SimonRZz/SX1280_QO100_SSB_TX/img/SX1280 GPSDO CW Carrier.png

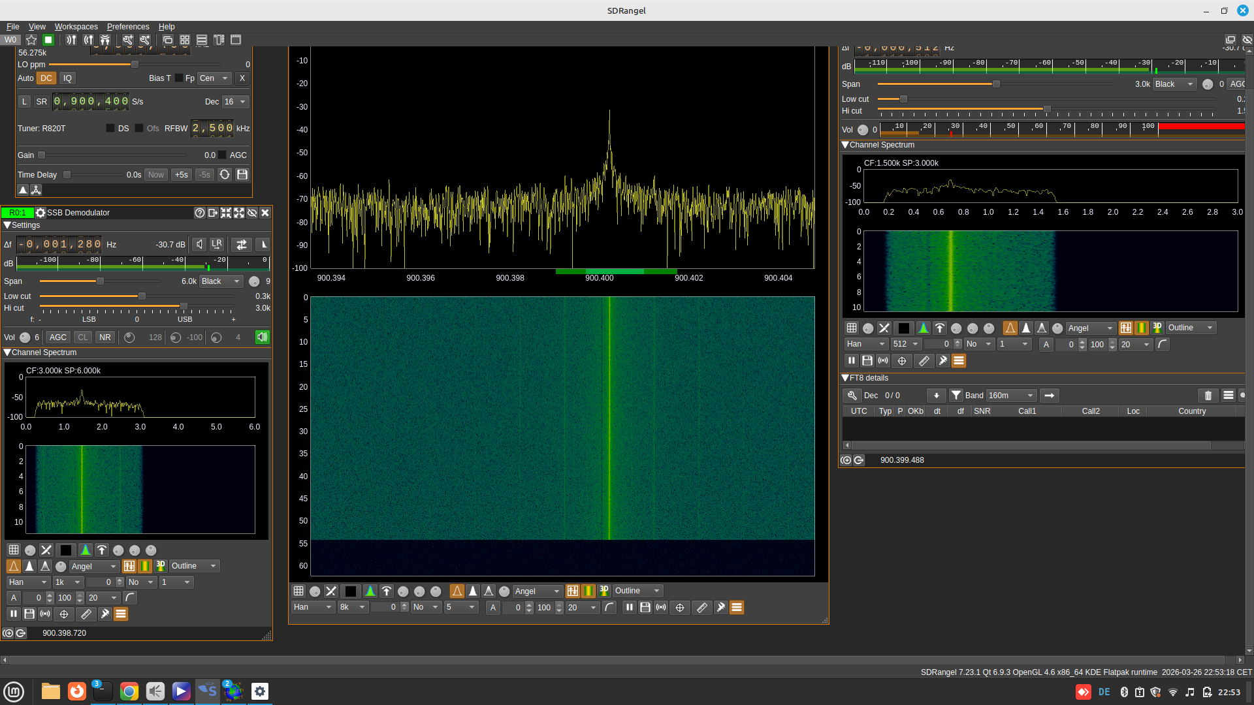
img/SX1280 GPSDO CW Carrier.png
