SimonRZz/SX1280_QO100_SSB_TX/img/SX1280 TCXO FT8.png

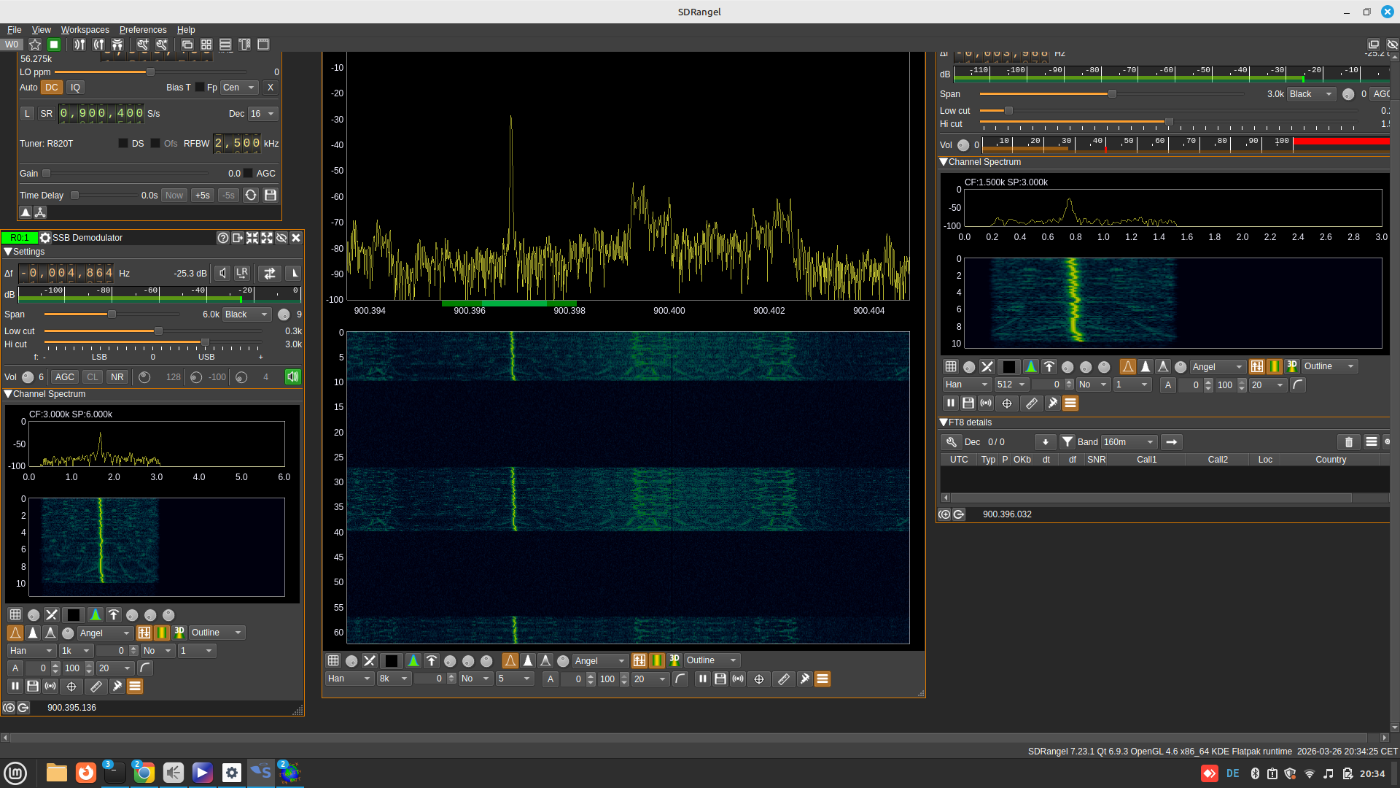
img/SX1280 TCXO FT8.png
