SimonRZz/SX1280_QO100_SSB_TX/main.c

#include <stdint.h>
#include <stdbool.h>
#include <math.h>
#include <string.h>
#include <stdio.h>
#include <stdarg.h>
#include <stdlib.h>

#include "pico/stdlib.h"
#include "pico/multicore.h"
#include "pico/flash.h"
#include "hardware/flash.h"
#include <stddef.h>

#include "hardware/spi.h"
#include "hardware/gpio.h"
#include "hardware/clocks.h"
#include "hardware/i2c.h"
#include "hardware/pwm.h"
#include "hardware/dma.h"
#include "hardware/irq.h"
#include "hardware/adc.h"

// TinyUSB
#include "bsp/board_api.h"
#include "tusb.h"
#include "usb_descriptors.h"

// OLED display
#include "ssd1306.h"

// GPSDO (SI5351 52 MHz clock gen + NEO-7M GPS)
#include "gpsdo.h"
#include "si4732.h"
#include "fw_build_info.h"

#ifndef M_PI
#define M_PI 3.14159265358979323846
#endif

// ================== MODE ==================
#define FIXED_POWER_CW_MODE     0
#define FIXED_TX_POWER_DBM      (13)
// ==========================================

// ================== TEST MODE ==================
#define USE_TEST_TONE       0
#define USE_TWO_TONE_TEST   1

#define TEST_TONE_HZ        1000.0f
#define TEST_TONE2_HZ       1900.0f

#define TEST_TONE_AMPL      0.35f
#define TEST_BLOCK_SAMPLES  8000u
// ===============================================

// ================== DITHER SPEED-UP ==================
#define DITHER_SUBSTEPS     4
// ===============================================

// ================== BUFFERING ==================
#define BLOCK_SAMPLES       256u
#define NUM_BLOCKS          8u   // increased from 2 to prevent underruns
// ===============================================

// ================== UNDERRUN DIAGNOSTICS ==================
#define UNDERRUN_LED_ENABLE   1
#define UNDERRUN_LED_PULSE_MS 20u
// ===============================================

// ================== AUDIO SHAPING (default values) ==================
#define AUDIO_ENABLE_BANDPASS       1
#define AUDIO_BP_LO_HZ              50.0f
#define AUDIO_BP_HI_HZ              2700.0f
#define AUDIO_BP_MAX_STAGES         10      // Max stages (compile-time allocation)
#define AUDIO_BP_DEFAULT_STAGES     7       // Default stages (runtime adjustable, 1-10)
// Each stage = 12 dB/octave, so 7 stages = 84 dB/oct, 10 stages = 120 dB/oct

#define AUDIO_ENABLE_EQ             1
#define EQ_LOW_SHELF_HZ             190.0f
#define EQ_LOW_SHELF_DB             (-2.0f)
#define EQ_HIGH_SHELF_HZ            1700.0f
#define EQ_HIGH_SHELF_DB            (13.5f)
// ===============================================

// ================== COMPRESSION (default values) ==================
#define AUDIO_ENABLE_COMPRESSOR     1
#define COMP_THRESHOLD_DB           (-2.5f)
#define COMP_RATIO                  (6.1f)
#define COMP_ATTACK_MS              (41.1f)
#define COMP_RELEASE_MS             (1595.0f)
#define COMP_MAKEUP_DB              (0.0f)
#define COMP_KNEE_DB                (16.5f)
#define COMP_OUTPUT_LIMIT           (0.940f)
// ===============================================

// ================== FIRMWARE VERSION ==================
#define FW_VERSION      "2.3.1-rx"
#define FW_BUILD        __DATE__ " " __TIME__
// ======================================================

// ================== MODULE VARIANT ==================
// Set to 1 if using LoRa1280F27-TCXO module
// Set to 0 if using SX1280 V1.0 (no PA) with SI5351 52 MHz on XTA
#define USE_TCXO_MODULE     0
// ====================================================

// ---------------- Pin mapping ----------------
static const uint32_t PIN_MISO  = 16;
static const uint32_t PIN_MOSI  = 19;
static const uint32_t PIN_SCK   = 18;
static const uint32_t PIN_NSS   = 17;

static const uint32_t PIN_RX_EN = 14;
static const uint32_t PIN_TX_EN = 15;

static const uint32_t PIN_RESET = 20;
static const uint32_t PIN_BUSY  = 21;

#if USE_TCXO_MODULE
static const uint32_t PIN_TCXO_EN = 22;
#endif

// ---------------- OLED I2C pins ----------------
#define OLED_I2C       i2c1
#define OLED_I2C_BAUD  100000  // 100 kHz — reliable with Pico internal pull-ups (~50 kΩ)
static const uint32_t PIN_OLED_SDA = 6;
static const uint32_t PIN_OLED_SCL = 7;

// ---------------- Encoder + buttons ----------------
static const uint32_t PIN_ENC_A   = 2;   // Encoder phase A
static const uint32_t PIN_ENC_B   = 3;   // Encoder phase B
static const uint32_t PIN_ENC_OK  = 10;  // Encoder push button (GP4 occupied by GPSDO UART1 TX)
static const uint32_t PIN_KEY_DIT = 9;   // CW dit paddle (active LOW, internal pull-up)
static const uint32_t PIN_KEY_DAH = 11;  // CW dah paddle (active LOW, internal pull-up; GP10 used by ENC_OK)

// ---------------- SPI config ----------------
#define SX_SPI spi0
static const uint32_t SX_SPI_BAUD = 18000000;

// ---------------- SX1280 opcodes ----------------
#define OPCODE_SET_STANDBY         0x80
#define OPCODE_SET_FS              0xC1   // Lock PLL without starting TX
#define OPCODE_SET_PACKET_TYPE     0x8A
#define OPCODE_SET_RF_FREQUENCY    0x86
#define OPCODE_SET_TX_PARAMS       0x8E
#define OPCODE_SET_TX_CW           0xD1

// ---------------- RF/audio params ----------------
#define BASE_FREQ_HZ        2400400000u
#define WAV_SAMPLE_RATE     8000u

#define PWR_MAX_DBM         (13)
#define PWR_MIN_DBM         (-18)

#define AMP_GAIN            2.9f
#define AMP_MIN_A           0.000002f

#define RAMP_TIME           0xE0     // 20 us

// --- Runtime RF config (adjustable via CDC) ---
// Frequency stored as double for sub-Hz precision; automatically split into PLL steps + fine DSP offset
static volatile double g_target_freq_hz = (double)BASE_FREQ_HZ;
static volatile float g_ppm_correction = 0.0f;
static volatile uint8_t g_cw_test_mode = 0;  // 1 = CW test active (blocks normal Core1 operation)
static volatile int8_t g_tx_power_max_dbm = PWR_MAX_DBM;  // Runtime TX power limit
static volatile uint8_t g_tx_enabled = 1;  // TX enable flag (for GUI TX button)
static volatile uint8_t g_tx_mode = 0;     // 0 = USB (SSB), 1 = CW
static volatile uint8_t g_tune_active = 0; // 1 = TUNE carrier active
static volatile uint8_t g_ptt_key = 0;     // 1 = dit or dah paddle pressed (live)
static volatile uint8_t g_key_dit = 0;     // dit paddle (GP9), debounced
static volatile uint8_t g_key_dah = 0;     // dah paddle (GP11), debounced
static volatile uint8_t g_soft_ptt_key = 0; // Software PTT/KEY via CDC "key 0|1" (GUI CW keyer)

// --- SSB push-to-talk (GP13) ---
// Without this, SSB keys purely on audio amplitude: with a live microphone
// that is permanent VOX, and any room noise goes on the air. The PTT gates
// microphone transmission. PC audio is left alone, so WSJT-X and friends
// keep working without a hardware switch.
// The PTT is the CW paddle itself — either contact. In SSB the keyer is
// inactive (keyer_poll() returns early unless g_tx_mode == 1), so the paddle
// is free to serve as the press-to-talk lever and needs no extra pin.
static volatile uint8_t g_ptt_required = 1;  // 1 = MIC mode needs the paddle held

// --- On-device CW keyer (paddles GP9/GP11 → element timing in firmware) ---
enum { KEYER_STRAIGHT = 0, KEYER_IAMBIC_A = 1, KEYER_IAMBIC_B = 2 };
static volatile uint8_t g_cw_mode   = KEYER_IAMBIC_B;
static volatile uint8_t g_cw_wpm    = 18;      // 5..60
static volatile float   g_cw_ratio  = 3.0f;    // dah length in dits, 2.0..5.0
static volatile uint8_t g_keyer_key = 0;       // keyer output: 1 = key down
static void keyer_reset(void);
static const char *keyer_mode_name(uint8_t m);
static void keyer_diag_print(void);
static void persist_diag_print(void);

// --- Sidetone (PWM audio on GP12, follows keyer output and TUNE) ---
static volatile uint16_t g_st_hz   = 700;    // 300..1200
static volatile uint8_t  g_st_vol  = 30;     // 0..100
static volatile uint8_t  g_st_test = 0;      // 1 = continuous test tone (not persisted)
static void sidetone_update_params(void);

// --- Audio source: USB from the PC, or the MAX4466 microphone on GP26 (ADC0) ---
enum { AUDIO_SRC_PC = 0, AUDIO_SRC_MIC = 1 };
static volatile uint8_t g_audio_src = AUDIO_SRC_PC;
static volatile float   g_mic_gain  = 10.0f;   // 1..50, applied after DC removal
static volatile float   g_mic_gate  = 0.02f;   // 0..0.5, noise gate threshold on the gained signal
static const char *audio_src_name(uint8_t s);
static void mic_diag_print(void);

// --- Receive audio monitor (Si4732 LOUT on GP27 / ADC1 -> headphones) ---
// Defined down with the microphone, which owns the ADC it borrows.
static void    rxmon_task(void);
static void    rxmon_set(bool on);
static bool    rxmon_is_on(void);
static void    rxmon_set_vol(uint8_t pct);
static bool    rxmon_set_cw(long width_hz, long centre_hz);   // width 0 = off; centre 0 = keep
static void    rxmon_set_level(uint8_t pct);
static void    rxmon_set_maxgain(uint8_t db);
static void    rxmon_set_hang(uint16_t ms);
// Display RSSI/SNR polling over I2C, 5 Hz. Switchable to test it as a
// source of crackle in the headphones. Not persisted.
static volatile bool g_rx_rsq_poll = true;
static uint8_t rxmon_vol_pct(void);
static void    rxmon_set_agc(bool on);
static bool    rxmon_agc_on(void);
static void    rxmon_diag_print(void);
// GPS gate: 1 = TX only when gpsdo_is_ready() (default), 0 = override for bench tests.
// Deliberately not persisted — resets to enforced on every boot.
static volatile uint8_t g_gps_gate = 1;

// Blank the TX for a moment after a mode change, so scrolling through the
// modes on the encoder (or a burst of "mode" commands) cannot emit a stub.
#define TX_MODE_GUARD_MS 120
static volatile uint32_t g_mode_change_ms = 0;
static inline void tx_mode_changed(void) { g_mode_change_ms = to_ms_since_boot(get_absolute_time()); }
static inline bool tx_mode_guard_active(void) {
    return (to_ms_since_boot(get_absolute_time()) - g_mode_change_ms) < TX_MODE_GUARD_MS;
}

// True when the microphone path is held back by the PTT (either paddle contact).
static inline bool ssb_ptt_blocks(void) {
    return (g_tx_mode == 0) && (g_audio_src == AUDIO_SRC_MIC) && g_ptt_required && !g_ptt_key;
}

static inline bool tx_allowed(void) {
    return (gpsdo_is_ready() || !g_gps_gate) && !tx_mode_guard_active();
}

// --- Persistent config (last flash sector) ---
static volatile uint8_t  g_persist_dirty       = 0;  // something worth saving changed
static volatile uint32_t g_persist_dirty_since = 0;  // ms of last change
static uint8_t           g_persist_loaded      = 0;  // 1 = a valid record exists in flash
static int               g_persist_last_rc     = 1;  // last flash_safe_execute() result, 1 = never tried
static uint32_t          g_persist_saves       = 0;  // successful writes since boot

// Last moment the PA was actually driven — SSB block, CW element or TUNE.
// A flash write parks Core1 for ~20 ms, so autosave waits until the radio
// has been quiet for a while.
static volatile uint32_t g_tx_activity_ms = 0;
static inline void tx_activity_mark(void) {
    g_tx_activity_ms = to_ms_since_boot(get_absolute_time());
}

// The main loop autosaves after an idle period, so knob turns don't erase flash repeatedly.
static inline void persist_mark_dirty(void) {
    g_persist_dirty = 1;
    g_persist_dirty_since = to_ms_since_boot(get_absolute_time());
}

// --- Encoder UI state ---
// The frequency stays on top; the lower half shows one of three pages.
// Pages 0 and 1 hold 2x3 tiles (short click = browse), page 2 is GPS info.
// A long press (500 ms) switches to the next page.
typedef enum {
    UI_PARAM_MODE = 0,   // USB PC / USB MIC / CW
    UI_PARAM_TUNE,       // TUNE on/off
    UI_PARAM_WPM,        // keyer speed
    UI_PARAM_TX,         // TX on/off
    UI_PARAM_VOL,        // sidetone volume
    UI_PARAM_PWR,        // TX power dBm
    UI_PARAM_KEYER,      // straight / iambic A / iambic B
    UI_PARAM_RATIO,      // dah length in dits
    UI_PARAM_TONE,       // sidetone pitch
    UI_PARAM_MICGAIN,
    UI_PARAM_MICGATE,
    // --- receive page ---
    UI_PARAM_RXSTEP,     // tuning step of the encoder
    UI_PARAM_RXMODE,     // AM / LSB / USB
    UI_PARAM_RXBW,       // channel filter
    UI_PARAM_RXMON,      // headphone monitor level, 0 = off
    UI_PARAM_RXVOL,      // how hard the Si4732 drives the ADC
    UI_PARAM_RXAGC       // audio AGC
} ui_param_t;

// Encoder steps for receive tuning. 10 Hz is what SSB needs, 9 kHz is the
// channel spacing of the broadcast bands outside the Americas.
static const uint32_t k_rx_steps[]  = { 10u, 100u, 1000u, 5000u, 9000u };
static const char * const k_rx_step_names[] = { "10 Hz", "100 Hz", "1 kHz", "5 kHz", "9 kHz" };
#define RX_STEP_N  (sizeof k_rx_steps / sizeof k_rx_steps[0])
static volatile uint8_t g_rx_step_idx = 2;      // 1 kHz

// The filters the Si4732 actually has; si4732_set_bandwidth_hz() snaps to the
// nearest, so stepping through this list cannot land between two of them.
static const uint16_t k_rx_bws[] = { 1000u, 1800u, 2000u, 2500u, 3000u, 4000u, 6000u };
#define RX_BW_N    (sizeof k_rx_bws / sizeof k_rx_bws[0])

// Signal quality for the display, refreshed on a timer by rxmon_task(). Read
// directly in the draw path it would put an I2C transfer inside the frame
// that is also built from the transmit wait loops.
static volatile uint8_t g_rx_rssi = 0, g_rx_snr = 0;

// Where the dial has been turned to. A tune is an I2C exchange that waits for
// the chip's tune-complete flag, so doing one per encoder detent would make
// the dial stick. The encoder only writes this; rxmon_task() applies it, at
// most every 30 ms, so spinning the knob costs one tune and not fifty.
static volatile uint32_t g_rx_want_hz  = 0;
static volatile bool     g_rx_want     = false;

static inline uint32_t rx_shown_hz(void) {
    return g_rx_want ? g_rx_want_hz : si4732_get_hz();
}

typedef enum {
    UI_STATE_IDLE = 0,   // encoder = frequency; click = browse tiles; hold = next page
    UI_STATE_BROWSE,     // frame around a tile, rotate moves cursor; hold = back
    UI_STATE_EDITING     // tile inverted, rotate adjusts value; hold = back
} ui_state_t;

#define UI_PAGES         4                    // 0 operating, 1 CW/audio, 2 GPS, 3 receive
#define UI_TILES         6                    // 2 columns x 3 rows on tile pages
#define UI_TIMEOUT_MS    5000                 // BROWSE/EDITING fall back to IDLE
#define UI_LONG_PRESS_MS 500

static const ui_param_t k_page_tiles[3][UI_TILES] = {
    { UI_PARAM_MODE,  UI_PARAM_TUNE,  UI_PARAM_WPM, UI_PARAM_TX,   UI_PARAM_VOL,     UI_PARAM_PWR     },
    { UI_PARAM_KEYER, UI_PARAM_RATIO, UI_PARAM_WPM, UI_PARAM_TONE, UI_PARAM_MICGAIN, UI_PARAM_MICGATE },
    { UI_PARAM_RXSTEP, UI_PARAM_RXMODE, UI_PARAM_RXBW, UI_PARAM_RXMON, UI_PARAM_RXVOL, UI_PARAM_RXAGC },
};

// Which row of k_page_tiles a page uses; -1 for a page that has no tiles.
// Page 2 (GPS) is display-only, so the mapping is not the identity.
static int ui_tile_row(uint8_t page)
{
    switch (page) {
        case 0:  return 0;
        case 1:  return 1;
        case 3:  return 2;
        default: return -1;
    }
}

static volatile ui_state_t g_ui_state = UI_STATE_IDLE;
static volatile uint8_t    g_ui_page = 0;                  // 0 operating, 1 CW/audio, 2 GPS info
static volatile uint8_t    g_ui_cursor_idx = 0;            // tile index on the current page
static volatile ui_param_t g_ui_cursor = UI_PARAM_MODE;    // param under the cursor (derived)
static volatile ui_param_t g_ui_editing = UI_PARAM_MODE;   // which param is being edited
static volatile uint32_t   g_ui_last_activity_ms = 0;      // for auto-timeout
// OLED noise isolation, not persisted. g_oled_freeze stops the frame
// refresh (I2C1 bursts at 5 Hz) but leaves the panel lit; g_oled_off also
// switches the panel and its charge pump off. Between them they separate the
// two ways the display can get into a receiver.
static volatile uint8_t    g_oled_freeze = 0;
static volatile uint8_t    g_oled_off    = 0;
static volatile uint8_t    g_oled_flip = 1;                // 180 degree rotation; 1 suits how the box is built

// Blink phase for warnings on the display (2 Hz; the panel refreshes at 5 fps)
static inline bool ui_blink(void) {
    return ((to_ms_since_boot(get_absolute_time()) / 500u) & 1u) != 0u;
}

// --- Hilbert ---
#define HILBERT_TAPS        247

// --- PLL step ---
static const float PLL_STEP_HZ =
    (float)(52000000.0 / (double)(1u << 18)); // ~198.364 Hz

#define F_OFF_LIMIT_HZ      3500.0f
#define SILENCE_SECONDS     2u

#define GATE_A_REF          0.01f   // Noise gate threshold - higher with compressor
#define GATE_SHAPE          1

#define IQ_GAIN_CORR        1.00f
#define IQ_PHASE_CORR_DEG   0.0f

// ---------------- Command buffer ----------------
typedef struct {
    int32_t  freq_steps;
    int8_t   p_dbm;
    uint8_t  tx_on;
} sample_cmd_t;

static sample_cmd_t g_blocks[NUM_BLOCKS][BLOCK_SAMPLES];

static volatile uint32_t g_prod_block = 0;
static volatile uint32_t g_cons_block = 0;
static volatile uint8_t  g_block_ready[NUM_BLOCKS] = {0};
static volatile uint32_t g_underruns = 0;
static volatile uint8_t  g_core1_start = 0; 

// ==========================================================
// USB AUDIO IN (from PC) -> ringbuffer -> resampler to 8k mono
// ==========================================================

typedef struct { int16_t l, r; } stereo16_t;

// Power-of-two
#ifndef USB_RB_FRAMES
#define USB_RB_FRAMES 8192u
#endif

#if (USB_RB_FRAMES & (USB_RB_FRAMES - 1u)) != 0
#error "USB_RB_FRAMES must be power-of-two"
#endif

static stereo16_t g_usb_rb[USB_RB_FRAMES];
static volatile uint32_t g_usb_w = 0;
static volatile uint32_t g_usb_r = 0;

static volatile uint32_t g_usb_sample_rate_hz = 48000u; // current host SR

static inline uint32_t usb_rb_next(uint32_t x) { return (x + 1u) & (USB_RB_FRAMES - 1u); }

static inline bool usb_rb_push(stereo16_t s) {
    uint32_t w = g_usb_w;
    uint32_t n = usb_rb_next(w);
    if (n == g_usb_r) return false; // full
    g_usb_rb[w] = s;
    g_usb_w = n;
    return true;
}

static inline bool usb_rb_pop(stereo16_t *out) {
    uint32_t r = g_usb_r;
    if (r == g_usb_w) return false; // empty
    *out = g_usb_rb[r];
    g_usb_r = usb_rb_next(r);
    return true;
}

static inline int16_t clamp16(int32_t x) {
    if (x > 32767) return 32767;
    if (x < -32768) return -32768;
    return (int16_t)x;
}

// Read host audio (PCM16LE stereo), push to ringbuffer
static void usb_audio_pump(void);

// Resampler: host SR stereo -> 8 kHz mono
// With smoothed adaptive rate to prevent buffer overflow and pitch artifacts
static int16_t usb_audio_get_mono_8k(void) {
    static uint32_t src_rate = 48000u;
    static uint32_t base_step_q16 = 0;
    static uint32_t smooth_step_q16 = 0;  // Smoothed step for gradual changes
    static uint32_t phase_q16 = 0;

    static stereo16_t s0 = {0,0};
    static stereo16_t s1 = {0,0};
    static stereo16_t s2 = {0,0};  // Extra sample for cubic interpolation
    static stereo16_t sm1 = {0,0}; // s[-1] for cubic
    static bool primed = false;

    uint32_t sr = g_usb_sample_rate_hz;
    if (!sr) sr = 48000u;

    if (sr != src_rate || base_step_q16 == 0) {
        src_rate = sr;
        base_step_q16 = (uint32_t)(((uint64_t)src_rate << 16) / (uint32_t)WAV_SAMPLE_RATE);
        smooth_step_q16 = base_step_q16;
    }

    // *** Adaptive rate with heavy smoothing ***
    uint32_t usb_w = g_usb_w;
    uint32_t usb_r = g_usb_r;
    uint32_t fill = (usb_w >= usb_r) ? (usb_w - usb_r) : (USB_RB_FRAMES - usb_r + usb_w);
    
    const uint32_t target_fill = USB_RB_FRAMES / 2;
    uint32_t target_step = base_step_q16;
    
    if (fill > target_fill) {
        uint32_t excess = fill - target_fill;
        uint32_t adj = (base_step_q16 * excess) / (USB_RB_FRAMES * 10);
        target_step = base_step_q16 + adj;
    } else if (fill < target_fill) {
        uint32_t deficit = target_fill - fill;
        uint32_t adj = (base_step_q16 * deficit) / (USB_RB_FRAMES * 10);
        target_step = base_step_q16 - adj;
    }
    
    // Heavy smoothing: move only 1/256 of the way to target each sample
    // This prevents audible pitch wobble
    if (smooth_step_q16 < target_step) {
        uint32_t diff = target_step - smooth_step_q16;
        smooth_step_q16 += (diff >> 8) + 1;
        if (smooth_step_q16 > target_step) smooth_step_q16 = target_step;
    } else if (smooth_step_q16 > target_step) {
        uint32_t diff = smooth_step_q16 - target_step;
        smooth_step_q16 -= (diff >> 8) + 1;
        if (smooth_step_q16 < target_step) smooth_step_q16 = target_step;
    }

    if (!primed) {
        if (!usb_rb_pop(&sm1)) sm1 = (stereo16_t){0,0};
        if (!usb_rb_pop(&s0)) s0 = (stereo16_t){0,0};
        if (!usb_rb_pop(&s1)) s1 = (stereo16_t){0,0};
        if (!usb_rb_pop(&s2)) s2 = (stereo16_t){0,0};
        phase_q16 = 0;
        primed = true;
    }

    phase_q16 += smooth_step_q16;
    while (phase_q16 >= (1u << 16)) {
        phase_q16 -= (1u << 16);
        sm1 = s0;
        s0 = s1;
        s1 = s2;
        if (!usb_rb_pop(&s2)) s2 = s1;  // Hold last value if empty
    }

    // Cubic Hermite interpolation for smoother audio
    float t = (float)phase_q16 / 65536.0f;
    float t2 = t * t;
    float t3 = t2 * t;
    
    // Hermite basis functions
    float h00 = 2*t3 - 3*t2 + 1;
    float h10 = t3 - 2*t2 + t;
    float h01 = -2*t3 + 3*t2;
    float h11 = t3 - t2;
    
    // Left channel
    float m0_l = (float)(s1.l - sm1.l) * 0.5f;
    float m1_l = (float)(s2.l - s0.l) * 0.5f;
    float l = h00 * s0.l + h10 * m0_l + h01 * s1.l + h11 * m1_l;
    
    // Right channel
    float m0_r = (float)(s1.r - sm1.r) * 0.5f;
    float m1_r = (float)(s2.r - s0.r) * 0.5f;
    float r = h00 * s0.r + h10 * m0_r + h01 * s1.r + h11 * m1_r;

    float mono = (l + r) * 0.5f;
    return clamp16((int32_t)mono);
}

// ==========================================================
// TinyUSB UAC1 control callbacks (sampling freq + feature unit)
// ==========================================================

// Minimal feature unit state (żeby Windows nie marudził)
static uint8_t  g_mute[CFG_TUD_AUDIO_FUNC_1_N_CHANNELS_RX + 1];
static int16_t  g_volume[CFG_TUD_AUDIO_FUNC_1_N_CHANNELS_RX + 1]; // 1/256 dB

bool tud_audio_set_itf_cb(uint8_t rhport, tusb_control_request_t const *p_request) {
    (void)rhport;
    (void)p_request;
    return true;
}

bool tud_audio_set_itf_close_ep_cb(uint8_t rhport, tusb_control_request_t const *p_request) {
    (void)rhport;
    (void)p_request;
    return true;
}

// EP sampling freq (UAC1)
bool tud_audio_set_req_ep_cb(uint8_t rhport, tusb_control_request_t const *p_request, uint8_t *pBuff) {
    (void)rhport;
    uint8_t ctrlSel = TU_U16_HIGH(p_request->wValue);

    if (ctrlSel == AUDIO10_EP_CTRL_SAMPLING_FREQ &&
        p_request->bRequest == AUDIO10_CS_REQ_SET_CUR) {
        TU_VERIFY(p_request->wLength == 3);
        uint32_t sr = tu_unaligned_read32(pBuff) & 0x00FFFFFF;
        if (sr) g_usb_sample_rate_hz = sr;
        return true;
    }
    return false;
}

bool tud_audio_get_req_ep_cb(uint8_t rhport, tusb_control_request_t const *p_request) {
    uint8_t ctrlSel = TU_U16_HIGH(p_request->wValue);

    if (ctrlSel == AUDIO10_EP_CTRL_SAMPLING_FREQ &&
        p_request->bRequest == AUDIO10_CS_REQ_GET_CUR) {
        uint32_t sr = g_usb_sample_rate_hz;
        uint8_t freq[3] = {
            (uint8_t)(sr & 0xFF),
            (uint8_t)((sr >> 8) & 0xFF),
            (uint8_t)((sr >> 16) & 0xFF)
        };
        return tud_audio_buffer_and_schedule_control_xfer(rhport, p_request, freq, sizeof(freq));
    }
    return false;
}

// Feature Unit (mute/volume) – UAC1 entity callbacks
bool tud_audio_set_req_entity_cb(uint8_t rhport, tusb_control_request_t const *p_request, uint8_t *buf) {
    (void)rhport;

    uint8_t channelNum = TU_U16_LOW(p_request->wValue);
    uint8_t ctrlSel    = TU_U16_HIGH(p_request->wValue);
    uint8_t entityID   = TU_U16_HIGH(p_request->wIndex);

    if (entityID != UAC1_ENTITY_FEATURE_UNIT) return false;

    switch (ctrlSel) {
        case AUDIO10_FU_CTRL_MUTE:
            if (p_request->bRequest == AUDIO10_CS_REQ_SET_CUR) {
                TU_VERIFY(p_request->wLength == 1);
                g_mute[channelNum] = buf[0];
                return true;
            }
            return false;

        case AUDIO10_FU_CTRL_VOLUME:
            if (p_request->bRequest == AUDIO10_CS_REQ_SET_CUR) {
                TU_VERIFY(p_request->wLength == 2);
                g_volume[channelNum] = (int16_t) tu_unaligned_read16(buf); // 1/256 dB
                return true;
            }
            return false;

        default:
            return false;
    }
}

bool tud_audio_get_req_entity_cb(uint8_t rhport, tusb_control_request_t const *p_request) {
    uint8_t channelNum = TU_U16_LOW(p_request->wValue);
    uint8_t ctrlSel    = TU_U16_HIGH(p_request->wValue);
    uint8_t entityID   = TU_U16_HIGH(p_request->wIndex);

    if (entityID != UAC1_ENTITY_FEATURE_UNIT) return false;

    switch (ctrlSel) {
        case AUDIO10_FU_CTRL_MUTE:
            return tud_audio_buffer_and_schedule_control_xfer(rhport, p_request, &g_mute[channelNum], 1);

        case AUDIO10_FU_CTRL_VOLUME:
            switch (p_request->bRequest) {
                case AUDIO10_CS_REQ_GET_CUR:
                    return tud_audio_buffer_and_schedule_control_xfer(rhport, p_request, &g_volume[channelNum], sizeof(g_volume[channelNum]));
                case AUDIO10_CS_REQ_GET_MIN: {
                    int16_t min = (int16_t)(-90 * 256);
                    return tud_audio_buffer_and_schedule_control_xfer(rhport, p_request, &min, sizeof(min));
                }
                case AUDIO10_CS_REQ_GET_MAX: {
                    int16_t max = (int16_t)(0 * 256);
                    return tud_audio_buffer_and_schedule_control_xfer(rhport, p_request, &max, sizeof(max));
                }
                case AUDIO10_CS_REQ_GET_RES: {
                    int16_t res = (int16_t)(1 * 256);
                    return tud_audio_buffer_and_schedule_control_xfer(rhport, p_request, &res, sizeof(res));
                }
                default:
                    return false;
            }

        default:
            return false;
    }
}

#if CFG_TUD_AUDIO_ENABLE_FEEDBACK_EP
// Feedback method (dla UAC1 speaker+feedback)
void tud_audio_feedback_params_cb(uint8_t func_id, uint8_t alt_itf, audio_feedback_params_t *feedback_param) {
    (void)func_id;
    (void)alt_itf;
    feedback_param->method = AUDIO_FEEDBACK_METHOD_FIFO_COUNT;
    feedback_param->sample_freq = g_usb_sample_rate_hz ? g_usb_sample_rate_hz : 48000u;
}
#endif

// ==========================================================
// SX1280 low-level radio I/O (CORE1 ONLY)
// ==========================================================
static inline void cs_select(void)   { gpio_put(PIN_NSS, 0); }
static inline void cs_deselect(void) { gpio_put(PIN_NSS, 1); }

static inline void sx_wait_busy(void) {
    while (gpio_get(PIN_BUSY)) { tight_loop_contents(); }
}

// Forward declarations for CDC functions
static void cdc_printf(const char *fmt, ...);
static void cdc_write_str(const char *s);

static void sx_write_cmd(uint8_t opcode, const uint8_t *params, size_t len) {
    sx_wait_busy();
    cs_select();
    spi_write_blocking(SX_SPI, &opcode, 1);
    if (len && params) {
        spi_write_blocking(SX_SPI, params, len);
    }
    cs_deselect();
    sx_wait_busy();
}

static inline void sx_set_standby_rc(void) {
    uint8_t cfg = 0x00;  // STDBY_RC
    sx_write_cmd(OPCODE_SET_STANDBY, &cfg, 1);
}

static inline void sx_set_standby_xosc(void) {
    uint8_t cfg = 0x01;  // STDBY_XOSC - required for TCXO module
    sx_write_cmd(OPCODE_SET_STANDBY, &cfg, 1);
}

static inline void sx_set_packet_type_gfsk(void) {
    uint8_t pt = 0x00; // GFSK
    sx_write_cmd(OPCODE_SET_PACKET_TYPE, &pt, 1);
}

static inline uint8_t sx_encode_power_dbm(int32_t dbm) {
    if (dbm > 13)  dbm = 13;
    if (dbm < -18) dbm = -18;
    return (uint8_t)(dbm + 18); // 0..31
}

static inline void sx_set_tx_params_dbm(int32_t power_dbm) {
    uint8_t pwr = sx_encode_power_dbm(power_dbm);
    uint8_t p[2] = { pwr, RAMP_TIME };
    sx_write_cmd(OPCODE_SET_TX_PARAMS, p, 2);
}

static inline void sx_start_tx_continuous_wave(void) {
    sx_write_cmd(OPCODE_SET_TX_CW, NULL, 0);
}

static inline void sx_set_rf_frequency_steps(uint32_t steps) {
    uint8_t p[3] = {
        (uint8_t)(steps >> 16),
        (uint8_t)(steps >> 8),
        (uint8_t)(steps)
    };
    sx_write_cmd(OPCODE_SET_RF_FREQUENCY, p, 3);
}

static inline uint32_t hz_to_steps(uint32_t freq_hz) {
    return (uint32_t)((double)freq_hz / (double)PLL_STEP_HZ);
}

// Calculate corrected frequency with PPM
static inline double get_corrected_freq_hz(void) {
    return g_target_freq_hz * (1.0 + (double)g_ppm_correction / 1000000.0);
}

// Get base PLL steps (integer part)
static inline uint32_t get_base_steps(void) {
    double corrected_hz = get_corrected_freq_hz();
    return (uint32_t)(corrected_hz / (double)PLL_STEP_HZ);
}

// Get fine tune offset in Hz (fractional part that PLL can't reach)
static inline float get_fine_tune_hz(void) {
    double corrected_hz = get_corrected_freq_hz();
    uint32_t base_steps = (uint32_t)(corrected_hz / (double)PLL_STEP_HZ);
    double base_hz = (double)base_steps * (double)PLL_STEP_HZ;
    return (float)(corrected_hz - base_hz);
}

// Get SX1280 status byte
static uint8_t sx_get_status(void) {
    sx_wait_busy();
    cs_select();
    uint8_t cmd = 0xC0;  // GetStatus opcode
    uint8_t status;
    spi_write_blocking(SX_SPI, &cmd, 1);
    spi_read_blocking(SX_SPI, 0x00, &status, 1);
    cs_deselect();
    return status;
}

// Diagnostic: print SX1280 state via CDC
static void sx_print_diag(void) {
#if CFG_TUD_CDC
    uint8_t status = sx_get_status();
    uint8_t mode = (status >> 5) & 0x07;
    
    const char *mode_str = "UNKNOWN";
    switch (mode) {
        case 2: mode_str = "STDBY_RC"; break;
        case 3: mode_str = "STDBY_XOSC"; break;
        case 4: mode_str = "FS"; break;
        case 5: mode_str = "RX"; break;
        case 6: mode_str = "TX"; break;
    }
    
    cdc_printf("\r\n=== SX1280 Diagnostics ===\r\n");
    cdc_printf("Status: 0x%02X (mode=%d: %s)\r\n", status, mode, mode_str);
    cdc_printf("BUSY pin: %d\r\n", gpio_get(PIN_BUSY));
    cdc_printf("TX_EN pin: %d\r\n", gpio_get(PIN_TX_EN));
    cdc_printf("RX_EN pin: %d\r\n", gpio_get(PIN_RX_EN));
#if USE_TCXO_MODULE
    cdc_printf("TCXO_EN pin: %d\r\n", gpio_get(PIN_TCXO_EN));
#endif
    cdc_printf("Base freq: %lu Hz\r\n", (unsigned long)BASE_FREQ_HZ);
    cdc_printf("TX power max: %d dBm\r\n", g_tx_power_max_dbm);
    
    // Buffer diagnostics
    uint32_t prod = g_prod_block;
    uint32_t cons = g_cons_block;
    uint32_t ready_count = 0;
    for (uint32_t i = 0; i < NUM_BLOCKS; i++) {
        if (g_block_ready[i]) ready_count++;
    }
    cdc_printf("Blocks: prod=%lu cons=%lu ready=%lu/%lu\r\n", 
               (unsigned long)prod, (unsigned long)cons, 
               (unsigned long)ready_count, (unsigned long)NUM_BLOCKS);
    cdc_printf("Underruns: %lu\r\n", (unsigned long)g_underruns);
    
    // USB audio buffer
    uint32_t usb_w = g_usb_w;
    uint32_t usb_r = g_usb_r;
    uint32_t usb_fill = (usb_w >= usb_r) ? (usb_w - usb_r) : (USB_RB_FRAMES - usb_r + usb_w);
    cdc_printf("USB ringbuf: %lu/%lu frames\r\n", (unsigned long)usb_fill, (unsigned long)USB_RB_FRAMES);
    persist_diag_print();
    keyer_diag_print();
    cdc_printf("==========================\r\n");
#endif
}

// Apply current freq + power to SX1280 while in CW/TUNE mode.
// Uses fractional-step dithering for sub-PLL-step precision (same as SSB).
// Call repeatedly from carrier_poll() — each call advances the dither accumulator.
static float g_cw_freq_acc = 0.0f;  // Fractional step accumulator for CW dithering
static int8_t g_cr_pwr = PWR_MIN_DBM; // Power currently applied to the carrier (ramped by carrier_poll)

static void tune_apply_settings(void) {
    uint32_t base = get_base_steps();
    float fine_hz = get_fine_tune_hz();

    // Dither: accumulate fractional PLL step, toggle +1 when it overflows
    float want_frac = fine_hz / PLL_STEP_HZ;
    int32_t Nf = (int32_t)floorf(want_frac);
    float ffrac = want_frac - (float)Nf;

    g_cw_freq_acc += ffrac;
    int32_t chosen = Nf;
    if (g_cw_freq_acc >= 1.0f) {
        chosen = Nf + 1;
        g_cw_freq_acc -= 1.0f;
    }

    sx_set_rf_frequency_steps((uint32_t)((int32_t)base + chosen));
    sx_set_tx_params_dbm(g_cr_pwr);
}

// Pump USB while waiting (keep USB alive during short delays)
static void usb_aware_delay_ms(uint32_t ms) {
    uint32_t start = to_ms_since_boot(get_absolute_time());
    while ((to_ms_since_boot(get_absolute_time()) - start) < ms) {
        tud_task();
    }
}

// Start CW/TUNE carrier (Core0 only).
// PRECONDITION: g_cw_test_mode must already be 1 and Core1 must be idle.
static void sx_start_carrier(void) {
    // Ensure TCXO is on (pump USB while waiting)
#if USE_TCXO_MODULE
    gpio_put(PIN_TCXO_EN, 1);
    usb_aware_delay_ms(5);
#endif

    // Full clean init: standby -> packet type -> freq -> power -> CW
#if USE_TCXO_MODULE
    sx_set_standby_xosc();
#else
    sx_set_standby_rc();
#endif

    sx_set_packet_type_gfsk();

    uint32_t steps = get_base_steps();
    sx_set_rf_frequency_steps(steps);
    // Start at minimum power; carrier_poll() ramps up in 1 dB steps (click-free keying).
    g_cr_pwr = PWR_MIN_DBM;
    sx_set_tx_params_dbm(g_cr_pwr);

    gpio_put(PIN_TX_EN, 1);
    gpio_put(PIN_RX_EN, 0);

    sx_start_tx_continuous_wave();
    usb_aware_delay_ms(2);

    // Safety: re-apply frequency AFTER CW start
    sx_set_rf_frequency_steps(steps);
}

// Stop CW carrier and restore for SSB (Core0 only)
static void sx_stop_carrier(void) {
#if USE_TCXO_MODULE
    sx_set_standby_xosc();
#else
    sx_set_standby_rc();
#endif

    // Re-initialize radio for normal SSB operation
    sx_set_packet_type_gfsk();
    sx_set_rf_frequency_steps(get_base_steps());
    sx_set_tx_params_dbm((int32_t)g_tx_power_max_dbm);

    gpio_put(PIN_TX_EN, 1);
    gpio_put(PIN_RX_EN, 0);

    // Resume normal Core1 operation
    g_cw_test_mode = 0;
    __compiler_memory_barrier();
}

#define CW_ARM_WAIT_MS  35  // Time to wait for Core1 to finish SPI (> 1 block = 32ms)
// Key-click suppression: power ramps 1 dB per step, 31 steps (-18..+13 dBm) ≈ 5 ms.
#define CW_RAMP_STEP_US 160

// Start CW/TUNE transmission (legacy wrapper with CDC logging)
// This is a blocking call (used by CDC "cw" command and TUNE encoder action).
// It idles Core1, waits (USB-aware), then starts carrier.
static void sx_test_cw(void) {
#if CFG_TUD_CDC
    cdc_printf("\r\n*** Starting CW/TUNE ***\r\n");
#endif
    // Idle Core1 and wait (USB-aware, not blocking)
    if (!g_cw_test_mode) {
        g_cw_test_mode = 1;
        __compiler_memory_barrier();
        usb_aware_delay_ms(CW_ARM_WAIT_MS);
    }
    sx_start_carrier();
#if CFG_TUD_CDC
    uint8_t status = sx_get_status();
    cdc_printf("TUNE: freq=%.1f Hz, steps=%lu, pwr=%d dBm, status=0x%02X\r\n",
               get_corrected_freq_hz(), (unsigned long)get_base_steps(),
               g_tx_power_max_dbm, status);
#endif
}

// Stop CW transmission and restore normal SSB mode (legacy wrapper)
static void sx_stop_cw(void) {
    sx_stop_carrier();
#if CFG_TUD_CDC
    cdc_printf("TX stopped, radio re-initialized for SSB\r\n");
#endif
}

// ==========================================================
// Unified carrier state machine (runs on Core0 in polling loop)
//
// Inputs:  g_tx_mode (0=USB, 1=CW), g_tune_active, g_ptt_key
// Outputs: g_cw_test_mode, SPI carrier on/off
//
// Logic:
//   need_idle  = (g_tx_mode==1) || g_tune_active     → Core1 must idle
//   need_carrier = g_tune_active || (g_tx_mode==1 && g_ptt_key)  → CW on
//
// States:
//   IDLE    → need_idle? set g_cw_test_mode=1, go ARMING
//   ARMING  → wait 35ms for Core1, go ARMED
//   ARMED   → need_carrier? sx_start_carrier → CARRIER_ON
//   CARRIER_ON → !need_carrier? standby → ARMED
//   any     → !need_idle? stop carrier if on, clear g_cw_test_mode → IDLE
// ==========================================================
typedef enum {
    CR_ST_IDLE = 0,     // Normal SSB mode — Core1 owns SPI
    CR_ST_ARMING,       // g_cw_test_mode=1 set, waiting for Core1 to idle
    CR_ST_ARMED,        // Core1 is idle, no carrier (standby)
    CR_ST_CARRIER_ON    // CW carrier active
} carrier_state_t;

static carrier_state_t g_cr_state = CR_ST_IDLE;
static uint32_t        g_cr_arm_start_ms = 0;
static uint64_t        g_cr_ramp_next_us = 0;

static void carrier_poll(void) {
    bool mode_cw     = (g_tx_mode == 1);
    bool tune        = (bool)g_tune_active;
    if (!mode_cw && g_keyer_key) keyer_reset();   // never leave a key hanging after a mode switch
    bool key         = (bool)(g_keyer_key | g_soft_ptt_key);

    bool need_idle    = mode_cw || tune;
    bool need_carrier = tx_allowed() && (tune || (mode_cw && key));
    if (need_carrier) tx_activity_mark();

    uint32_t now = to_ms_since_boot(get_absolute_time());

    switch (g_cr_state) {

    case CR_ST_IDLE:
        if (need_idle) {
            g_cw_test_mode = 1;
            __compiler_memory_barrier();
            g_cr_arm_start_ms = now;
            g_cr_state = CR_ST_ARMING;
        }
        break;

    case CR_ST_ARMING:
        if (!need_idle) {
            // No longer need idle — cancel
            g_cw_test_mode = 0;
            __compiler_memory_barrier();
            g_cr_state = CR_ST_IDLE;
            break;
        }
        if ((now - g_cr_arm_start_ms) >= CW_ARM_WAIT_MS) {
            // Core1 is now idle — force radio to known standby state
            // (Core1 may have left it in TX from SSB)
#if USE_TCXO_MODULE
            sx_set_standby_xosc();
#else
            sx_set_standby_rc();
#endif
            g_cr_state = CR_ST_ARMED;
        }
        break;

    case CR_ST_ARMED:
        if (!need_idle) {
            // Return to SSB — restore Core1
            g_cw_test_mode = 0;
            __compiler_memory_barrier();
            g_cr_state = CR_ST_IDLE;
            break;
        }
        if (need_carrier) {
            g_cw_freq_acc = 0.0f;  // Reset dither accumulator
            sx_start_carrier();    // starts at PWR_MIN_DBM
            g_cr_ramp_next_us = 0; // first ramp step immediately
            g_cr_state = CR_ST_CARRIER_ON;
        }
        break;

    case CR_ST_CARRIER_ON: {
        if (!need_idle) {
            // Leaving CW/TUNE entirely — full stop + restore SSB
            sx_stop_carrier();   // clears g_cw_test_mode
            g_cr_state = CR_ST_IDLE;
            break;
        }
        uint64_t now_us = time_us_64();

        // Power envelope: ramp toward max while keyed, toward min on key-up.
        // A key-down during the tail simply reverses direction — no re-init.
        int8_t target = need_carrier ? g_tx_power_max_dbm : (int8_t)PWR_MIN_DBM;
        if (g_cr_pwr != target && now_us >= g_cr_ramp_next_us) {
            g_cr_pwr += (target > g_cr_pwr) ? 1 : -1;
            sx_set_tx_params_dbm(g_cr_pwr);
            g_cr_ramp_next_us = now_us + CW_RAMP_STEP_US;
        }
        if (!need_carrier && g_cr_pwr <= PWR_MIN_DBM) {
            // Tail finished — carrier off but stay armed (key released, or TUNE off in CW mode)
#if USE_TCXO_MODULE
            sx_set_standby_xosc();
#else
            sx_set_standby_rc();
#endif
            g_cr_state = CR_ST_ARMED;
            break;
        }
        // Carrier on — dither freq at ~8 kHz (125 µs), same rate as SSB
        static uint64_t next_dither_us = 0;
        if (now_us >= next_dither_us) {
            tune_apply_settings();
            next_dither_us = now_us + 125;  // 125 µs = 8 kHz
        }
        break;
    }
    }
}

// ==========================================================
// DSP blocks (biquads + compressor + hilbert)
// ==========================================================
typedef struct {
    float b0, b1, b2;
    float a1, a2;
    float z1, z2;
} biquad_t;

static inline void biquad_reset(biquad_t *q) { q->z1 = 0.0f; q->z2 = 0.0f; }

static inline float biquad_process(biquad_t *q, float x) {
    float y = q->b0 * x + q->z1;
    q->z1 = q->b1 * x - q->a1 * y + q->z2;
    q->z2 = q->b2 * x - q->a2 * y;
    return y;
}

static void biquad_init_lowpass_bw2(biquad_t *q, float fc, float fs) {
    const float K  = tanf((float)M_PI * fc / fs);
    const float K2 = K * K;
    const float s2 = 1.41421356f;
    const float norm = 1.0f / (1.0f + s2 * K + K2);

    q->b0 = K2 * norm;
    q->b1 = 2.0f * q->b0;
    q->b2 = q->b0;

    q->a1 = 2.0f * (K2 - 1.0f) * norm;
    q->a2 = (1.0f - s2 * K + K2) * norm;

    biquad_reset(q);
}

static void biquad_init_highpass_bw2(biquad_t *q, float fc, float fs) {
    const float K  = tanf((float)M_PI * fc / fs);
    const float K2 = K * K;
    const float s2 = 1.41421356f;
    const float norm = 1.0f / (1.0f + s2 * K + K2);

    q->b0 = 1.0f * norm;
    q->b1 = -2.0f * q->b0;
    q->b2 = q->b0;

    q->a1 = 2.0f * (K2 - 1.0f) * norm;
    q->a2 = (1.0f - s2 * K + K2) * norm;

    biquad_reset(q);
}

static void biquad_init_low_shelf(biquad_t *q, float fc, float fs, float gain_db) {
    const float A = powf(10.0f, gain_db / 40.0f);
    const float w0 = 2.0f * (float)M_PI * fc / fs;
    const float cw = cosf(w0);
    const float sw = sinf(w0);
    const float alpha = sw * 0.5f * 1.41421356f;

    float b0 =    A*((A+1.0f) - (A-1.0f)*cw + 2.0f*sqrtf(A)*alpha);
    float b1 =  2.0f*A*((A-1.0f) - (A+1.0f)*cw);
    float b2 =    A*((A+1.0f) - (A-1.0f)*cw - 2.0f*sqrtf(A)*alpha);
    float a0 =        (A+1.0f) + (A-1.0f)*cw + 2.0f*sqrtf(A)*alpha;
    float a1 =   -2.0f*((A-1.0f) + (A+1.0f)*cw);
    float a2 =        (A+1.0f) + (A-1.0f)*cw - 2.0f*sqrtf(A)*alpha;

    q->b0 = b0 / a0; q->b1 = b1 / a0; q->b2 = b2 / a0;
    q->a1 = a1 / a0; q->a2 = a2 / a0;
    biquad_reset(q);
}

static void biquad_init_high_shelf(biquad_t *q, float fc, float fs, float gain_db) {
    const float A = powf(10.0f, gain_db / 40.0f);
    const float w0 = 2.0f * (float)M_PI * fc / fs;
    const float cw = cosf(w0);
    const float sw = sinf(w0);
    const float alpha = sw * 0.5f * 1.41421356f;

    float b0 =    A*((A+1.0f) + (A-1.0f)*cw + 2.0f*sqrtf(A)*alpha);
    float b1 = -2.0f*A*((A-1.0f) + (A+1.0f)*cw);
    float b2 =    A*((A+1.0f) + (A-1.0f)*cw - 2.0f*sqrtf(A)*alpha);
    float a0 =        (A+1.0f) - (A-1.0f)*cw + 2.0f*sqrtf(A)*alpha;
    float a1 =    2.0f*((A-1.0f) - (A+1.0f)*cw);
    float a2 =        (A+1.0f) - (A-1.0f)*cw - 2.0f*sqrtf(A)*alpha;

    q->b0 = b0 / a0; q->b1 = b1 / a0; q->b2 = b2 / a0;
    q->a1 = a1 / a0; q->a2 = a2 / a0;
    biquad_reset(q);
}

typedef struct {
    float env;
    float a_att, a_rel;
    float thr_db, ratio, makeup_lin, knee_db;
} compressor_t;

static inline float compressor_gain_db(const compressor_t *c, float in_db) {
    const float thr = c->thr_db;
    const float r = c->ratio;

    if (c->knee_db <= 0.0f) {
        if (in_db <= thr) return 0.0f;
        float out_db = thr + (in_db - thr) / r;
        return out_db - in_db;
    }

    const float k = c->knee_db;
    const float x0 = thr - k * 0.5f;
    const float x1 = thr + k * 0.5f;

    if (in_db <= x0) return 0.0f;
    if (in_db >= x1) {
        float out_db = thr + (in_db - thr) / r;
        return out_db - in_db;
    }

    const float t = (in_db - x0) / (x1 - x0);
    float out1 = thr + (x1 - thr) / r;
    float g1 = out1 - x1;
    return g1 * t * t;
}

static inline float compressor_process(compressor_t *c, float x) {
    float ax = fabsf(x);
    if (ax > c->env) c->env = c->a_att * c->env + (1.0f - c->a_att) * ax;
    else            c->env = c->a_rel * c->env + (1.0f - c->a_rel) * ax;

    float env = fmaxf(c->env, 1e-8f);
    float in_db = 20.0f * log10f(env);

    float g_db = compressor_gain_db(c, in_db);
    float g_lin = powf(10.0f, g_db / 20.0f) * c->makeup_lin;

    return x * g_lin;
}

// ==========================================================
// Runtime-configurable DSP settings (over USB CDC)
// ==========================================================
typedef struct {
    uint8_t enable_bandpass;
    uint8_t enable_eq;
    uint8_t enable_comp;

    float bp_lo_hz;
    float bp_hi_hz;
    uint8_t bp_stages;      // 1-10, each stage = 12 dB/octave

    float eq_low_hz;
    float eq_low_db;
    float eq_high_hz;
    float eq_high_db;

    float comp_thr_db;
    float comp_ratio;
    float comp_attack_ms;
    float comp_release_ms;
    float comp_makeup_db;
    float comp_knee_db;
    float comp_out_limit;

    float amp_gain;
    float amp_min_a;
} audio_cfg_t;

#define AUDIO_CFG_DEFAULTS { \
    .enable_bandpass = AUDIO_ENABLE_BANDPASS, \
    .enable_eq       = AUDIO_ENABLE_EQ, \
    .enable_comp     = AUDIO_ENABLE_COMPRESSOR, \
    .bp_lo_hz  = AUDIO_BP_LO_HZ, \
    .bp_hi_hz  = AUDIO_BP_HI_HZ, \
    .bp_stages = AUDIO_BP_DEFAULT_STAGES, \
    .eq_low_hz  = EQ_LOW_SHELF_HZ, \
    .eq_low_db  = EQ_LOW_SHELF_DB, \
    .eq_high_hz = EQ_HIGH_SHELF_HZ, \
    .eq_high_db = EQ_HIGH_SHELF_DB, \
    .comp_thr_db     = COMP_THRESHOLD_DB, \
    .comp_ratio      = COMP_RATIO, \
    .comp_attack_ms  = COMP_ATTACK_MS, \
    .comp_release_ms = COMP_RELEASE_MS, \
    .comp_makeup_db  = COMP_MAKEUP_DB, \
    .comp_knee_db    = COMP_KNEE_DB, \
    .comp_out_limit  = COMP_OUTPUT_LIMIT, \
    .amp_gain  = AMP_GAIN, \
    .amp_min_a = AMP_MIN_A, \
}

static const audio_cfg_t k_cfg_defaults = AUDIO_CFG_DEFAULTS;
static volatile audio_cfg_t g_cfg = AUDIO_CFG_DEFAULTS;
static volatile uint8_t g_cfg_dirty = 1;

static void compressor_reconfig(compressor_t *c, float fs, const audio_cfg_t *cfg) {
    c->env = 0.0f;

    const float att_s = cfg->comp_attack_ms  * 0.001f;
    const float rel_s = cfg->comp_release_ms * 0.001f;
    c->a_att = expf(-1.0f / (fmaxf(att_s, 1e-4f) * fs));
    c->a_rel = expf(-1.0f / (fmaxf(rel_s, 1e-4f) * fs));

    c->thr_db = cfg->comp_thr_db;
    c->ratio  = fmaxf(cfg->comp_ratio, 1.0f);
    c->makeup_lin = powf(10.0f, cfg->comp_makeup_db / 20.0f);
    c->knee_db    = fmaxf(cfg->comp_knee_db, 0.0f);
}

static void cfg_sanitize(audio_cfg_t *c, float fs) {
    if (c->bp_lo_hz < 50.0f) c->bp_lo_hz = 50.0f;
    float max_hi = fs * 0.45f;
    if (c->bp_hi_hz > max_hi) c->bp_hi_hz = max_hi;
    if (c->bp_hi_hz <= c->bp_lo_hz + 50.0f) c->bp_hi_hz = c->bp_lo_hz + 50.0f;

    if (c->eq_low_hz < 50.0f) c->eq_low_hz = 50.0f;
    if (c->eq_low_hz > fs * 0.45f) c->eq_low_hz = fs * 0.45f;

    if (c->eq_high_hz < 50.0f) c->eq_high_hz = 50.0f;
    if (c->eq_high_hz > fs * 0.45f) c->eq_high_hz = fs * 0.45f;

    if (c->comp_ratio < 1.0f) c->comp_ratio = 1.0f;
    if (c->comp_attack_ms < 0.1f) c->comp_attack_ms = 0.1f;
    if (c->comp_release_ms < 1.0f) c->comp_release_ms = 1.0f;

    if (c->comp_out_limit < 0.05f) c->comp_out_limit = 0.05f;
    if (c->comp_out_limit > 0.999f) c->comp_out_limit = 0.999f;

    if (c->amp_gain < 0.01f) c->amp_gain = 0.01f;
    if (c->amp_min_a < 1e-9f) c->amp_min_a = 1e-9f;

    // Clamp bp_stages to valid range
    if (c->bp_stages < 1) c->bp_stages = 1;
    if (c->bp_stages > AUDIO_BP_MAX_STAGES) c->bp_stages = AUDIO_BP_MAX_STAGES;
}

static void apply_cfg_if_dirty(float Fs,
                              biquad_t *bp_hpf, biquad_t *bp_lpf,
                              biquad_t *eq_low, biquad_t *eq_high,
                              compressor_t *comp,
                              audio_cfg_t *out_cfg)
{
    if (!g_cfg_dirty) return;

    audio_cfg_t tmp;
    __compiler_memory_barrier();
    memcpy(&tmp, (const void*)&g_cfg, sizeof(tmp));
    __compiler_memory_barrier();

    cfg_sanitize(&tmp, Fs);

#if AUDIO_BP_MAX_STAGES
    for (int i = 0; i < AUDIO_BP_MAX_STAGES; i++) {
        biquad_init_highpass_bw2(&bp_hpf[i], tmp.bp_lo_hz, Fs);
        biquad_init_lowpass_bw2 (&bp_lpf[i], tmp.bp_hi_hz, Fs);
    }
#else
    (void)bp_hpf; (void)bp_lpf;
#endif

    biquad_init_low_shelf (eq_low,  tmp.eq_low_hz,  Fs, tmp.eq_low_db);
    biquad_init_high_shelf(eq_high, tmp.eq_high_hz, Fs, tmp.eq_high_db);

    compressor_reconfig(comp, Fs, &tmp);

    *out_cfg = tmp;

    __compiler_memory_barrier();
    g_cfg_dirty = 0;
    __compiler_memory_barrier();
}
// ==========================================================
// Simple USB CDC command interface (enabled only if CDC exists)
// ==========================================================
static int streqi(const char *a, const char *b) {
    if (!a || !b) return 0;
    while (*a && *b) {
        char ca = *a++, cb = *b++;
        if (ca >= 'A' && ca <= 'Z') ca = (char)(ca - 'A' + 'a');
        if (cb >= 'A' && cb <= 'Z') cb = (char)(cb - 'A' + 'a');
        if (ca != cb) return 0;
    }
    return (*a == 0 && *b == 0);
}

static void cdc_write_str(const char *s) {
#if CFG_TUD_CDC
    if (!tud_cdc_connected()) return;
    // tud_cdc_write() only accepts what currently fits in the 512-byte FIFO and
    // reports how much it took — the remainder has to be retried or it is lost.
    // Long output (get, help, diag) overflows that, which truncated lines and
    // spliced the next command's text onto them. Push the rest as the host
    // drains it, bounded so a stalled host cannot hold up the radio.
    const size_t len = strlen(s);
    size_t off = 0;
    absolute_time_t deadline = make_timeout_time_ms(50);
    while (off < len) {
        off += tud_cdc_write(s + off, (uint32_t)(len - off));
        tud_cdc_write_flush();
        if (off >= len) break;
        if (absolute_time_diff_us(get_absolute_time(), deadline) <= 0) break;
        tud_task();   // never called from inside tud_task(): cdc_task() runs after it
    }
#else
    (void)s;
#endif
}

static void cdc_printf(const char *fmt, ...) {
#if CFG_TUD_CDC
    if (!tud_cdc_connected()) return;
    char b[256];
    va_list ap;
    va_start(ap, fmt);
    int n = vsnprintf(b, sizeof(b), fmt, ap);
    va_end(ap);
    cdc_write_str(b);   // shares the retry loop, so long lines are not truncated
    // vsnprintf silently cuts at the buffer size; make that visible instead of
    // letting a caller lose the tail of a line without anyone noticing.
    if (n >= (int)sizeof(b)) cdc_write_str("[line truncated]\r\n");
#else
    (void)fmt;
#endif
}

static bool parse_bool(const char *s, uint8_t *out) {
    if (!s) return false;
    if (streqi(s, "1") || streqi(s, "on") || streqi(s, "true"))  { *out = 1; return true; }
    if (streqi(s, "0") || streqi(s, "off")|| streqi(s, "false")) { *out = 0; return true; }
    return false;
}

static bool parse_f(const char *s, float *out) {
    if (!s) return false;
    char *e = NULL;
    float v = strtof(s, &e);
    if (e == s) return false;
    *out = v;
    return true;
}

// Format large Hz value as "XXXXXXXXXX.X" into caller's buffer.
// Needed because newlib-nano's printf uses scientific notation for big doubles.
static void fmt_freq(char *buf, size_t len, double hz) {
    uint64_t i = (uint64_t)hz;
    uint32_t f = (uint32_t)((hz - (double)i) * 10.0 + 0.5);
    if (f >= 10) { i++; f = 0; }
    snprintf(buf, len, "%llu.%u", (unsigned long long)i, (unsigned)f);
}

static void cfg_print(void) {
    audio_cfg_t c;
    __compiler_memory_barrier();
    memcpy(&c, (const void*)&g_cfg, sizeof(c));
    __compiler_memory_barrier();

    double corrected = get_corrected_freq_hz();
    float fine = get_fine_tune_hz();

    char freq_str[24], corr_str[24];
    fmt_freq(freq_str, sizeof(freq_str), g_target_freq_hz);
    fmt_freq(corr_str, sizeof(corr_str), corrected);

    cdc_printf("CFG:\r\n");
    cdc_printf("  fw=" FW_VERSION "  git=" FW_GIT_ID "  built=" FW_BUILD "\r\n");
    cdc_printf("  freq=%s Hz (target)  ppm=%.3f  tx=%s  txpwr=%d dBm\r\n",
               freq_str, g_ppm_correction, g_tx_enabled ? "ON" : "OFF", g_tx_power_max_dbm);
    cdc_printf("  mode=%s  tune=%s  gps=%s  gpsgate=%s  config=%s\r\n",
               g_tx_mode ? "CW" : "USB", g_tune_active ? "ON" : "OFF",
               gpsdo_is_ready() ? "ready" : "wait", g_gps_gate ? "ON" : "OFF",
               g_persist_dirty ? "unsaved" : (g_persist_loaded ? "flash" : "defaults"));
    cdc_printf("  keyer=%s  wpm=%u  ratio=%.1f  sidetone=%u Hz  vol=%u%%\r\n",
               keyer_mode_name(g_cw_mode), (unsigned)g_cw_wpm, (double)g_cw_ratio,
               (unsigned)g_st_hz, (unsigned)g_st_vol);
    cdc_printf("  src=%s  mic_gain=%.1f  mic_gate=%.3f  ptt=%s\r\n",
               audio_src_name(g_audio_src), (double)g_mic_gain, (double)g_mic_gate,
               g_ptt_required ? "required for MIC" : "off (VOX)");
    cdc_printf("  corrected=%s Hz  base_steps=%lu  fine=%.1f Hz (auto)\r\n",
               corr_str, (unsigned long)get_base_steps(), fine);
    cdc_printf("  enable bp=%u eq=%u comp=%u\r\n",
               c.enable_bandpass, c.enable_eq, c.enable_comp);
    cdc_printf("  bp_lo=%.1f bp_hi=%.1f bp_stages=%u (%u dB/oct)\r\n",
               c.bp_lo_hz, c.bp_hi_hz, c.bp_stages, c.bp_stages * 12);
    cdc_printf("  eq_low_hz=%.1f eq_low_db=%.1f\r\n", c.eq_low_hz, c.eq_low_db);
    cdc_printf("  eq_high_hz=%.1f eq_high_db=%.1f\r\n", c.eq_high_hz, c.eq_high_db);
    cdc_printf("  comp_thr=%.1f ratio=%.2f att=%.2fms rel=%.2fms makeup=%.1f knee=%.1f outlim=%.3f\r\n",
               c.comp_thr_db, c.comp_ratio, c.comp_attack_ms, c.comp_release_ms,
               c.comp_makeup_db, c.comp_knee_db, c.comp_out_limit);
    cdc_printf("  amp_gain=%.3f amp_min_a=%.9f\r\n", c.amp_gain, c.amp_min_a);
}

static void cmd_help(void) {
    cdc_write_str(
        "Commands:\r\n"
        "  help\r\n"
        "  get\r\n"
        "  version       - firmware version and build date\r\n"
        "  diag          - show SX1280 status\r\n"
        "  gpsdo         - GPSDO status line\r\n"
        "  gpsgate 0|1   - 1: TX only with GPS UTC (default); 0: override for bench tests\r\n"
        "  save          - write freq/ppm/txpwr/mode/DSP to flash now (autosaves 5 s after idle)\r\n"
        "  defaults      - restore compile-time defaults and save\r\n"
        "  oled flip 0|1 - rotate the display by 180 degrees (default 1)\r\n"
        "  smps pwm 0|1  - Pico regulator: 1 = fixed PWM (less 3V3 ripple into the ADC)\r\n"
        "  oled off|on   - panel and charge pump off/on, refresh stopped (noise test)\r\n"
        "  oled freeze 0|1 - stop the I2C refresh, panel stays lit (noise test)\r\n"
        "  ptt 0|1       - 1: MIC mode transmits only while a CW paddle contact is held\r\n"
        "  src pc|mic    - audio source: USB from PC, or MAX4466 mic on GP26\r\n"
        "  mic [gain <1..50> | gate <0..0.5>] - mic gain and noise-gate threshold\r\n"
        "  keyer [wpm <5..60> | mode <straight|a|b> | ratio <2..5>] - on-device paddle keyer\r\n"
        "        [tone <300..1200> | vol <0..100> | test 0|1]      - sidetone on GP12 (PWM)\r\n"
        "                  decoder events: !K e=.|-  !K c=<char>  !K w\r\n"
        "  tx 0|1        - enable/disable TX (SSB modulation)\r\n"
        "  mode usb|cw   - set modulation mode\r\n"
        "  tune 0|1      - toggle TUNE carrier\r\n"
        "  cw            - start CW test transmission (carrier)\r\n"
        "  stop          - stop CW/tune transmission\r\n"
        "  key 0|1       - software PTT/KEY for GUI CW keyer\r\n"
        "  cwkey          - enter CW keyer mode (GUI use)\r\n"
        "  hang <ms>      - hang time (compatibility, no-op in v2)\r\n"
        "  freq <Hz>     - set frequency with sub-Hz precision (e.g. freq 2400100050.5)\r\n"
        "  ppm <value>   - set PPM correction (e.g. ppm -0.5)\r\n"
        "  txpwr <-18..13> - set max TX power in dBm\r\n"
        "  enable <bp|eq|comp> <0|1|on|off>\r\n"
        "  set bp_lo <Hz>\r\n"
        "  set bp_hi <Hz>\r\n"
        "  set bp_stages <1-10>  (filter steepness: 12dB/oct per stage)\r\n"
        "  set eq_low_hz <Hz>\r\n"
        "  set eq_low_db <dB>\r\n"
        "  set eq_high_hz <Hz>\r\n"
        "  set eq_high_db <dB>\r\n"
        "  set comp_thr <dB>\r\n"
        "  set comp_ratio <R>\r\n"
        "  set comp_att <ms>\r\n"
        "  set comp_rel <ms>\r\n"
        "  set comp_makeup <dB>\r\n"
        "  set comp_knee <dB>\r\n"
        "  set comp_outlim <0..1>\r\n"
        "  set amp_gain <float>\r\n"
        "  set amp_min_a <float>\r\n"
        "\r\n"
        "Receive (Si4732, QO-100 downlink via LNB + mixer):\r\n"
        "  i2c                  - scan both buses; shows what actually answers\r\n"
        "  rclk [0|1]           - reference on SI5351 CLK2 -> Si4732 pin 13. OFF at boot,\r\n"
        "                         'rx on' enables it. The receiver needs it to tune.\r\n"
        "  rclk drive <2|4|6|8> - drive strength in mA. 8 mA at boot; 2 mA left the\r\n"
        "                         Si4732 talking on I2C but refusing to tune.\r\n"
        "  rclk freq <25|36|32k|32m> - reference. Demonstrated SSB uses 32k:\r\n"
        "                         32k feeds it directly (disables the mixer LO).\r\n"
        "                         32m = 32.768 MHz / 1000 is experimental for SSB.\r\n"
        "  lo [0|1]             - 144 MHz on SI5351 CLK0, OFF at boot; mixer LO is its 5th\r\n"
        "                         harmonic at 720 MHz. 32k disables this output.\r\n"
        "  rx                   - receiver status\r\n"
        "  rx diag              - detailed receiver report\r\n"
        "  rx scan [from] [to] [step]  - sweep in kHz and print a level table,\r\n"
        "                         8 averaged reads each. Default 19400 20100 50.\r\n"
        "  rx raw <n> <hex...>  - send a raw command, read n response bytes, dump them\r\n"
        "  rx ssbtest [rev|rsq|tune] - run the real bring-up with a status read after\r\n"
        "                         every step, then ask ONE command and stop\r\n"
        "  rx xoscpatch <0|1>   - XOSCEN for the patch POWER_UP only (reference uses 1)\r\n"
        "  rx refearly <0|1>    - send the REFCLK properties before the patch upload\r\n"
        "  rx fast <0|1>        - FAST bit of the SSB tune\r\n"
        "  rx mon [0|1]         - receive audio into the headphones (Si4732 LOUT -> GP27).\r\n"
        "                         Takes the ADC from the microphone, so transmit audio\r\n"
        "                         switches to PC while it is on.\r\n"
        "  rx mon vol <0..100>  - monitor level in the headphones\r\n"
        "  rx mon agc [0|1]     - audio AGC: down fast, up slowly, with a hard limiter\r\n"
        "  rx mon cw 0|<Hz> [<centre>] - CW audio filter, e.g. 'rx mon cw 150 600'\r\n"
        "  rx mon level <5..90> - AGC target in % of full scale (default 25)\r\n"
        "  rx mon maxgain <0..36> - AGC gain ceiling in dB (default 36)\r\n"
        "  rx mon hang <0..3000>  - AGC hold after a signal, ms (default 400)\r\n"
        "  rx mon poll 0|1      - 5 Hz RSSI polling for the display (crackle test)\r\n"
        "  rx agc [on|off|<n>]  - front-end attenuator. The index is attenuation, so 0\r\n"
        "                         is full gain. 'off' pins it open for measuring.\r\n"
        "  rx xosc <0|1>        - POWER_UP crystal-oscillator bit; 0 = external RCLK\r\n"
        "  rx antcap <0..6143>  - antenna tuning capacitor; 0 = automatic. Try 1 for a\r\n"
        "                         short wire or a 50 ohm feed.\r\n"
        "  rx on | off          - power the receiver up / down\r\n"
        "  rx usb | lsb | am    - demodulation mode (sideband needs the SSB patch)\r\n"
        "  rx freq <kHz>        - 2300..26100, the IF from the mixer.\r\n"
        "                         Decimals allowed: 19500.5 is 19 500 500 Hz.\r\n"
        "  rx cal <Hz>          - IF offset, saved; build default -4300 Hz.\r\n"
        "                         Negative when IF arrives low. Apply only here,\r\n"
        "                         not again in rx freq. Direct generator: cal 0.\r\n"
        "                         Status adds configured IF/nominal Hz and PLL;\r\n"
        "                         these are command values, not RF measurements.\r\n"
        "  rx vol <0..63>\r\n"
        "  rx bw <Hz>           - nearest available filter is used\r\n"
        "  rx bfo <Hz>          - raw BFO changes IF; next tune overwrites it\r\n"
        "  rx mute 0|1\r\n"
        "\r\n"
        "Frequency is automatically split into PLL steps + fine DSP offset.\r\n"
    );
}

static void cfg_commit(const audio_cfg_t *c) {
    __compiler_memory_barrier();
    memcpy((void*)&g_cfg, c, sizeof(*c));
    g_cfg_dirty = 1;
    __compiler_memory_barrier();
    persist_mark_dirty();
}

// ==========================================================
// Persistent configuration in the last 4 KB flash sector
// ==========================================================
// Layout: one flash page. Anything not listed here (TX enable, TUNE,
// GPS gate, soft key) is deliberately volatile and resets at boot.
#define CFG_FLASH_OFFSET   (PICO_FLASH_SIZE_BYTES - FLASH_SECTOR_SIZE)
#define CFG_MAGIC          0x51303130u   // 'Q010'
#define CFG_VERSION        5u            // bump whenever persist_cfg_t layout changes

typedef struct __attribute__((packed)) {
    uint32_t    magic;
    uint32_t    version;
    double      freq_hz;
    float       ppm_correction;
    int8_t      tx_power_dbm;
    uint8_t     tx_mode;         // 0 = USB, 1 = CW
    uint8_t     cw_mode;         // KEYER_*
    uint8_t     cw_wpm;
    float       cw_ratio;
    uint16_t    st_hz;           // sidetone
    uint8_t     st_vol;
    uint8_t     audio_src;       // AUDIO_SRC_*
    float       mic_gain;
    float       mic_gate;
    uint8_t     oled_flip;
    uint8_t     ptt_req_p1;      // 0 = unset (older save), else g_ptt_required + 1
    // Receive side. rx_cal_hz is the one that really has to survive a power
    // cycle: it stands in for GPS discipline, which the Bullseye LNB cannot
    // take, and re-measuring it on the beacon at every boot would be tedious.
    int32_t     rx_cal_hz;       // LNB LO error in Hz (signal arrives this high)
    uint32_t    rx_hz;           // last receive frequency
    uint8_t     rx_mode;         // SI4732_MODE_*
    uint8_t     rx_vol;          // 0..63
    uint16_t    rx_bw_hz;
    uint8_t     _reserved[6];    // future fields fit here without a version bump
    audio_cfg_t dsp;
    uint32_t    crc32;           // over everything above
} persist_cfg_t;

_Static_assert(sizeof(persist_cfg_t) <= FLASH_PAGE_SIZE,
               "persist_cfg_t must fit in one flash page");

static uint32_t crc32_update(uint32_t crc, const uint8_t *data, size_t len) {
    crc ^= 0xFFFFFFFFu;
    for (size_t i = 0; i < len; i++) {
        crc ^= data[i];
        for (int k = 0; k < 8; k++) {
            uint32_t mask = -(int32_t)(crc & 1u);
            crc = (crc >> 1) ^ (0xEDB88320u & mask);
        }
    }
    return crc ^ 0xFFFFFFFFu;
}

static inline uint32_t persist_cfg_crc(const persist_cfg_t *c) {
    return crc32_update(0, (const uint8_t *)c, offsetof(persist_cfg_t, crc32));
}

static void persist_collect(persist_cfg_t *c) {
    memset(c, 0, sizeof(*c));
    c->magic          = CFG_MAGIC;
    c->version        = CFG_VERSION;
    c->freq_hz        = g_target_freq_hz;
    c->ppm_correction = g_ppm_correction;
    c->tx_power_dbm   = g_tx_power_max_dbm;
    c->tx_mode        = g_tx_mode;
    c->cw_mode        = g_cw_mode;
    c->cw_wpm         = g_cw_wpm;
    c->cw_ratio       = g_cw_ratio;
    c->st_hz          = g_st_hz;
    c->st_vol         = g_st_vol;
    c->audio_src      = g_audio_src;
    c->mic_gain       = g_mic_gain;
    c->mic_gate       = g_mic_gate;
    c->oled_flip      = g_oled_flip;
    c->ptt_req_p1     = (uint8_t)(g_ptt_required + 1u);
    c->rx_cal_hz      = si4732_get_cal_hz();
    c->rx_hz          = si4732_get_hz();
    c->rx_mode        = (uint8_t)si4732_get_mode();
    c->rx_vol         = si4732_get_volume();
    c->rx_bw_hz       = si4732_get_bandwidth_hz();
    __compiler_memory_barrier();
    memcpy(&c->dsp, (const void *)&g_cfg, sizeof(c->dsp));
    __compiler_memory_barrier();
    c->crc32          = persist_cfg_crc(c);
}

static void persist_apply(const persist_cfg_t *c) {
    double f = c->freq_hz;
    if (!(f >= 2400000000.0 && f <= 2500000000.0)) f = (double)BASE_FREQ_HZ;  // also rejects NaN
    g_target_freq_hz = f;

    float ppm = c->ppm_correction;
    if (!(ppm >= -100.0f && ppm <= 100.0f)) ppm = 0.0f;
    g_ppm_correction = ppm;

    int8_t p = c->tx_power_dbm;
    if (p < PWR_MIN_DBM) p = PWR_MIN_DBM;
    if (p > PWR_MAX_DBM) p = PWR_MAX_DBM;
    g_tx_power_max_dbm = p;

    g_tx_mode = (c->tx_mode == 1) ? 1 : 0;

    g_cw_mode = (c->cw_mode <= KEYER_IAMBIC_B) ? c->cw_mode : KEYER_IAMBIC_B;
    g_cw_wpm  = (c->cw_wpm >= 5 && c->cw_wpm <= 60) ? c->cw_wpm : 18;
    float r = c->cw_ratio;
    g_cw_ratio = (r >= 2.0f && r <= 5.0f) ? r : 3.0f;   // also rejects NaN

    g_st_hz  = (c->st_hz >= 300 && c->st_hz <= 1200) ? c->st_hz : 700;
    g_st_vol = (c->st_vol <= 100) ? c->st_vol : 30;
    sidetone_update_params();

    g_audio_src = (c->audio_src == AUDIO_SRC_MIC) ? AUDIO_SRC_MIC : AUDIO_SRC_PC;
    float mg = c->mic_gain, mt = c->mic_gate;
    g_mic_gain = (mg >= 1.0f && mg <= 50.0f) ? mg : 10.0f;
    g_mic_gate = (mt >= 0.0f && mt <= 0.5f)  ? mt : 0.02f;
    g_oled_flip = c->oled_flip ? 1 : 0;
    // 0 means the field did not exist yet when this was saved — default to on,
    // which is the safe direction (fails to not transmitting).
    g_ptt_required = (c->ptt_req_p1 == 0u) ? 1 : ((c->ptt_req_p1 == 1u) ? 0 : 1);

    // Only remembered here — the receiver has not been probed yet at this
    // point, and the first "rx on" applies the lot.
    si4732_restore((si4732_mode_t)c->rx_mode, c->rx_hz, c->rx_vol,
                   c->rx_bw_hz, c->rx_cal_hz);

    audio_cfg_t d = c->dsp;
    cfg_sanitize(&d, (float)WAV_SAMPLE_RATE);
    cfg_commit(&d);
}

static bool persist_load(void) {
    const persist_cfg_t *p = (const persist_cfg_t *)(XIP_BASE + CFG_FLASH_OFFSET);
    if (p->magic != CFG_MAGIC)          return false;
    if (p->version != CFG_VERSION)      return false;
    if (persist_cfg_crc(p) != p->crc32) return false;
    persist_apply(p);
    g_persist_dirty  = 0;   // cfg_commit() marked dirty; a fresh load is clean by definition
    g_persist_loaded = 1;
    return true;
}

// Runs with IRQs off on Core0 and Core1 parked by flash_safe_execute().
// Must stay in RAM: XIP is unavailable while flash is being erased.
static void __not_in_flash_func(persist_flash_op)(void *param) {
    flash_range_erase(CFG_FLASH_OFFSET, FLASH_SECTOR_SIZE);
    flash_range_program(CFG_FLASH_OFFSET, (const uint8_t *)param, FLASH_PAGE_SIZE);
}

// ~20 ms erase + ~1 ms program. Core1's SPI loop is stalled meanwhile, so the
// SX1280 holds its last state for that long — hence autosave only when idle.
static bool persist_save_now(void) {
    persist_cfg_t c;
    persist_collect(&c);

    static uint8_t page[FLASH_PAGE_SIZE];
    memset(page, 0xFF, sizeof(page));
    memcpy(page, &c, sizeof(c));

    int r = flash_safe_execute(persist_flash_op, page, 100);
    g_persist_last_rc = r;
    if (r == PICO_OK) {
        g_persist_dirty = 0;
        g_persist_loaded = 1;   // a valid record now exists, even if boot found none
        g_persist_saves++;
        return true;
    }
    // Don't retry back-to-back: each failed attempt costs up to 100 ms.
    g_persist_dirty_since = to_ms_since_boot(get_absolute_time());
    return false;
}

// What is actually sitting in the config sector, so a failing save or a
// mismatching layout can be told apart from "never written".
static void persist_diag_print(void) {
    const persist_cfg_t *p = (const persist_cfg_t *)(XIP_BASE + CFG_FLASH_OFFSET);
    const uint32_t crc = persist_cfg_crc(p);
    cdc_printf("Config: offset=0x%08lx size=%u flash_size=%lu\r\n",
               (unsigned long)CFG_FLASH_OFFSET, (unsigned)sizeof(persist_cfg_t),
               (unsigned long)PICO_FLASH_SIZE_BYTES);
    cdc_printf("Config: magic=0x%08lx/0x%08lx ver=%lu/%lu crc=0x%08lx/0x%08lx %s\r\n",
               (unsigned long)p->magic, (unsigned long)CFG_MAGIC,
               (unsigned long)p->version, (unsigned long)CFG_VERSION,
               (unsigned long)p->crc32, (unsigned long)crc,
               (p->magic == CFG_MAGIC && p->version == CFG_VERSION && crc == p->crc32)
                   ? "VALID" : "INVALID");
    cdc_printf("Config: loaded=%u dirty=%u saves=%lu last_rc=%d (0=ok)\r\n",
               (unsigned)g_persist_loaded, (unsigned)g_persist_dirty,
               (unsigned long)g_persist_saves, g_persist_last_rc);
}

// Periodic status push to CDC for GUI synchronization.
// Sends a compact line that the GUI can parse to update its widgets.
// Only sends when something changed, at most every 250 ms.
#if CFG_TUD_CDC
static void cdc_status_push_ex(bool force) {
    static uint32_t last_push_ms = 0;
    static uint8_t  last_mode = 0xFF;
    static uint8_t  last_tune = 0xFF;
    static uint8_t  last_tx   = 0xFF;
    static int8_t   last_pwr  = 127;
    static float    last_ppm  = 9999.0f;
    static double   last_freq = 0.0;
    static uint8_t  last_gps  = 0xFF;
    static uint8_t  last_gate = 0xFF;
    static uint8_t  last_dirty = 0xFF;
    static uint8_t  last_kwpm  = 0;
    static uint8_t  last_kmode = 0xFF;
    static uint8_t  last_key   = 0xFF;
    static uint8_t  last_pdl   = 0xFF;
    static uint16_t last_sthz  = 0;
    static uint8_t  last_stvol = 0xFF;
    static uint8_t  last_src   = 0xFF;
    static uint8_t  last_ptt   = 0xFF;

    if (!tud_cdc_connected()) return;

    uint8_t  cur_mode = g_tx_mode;
    uint8_t  cur_tune = g_tune_active;
    uint8_t  cur_tx   = g_tx_enabled;
    int8_t   cur_pwr  = g_tx_power_max_dbm;
    float    cur_ppm  = g_ppm_correction;
    double   cur_freq = (double)g_target_freq_hz;
    uint8_t  cur_gps  = gpsdo_is_ready() ? 1 : 0;
    uint8_t  cur_gate = g_gps_gate;
    uint8_t  cur_dirty = g_persist_dirty;
    uint8_t  cur_kwpm  = g_cw_wpm;
    uint8_t  cur_kmode = g_cw_mode;
    uint8_t  cur_key   = (g_keyer_key | g_soft_ptt_key) ? 1 : 0;
    uint8_t  cur_pdl   = (uint8_t)(g_key_dit | (g_key_dah << 1));
    uint16_t cur_sthz  = g_st_hz;
    uint8_t  cur_stvol = g_st_vol;
    uint8_t  cur_src   = g_audio_src;
    // bit0 = PTT pressed, bit1 = PTT required, bit2 = currently blocking TX
    uint8_t  cur_ptt   = (uint8_t)(g_ptt_key | (g_ptt_required << 1) | (ssb_ptt_blocks() ? 4 : 0));

    if (!force) {
        // Check if anything changed
        bool changed = (cur_mode != last_mode) || (cur_tune != last_tune) ||
                       (cur_tx != last_tx) || (cur_pwr != last_pwr) ||
                       (cur_ppm != last_ppm) || (cur_freq != last_freq) ||
                       (cur_gps != last_gps) || (cur_gate != last_gate) ||
                       (cur_dirty != last_dirty) ||
                       (cur_kwpm != last_kwpm) || (cur_kmode != last_kmode) ||
                       (cur_key != last_key) || (cur_pdl != last_pdl) ||
                       (cur_sthz != last_sthz) || (cur_stvol != last_stvol) ||
                       (cur_src != last_src) || (cur_ptt != last_ptt);

        if (!changed) return;

        uint32_t now = to_ms_since_boot(get_absolute_time());
        if ((now - last_push_ms) < 100) return;
    }

    // Format freq with fmt_freq to avoid newlib-nano scientific notation
    char freq_str[24];
    fmt_freq(freq_str, sizeof(freq_str), cur_freq);

    // PPM: format as fixed-point (4 decimals) to avoid float formatting issues
    int ppm_neg = (cur_ppm < 0.0f);
    float ppm_abs = ppm_neg ? -cur_ppm : cur_ppm;
    uint32_t ppm_int = (uint32_t)ppm_abs;
    uint32_t ppm_frac = (uint32_t)((ppm_abs - (float)ppm_int) * 10000.0f + 0.5f);
    if (ppm_frac >= 10000) { ppm_int++; ppm_frac = 0; }

    char status_buf[192];
    snprintf(status_buf, sizeof(status_buf),
             "!S mode=%u tune=%u tx=%u pwr=%d ppm=%s%lu.%04lu freq=%s gps=%u gate=%u dirty=%u kwpm=%u kmode=%u key=%u pdl=%u sthz=%u stvol=%u src=%u ptt=%u\r\n",
             cur_mode, cur_tune, cur_tx, cur_pwr,
             ppm_neg ? "-" : "", (unsigned long)ppm_int, (unsigned long)ppm_frac,
             freq_str, cur_gps, cur_gate, cur_dirty, cur_kwpm, cur_kmode, cur_key, cur_pdl,
             (unsigned)cur_sthz, (unsigned)cur_stvol, (unsigned)cur_src, (unsigned)cur_ptt);
    cdc_write_str(status_buf);

    last_mode = cur_mode;
    last_tune = cur_tune;
    last_tx   = cur_tx;
    last_pwr  = cur_pwr;
    last_ppm  = cur_ppm;
    last_freq = cur_freq;
    last_gps  = cur_gps;
    last_gate = cur_gate;
    last_dirty = cur_dirty;
    last_kwpm  = cur_kwpm;
    last_kmode = cur_kmode;
    last_key   = cur_key;
    last_pdl   = cur_pdl;
    last_sthz  = cur_sthz;
    last_stvol = cur_stvol;
    last_src   = cur_src;
    last_ptt   = cur_ptt;
    last_push_ms = to_ms_since_boot(get_absolute_time());
}

static inline void cdc_status_push(void) { cdc_status_push_ex(false); }
#endif

// Both stdio backends are off in this build, so the Si4732 driver cannot use
// printf. It hands its messages here instead and they go out on the console
// like everything else.
//
// Early messages would otherwise be lost: si4732_init() runs during boot, long
// before anyone opens the terminal, and cdc_printf discards whatever it cannot
// deliver. That is how a whole receiver init report — which address answered,
// what GET_REV returned — vanished and had to be guessed at. So until the
// console is there, lines go into a buffer and are replayed on connect.
#define BOOTLOG_LINES 16
#define BOOTLOG_LEN   120
static char    g_bootlog[BOOTLOG_LINES][BOOTLOG_LEN];
static uint8_t g_bootlog_n    = 0;
static uint8_t g_bootlog_lost = 0;
static bool    g_bootlog_done = false;

static void si4732_log_sink(const char *line) {
    if (!g_bootlog_done && !tud_cdc_connected()) {
        if (g_bootlog_n < BOOTLOG_LINES) {
            snprintf(g_bootlog[g_bootlog_n], BOOTLOG_LEN, "%s", line);
            g_bootlog_n++;
        } else if (g_bootlog_lost < 255u) {
            g_bootlog_lost++;
        }
        return;
    }
    cdc_printf("%s\r\n", line);
}

// Replays what was logged before the console existed. Called once, from the
// greeting.
static void bootlog_flush(void) {
    g_bootlog_done = true;
    if (g_bootlog_n == 0u) return;
    cdc_write_str("--- logged during boot ---\r\n");
    for (uint8_t i = 0; i < g_bootlog_n; i++) cdc_printf("%s\r\n", g_bootlog[i]);
    if (g_bootlog_lost)
        cdc_printf("--- %u further line(s) dropped ---\r\n", (unsigned)g_bootlog_lost);
    cdc_write_str("--- end of boot log ---\r\n");
}

// One machine-readable line, in the same shape as the other "!" pushes so the
// GUI can pick it apart: !R on= mode= freq= bw= bfo= vol= mute= rssi= snr=
// The Si4732 has no crystal of its own. With SI5351 CLK2 switched off it still
// answers on I2C, still accepts every command and still acknowledges a tune —
// it just never completes one, and then every level reads 0. From the outside
// that is indistinguishable from a dead antenna, and it has already cost one
// bench session and the wrong conclusion that the chip was deaf.
//
// CLK2 cannot simply be on from boot: gpsdo_init() runs before the gate that
// waits for a locked 52 MHz, and nothing on the receive side may be able to
// stop the transmitter from starting. So it is switched on here instead, at
// every point where the receiver is about to be used.
static bool rx_ensure_rclk(void)
{
    if (gpsdo_rclk_enabled()) return true;
    if (gpsdo_set_rclk_enabled(true)) {
        cdc_printf("NOTE: reference clock was off — CLK2 (%lu Hz) enabled\r\n",
                   (unsigned long)si4732_rclk_hz());
        return true;
    }
    cdc_write_str("WARN: no reference clock on Si4732 pin 13 (SI5351 unreachable).\r\n"
                  "      The receiver cannot tune at all without it: every level\r\n"
                  "      will read 0, which looks exactly like a dead antenna.\r\n");
    return false;
}

static void rx_status_print(void) {
    uint8_t rssi = 0, snr = 0;
    bool have_rsq = si4732_read_rsq(&rssi, &snr);
    cdc_printf("!R on=%d mode=%s hz=%lu cal=%ld bw=%u bfo=%d vol=%u mute=%d rssi=%d snr=%d tuner_khz=%lu if_hz=%ld actual_hz=%ld bfo_override=%d\r\n",
               si4732_is_on() ? 1 : 0,
               si4732_mode_name(si4732_get_mode()),
               (unsigned long)si4732_get_hz(),
               (long)si4732_get_cal_hz(),
               si4732_get_bandwidth_hz(),
               (int)si4732_get_bfo_hz(),
               si4732_get_volume(),
               si4732_get_mute() ? 1 : 0,
               have_rsq ? (int)rssi : -1,
               have_rsq ? (int)snr  : -1,
               (unsigned long)si4732_get_khz(),
               (long)si4732_get_configured_if_hz(),
               (long)si4732_get_actual_hz(),
               si4732_bfo_overridden() ? 1 : 0);
    if (si4732_bfo_overridden())
        cdc_write_str("NOTE: raw BFO changes configured IF; rx freq restores automatic fine tuning.\r\n");
    // Every setting command ends here, and each one answered "OK" while the
    // chip was powered down, so values were being stored into a receiver that
    // was not running and nothing was heard. on=0 was in the line all along and
    // easy to read past; say it in words.
    if (si4732_present() && !si4732_is_on())
        cdc_write_str("NOTE: receiver is OFF — value stored only. "
                      "Start it with 'rx am' or 'rx usb'.\r\n");
}

// Twelve, not six. Six was enough while every command was a verb and a value,
// and "rx raw" broke that: "rx raw 4 13 00 02 01" is seven words, so the last
// byte was dropped and the command went out short. Two clock-register reads
// then returned the same answer because the same truncated command had been
// sent twice, which read as a result and was not one.
//
// Three words for "rx raw <length>" plus eight command bytes, and one spare.
#define CDC_MAX_ARGS 12
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
int main(void) {
    bool ok = set_sys_clock_khz(250000, false);
    if (!ok) set_sys_clock_khz(200000, true);

    // Pico SMPS into fixed PWM (GPIO23 = PS pin). In the board's default
    // power-save mode it switches in bursts at light load, and the resulting
    // pulsing ripple on 3V3 reached the headphones through the RX audio ADC,
    // whose bias divider hangs off 3V3. Confirmed on the bench: "smps pwm 1"
    // made the pulse clearly quieter. Costs a few mA.
    gpio_init(23);
    gpio_set_dir(23, GPIO_OUT);
    gpio_put(23, 1);

    // Restore saved config before anything displays or uses it.
    persist_load();

    // ---- USB device init ----
    board_init();
    tusb_rhport_init_t dev_init = {
        .role  = TUSB_ROLE_DEVICE,
        .speed = TUSB_SPEED_FULL  // UAC1-only: Full-Speed dla Windows/Linux
    };
    tusb_init(BOARD_TUD_RHPORT, &dev_init);
    board_init_after_tusb();

    // ---- SX1280 GPIO/SPI init ----
    // CRITICAL FOR TCXO MODULE: Enable TCXO FIRST, before any SPI/reset!
#if USE_TCXO_MODULE
    gpio_init(PIN_TCXO_EN);
    gpio_set_dir(PIN_TCXO_EN, GPIO_OUT);
    gpio_put(PIN_TCXO_EN, 1);  // Enable TCXO FIRST!
    sleep_ms(5);               // Wait for TCXO to stabilize (min 3ms)
    printf("[SX1280] TCXO enabled (GPIO%d=HIGH)\n", PIN_TCXO_EN);
#endif

    gpio_init(PIN_NSS);   gpio_set_dir(PIN_NSS, GPIO_OUT);   gpio_put(PIN_NSS, 1);
    gpio_init(PIN_RX_EN); gpio_set_dir(PIN_RX_EN, GPIO_OUT); gpio_put(PIN_RX_EN, 0);
    gpio_init(PIN_TX_EN); gpio_set_dir(PIN_TX_EN, GPIO_OUT); gpio_put(PIN_TX_EN, 0);  // Start with TX disabled!
    // SX1280 held in reset until GPSDO is ready (released after gpsdo_is_ready()).
    gpio_init(PIN_RESET); gpio_set_dir(PIN_RESET, GPIO_OUT); gpio_put(PIN_RESET, 0);
    gpio_init(PIN_BUSY);  gpio_set_dir(PIN_BUSY, GPIO_IN);

    // --- Encoder + button GPIO init (input with pull-up, active LOW) ---
    gpio_init(PIN_ENC_A);   gpio_set_dir(PIN_ENC_A, GPIO_IN);   gpio_pull_up(PIN_ENC_A);
    gpio_init(PIN_ENC_B);   gpio_set_dir(PIN_ENC_B, GPIO_IN);   gpio_pull_up(PIN_ENC_B);
    gpio_init(PIN_ENC_OK);  gpio_set_dir(PIN_ENC_OK, GPIO_IN);  gpio_pull_up(PIN_ENC_OK);
    gpio_init(PIN_KEY_DIT); gpio_set_dir(PIN_KEY_DIT, GPIO_IN); gpio_pull_up(PIN_KEY_DIT);
    gpio_init(PIN_KEY_DAH); gpio_set_dir(PIN_KEY_DAH, GPIO_IN); gpio_pull_up(PIN_KEY_DAH);
    // Initialize encoder last state
    enc_last_ab = ((gpio_get(PIN_ENC_A) ? 0 : 1) << 1) | (gpio_get(PIN_ENC_B) ? 0 : 1);

    // --- Sidetone PWM (GP12) — starts silent at mid-scale ---
    sidetone_init();
    // --- Microphone ADC (GP26) — runs continuously, used only when src=mic ---
    mic_init();

    spi_init(SX_SPI, SX_SPI_BAUD);
    gpio_set_function(PIN_MISO, GPIO_FUNC_SPI);
    gpio_set_function(PIN_MOSI, GPIO_FUNC_SPI);
    gpio_set_function(PIN_SCK,  GPIO_FUNC_SPI);

    // --- OLED I2C init (early — before GPSDO wait so display is always on) ---
    sleep_ms(20);  // Allow display VCC to stabilise before sending I2C init sequence
    i2c_init(OLED_I2C, OLED_I2C_BAUD);
    gpio_set_function(PIN_OLED_SDA, GPIO_FUNC_I2C);
    gpio_set_function(PIN_OLED_SCL, GPIO_FUNC_I2C);
    gpio_pull_up(PIN_OLED_SDA);
    gpio_pull_up(PIN_OLED_SCL);
    ssd1306_init(OLED_I2C);
    if (g_oled_flip) ssd1306_set_flip(OLED_I2C, true);   // persist_load() ran before this
    oled_draw_boot_wait(0u);

    // ---- GPSDO: SI5351 52 MHz (I2C0, GP0/GP1) + NEO-7M GPS (UART1, GP4/GP5) ----
    // Stage 1 (blocking): wait for a locked 52 MHz clock from the SI5351. The
    // SX1280 has no other clock source, so NRESET stays LOW until then.
    // Stage 2 (non-blocking): GPS discipline (UTC) only gates TX via
    // tx_allowed() — the UI, CDC and OLED run normally while GPS acquires.
    gpsdo_init();
    {
        const uint32_t boot_ms = to_ms_since_boot(get_absolute_time());
        uint32_t last_status_ms  = 0u;
        uint32_t last_oled_ms    = 0u;
        uint8_t  si_warn_printed = 0u;
        uint32_t last_retry_ms   = 0u;
        uint8_t  retries         = 0u;
        while (!gpsdo_clock_ok()) {
            gpsdo_task();
            rxmon_task();
            tud_task();
            cdc_task();   // allow 'gpsdo' / 'version' while waiting
            uint32_t now_ms = to_ms_since_boot(get_absolute_time());
            // 1 s cadence: ssd1306_display() blocks ~100 ms on I2C at 100 kHz,
            // and only the seconds counter changes anyway.
            if ((now_ms - last_oled_ms) >= 1000u) {
                last_oled_ms = now_ms;
                oled_draw_boot_wait(now_ms - boot_ms);
            }
            // Rather than wait forever: if the SI5351 is there but PLL A has
            // not locked, re-send the whole configuration every 5 s. A write
            // lost on the bus, or a PLL that came up unlocked, then costs five
            // seconds instead of the whole session.
            if (gpsdo_si5351_ok() && retries < 12u
                && (now_ms - boot_ms) >= 5000u
                && (now_ms - last_retry_ms) >= 5000u) {
                last_retry_ms = now_ms;
                retries++;
                if (tud_cdc_connected())
                    cdc_printf("GPSDO: PLL A still unlocked — resending the SI5351 "
                               "configuration (attempt %u)\r\n", (unsigned)retries);
                gpsdo_retry_clock();
            }
            if (tud_cdc_connected()) {
                if (!si_warn_printed && !gpsdo_si5351_ok()) {
                    si_warn_printed = 1u;
                    cdc_write_str("GPSDO: WARNING — SI5351 not found (GP0/GP1).\r\n"
                                  "GPSDO: SX1280 has no clock and will NOT start until SI5351 is connected.\r\n");
                }
                if ((now_ms - last_status_ms) >= 2000u) {
                    last_status_ms = now_ms;
                    char gbuf[128];
                    gpsdo_format_status(gbuf, sizeof(gbuf));
                    cdc_write_str(gbuf);
                }
            }
        }
        if (tud_cdc_connected()) {
            cdc_write_str("GPSDO: 52 MHz clock locked — starting SX1280. "
                          "TX stays blocked until GPS UTC is valid (see 'gpsgate').\r\n");
        }
    }

    // ---- Si4732 receiver (shares I2C0 with the SI5351, RST on GP13) ----
    // After gpsdo_init(), which owns the bus setup, and deliberately not
    // powered up here: the patch upload takes a couple of seconds at 100 kHz,
    // so the operator starts the receiver with "rx on" when they want it.
    si4732_set_log(si4732_log_sink);
    si4732_init();

    // Release SX1280 from reset (was held LOW during GPSDO init) and initialise
    printf("[SX1280] Resetting...\n");
    gpio_put(PIN_RESET, 0); sleep_ms(2);
    gpio_put(PIN_RESET, 1); sleep_ms(10);
    printf("[SX1280] Reset complete, BUSY=%d\n", gpio_get(PIN_BUSY));

#if USE_TCXO_MODULE
    // For TCXO module, use STDBY_XOSC mode
    sx_set_standby_xosc();
    printf("[SX1280] Set STDBY_XOSC mode (for TCXO)\n");
#else
    sx_set_standby_rc();
    printf("[SX1280] Set STDBY_RC mode\n");
#endif

    sx_set_packet_type_gfsk();

    // Use runtime-configurable frequency with PPM correction
    uint32_t init_base_steps = get_base_steps();
    sx_set_rf_frequency_steps(init_base_steps);

    sx_set_tx_params_dbm((int32_t)PWR_MIN_DBM);  // Start with minimum power
    // TX_EN stays LOW - will be controlled by Core1 or CDC commands
    // Use 'cw' command via CDC to test transmission
    // DON'T start TX yet - wait for USB to enumerate and audio to start
    // sx_start_tx_continuous_wave();  -- moved to core1 when audio starts

#if FIXED_POWER_CW_MODE
    // For CW mode, wait for USB then start TX
    while (!tud_ready()) { tud_task(); sleep_ms(10); }
    sleep_ms(500);  // Extra delay for USB stability
    gpio_put(PIN_TX_EN, 1);
    sx_start_tx_continuous_wave();
    while (true) { tud_task(); tight_loop_contents(); }
#endif

    // *** Start Core1 early so it can idle and drain blocks immediately ***
    multicore_launch_core1(core1_radio_apply_loop);

    // Wait for USB — meanwhile handle encoder, buttons, OLED, CW keying
    {
        printf("[BOOT] Waiting for USB connection (encoder+CW active)...\n");
        absolute_time_t oled_next = {0};
        // Powerbank / standalone: no host within 3 s → carry on without one.
        // TinyUSB keeps running, so a PC plugged in later still enumerates.
        absolute_time_t usb_deadline = make_timeout_time_ms(3000);

        while (!tud_ready()) {
            if (absolute_time_diff_us(get_absolute_time(), usb_deadline) <= 0) {
                printf("[BOOT] No USB host — standalone operation\n");
                break;
            }
            tud_task();
            encoder_poll();
            button_poll();
            carrier_poll();
            gpsdo_task();

            // OLED refresh during wait
            rxmon_task();
            if (!g_oled_freeze && !g_oled_off && !ssd1306_dma_busy() &&
                absolute_time_diff_us(get_absolute_time(), oled_next) <= 0) {
                oled_prepare_frame();
                ssd1306_display_dma(OLED_I2C);
                oled_next = make_timeout_time_ms(200);
            }

            sleep_ms(1);
        }
        printf("[BOOT] USB connected, starting normal SSB mode\n");
    }

    hilbert_init();

    const float Fs = (float)WAV_SAMPLE_RATE;

    float theta_prev = 0.0f;
    float f_acc = 0.0f;
    float fine_tune_phase = 0.0f;  // Phase accumulator for fine frequency tuning

    float p_acc = 0.0f;
    float tx_acc = 0.0f;

    const float phi = (float)IQ_PHASE_CORR_DEG * (float)M_PI / 180.0f;
    const float cphi = cosf(phi);
    const float sphi = sinf(phi);

#if AUDIO_ENABLE_BANDPASS
    biquad_t bp_hpf[AUDIO_BP_MAX_STAGES];
    biquad_t bp_lpf[AUDIO_BP_MAX_STAGES];
    // init via apply_cfg_if_dirty()
#endif

#if AUDIO_ENABLE_EQ
    biquad_t eq_low, eq_high;
    // init via apply_cfg_if_dirty()
#endif

#if AUDIO_ENABLE_COMPRESSOR
    compressor_t comp;
    // init via apply_cfg_if_dirty()
#endif

#if USE_TEST_TONE
    float sine_phase1 = 0.0f;
    const float sine_inc1 = 2.0f * (float)M_PI * (float)TEST_TONE_HZ / Fs;
#if USE_TWO_TONE_TEST
    float sine_phase2 = 0.0f;
    const float sine_inc2 = 2.0f * (float)M_PI * (float)TEST_TONE2_HZ / Fs;
#endif
#endif

    audio_cfg_t cfg_local;
    memset(&cfg_local, 0, sizeof(cfg_local));

    // PRE-BUFFERING: fill half of the blocks before starting consumer
    // This prevents underruns at startup
    const uint32_t prebuf_blocks = NUM_BLOCKS / 2;
    
    // silence reset counter
    const uint32_t silence_samples = WAV_SAMPLE_RATE * SILENCE_SECONDS;
    uint32_t silence_ctr = 0;

    // greet once if CDC is connected later
    uint8_t greeted = 0;

    // *** Pre-fill some blocks before signaling Core1 to start ***
    const uint32_t prebuf_target = NUM_BLOCKS / 2;  // Fill half the buffer
    uint32_t prebuf_count = 0;

    while (true) {
        uint32_t b = g_prod_block;

        // === CW/TUNE active: Core1 just drains blocks, no DSP needed ===
        // Run a tight poll loop instead of producing audio blocks.
        // Without this, Core1 drains so fast that the wait loop below
        // never executes, starving encoder/button/cw_keying polls.
        if (g_cw_test_mode) {
            usb_audio_pump();
            ui_service();

            encoder_poll();
            button_poll();
            carrier_poll();
            persist_maybe_autosave();

            // GPS UART must be drained here too: with the mode persisted the
            // device can boot straight into CW and never reach the SSB path.
            gpsdo_task();
            rxmon_task();
            if (gpsdo_status_due()) {
                char gbuf[128];
                gpsdo_format_status(gbuf, sizeof(gbuf));
                cdc_write_str(gbuf);
            }

#if CFG_TUD_CDC
            cdc_task();
#endif
            tight_loop_contents();
            continue;   // Skip block production entirely
        }

        while (g_block_ready[b]) {
            usb_audio_pump();
            ui_service();

            // Poll encoder + buttons + carrier state machine
            encoder_poll();
            button_poll();
            carrier_poll();
            persist_maybe_autosave();
            gpsdo_task();   // 32-byte UART FIFO fills in ~33 ms at 9600 baud — keep draining
            rxmon_task();

            tight_loop_contents();
        }

#if CFG_TUD_CDC
        if (!greeted && tud_cdc_connected()) {
            greeted = 1;
            cdc_write_str("\r\nSX1280_SDR control ready. FW " FW_VERSION " git=" FW_GIT_ID " built " FW_BUILD ". Type 'help'.\r\n");
            cdc_write_str(g_persist_loaded ? "Config: restored from flash.\r\n"
                                           : "Config: compile-time defaults (nothing valid in flash).\r\n");
            bootlog_flush();
            cfg_print();
        }

        // GPSDO: service GPS UART and send periodic status (every 10 s).
        gpsdo_task();
        rxmon_task();
        if (gpsdo_status_due()) {
            char gbuf[128];
            gpsdo_format_status(gbuf, sizeof(gbuf));
            cdc_write_str(gbuf);
        }
#endif

        // Apply pending cfg on block boundary
#if AUDIO_ENABLE_BANDPASS || AUDIO_ENABLE_EQ || AUDIO_ENABLE_COMPRESSOR
        apply_cfg_if_dirty(
            Fs,
#if AUDIO_ENABLE_BANDPASS
            bp_hpf, bp_lpf,
#else
            NULL, NULL,
#endif
#if AUDIO_ENABLE_EQ
            &eq_low, &eq_high,
#else
            NULL, NULL,
#endif
#if AUDIO_ENABLE_COMPRESSOR
            &comp,
#else
            NULL,
#endif
            &cfg_local
        );
#else
        // still snapshot cfg (amp, etc.)
        __compiler_memory_barrier();
        memcpy(&cfg_local, (const void*)&g_cfg, sizeof(cfg_local));
        __compiler_memory_barrier();
#endif

        // Get current base steps (with freq and PPM correction) at block boundary
        int32_t base_steps = (int32_t)get_base_steps();

        // --- Audio source for this block ---
        const uint8_t src = g_audio_src;
        {
            static uint8_t last_src = AUDIO_SRC_PC;
            if (src != last_src) {
                if (src == AUDIO_SRC_MIC) mic_flush();   // drop whatever piled up while unused
                last_src = src;
            }
        }
        if (src == AUDIO_SRC_MIC) {
            // Paced by the ADC: wait for a full block of mic samples, keeping
            // USB/UI/keyer alive meanwhile. Bail out if the mode or source changes.
            mic_dma_rearm_if_done();
            bool bail = false;
            while (mic_available() < BLOCK_SAMPLES) {
                usb_audio_pump();
                ui_service();
                encoder_poll();
                button_poll();
                carrier_poll();
                persist_maybe_autosave();
                gpsdo_task();
                rxmon_task();
                if (g_cw_test_mode || g_audio_src != AUDIO_SRC_MIC) { bail = true; break; }
                tight_loop_contents();
            }
            if (bail) continue;
        }
        ui_service();   // guarantees a refresh per block even if the wait above was short

        sample_cmd_t *blk = g_blocks[b];
        uint8_t blk_tx = 0;   // did this block actually drive the PA?

        for (uint32_t n = 0; n < BLOCK_SAMPLES; n++) {
            if ((n & 0x07u) == 0u) usb_audio_pump();

            float x = 0.0f;

#if USE_TEST_TONE
#if USE_TWO_TONE_TEST
            // Two-tone test: sum of two sinusoids
            x = TEST_TONE_AMPL * (sinf(sine_phase1) + sinf(sine_phase2));
            sine_phase1 += sine_inc1;
            sine_phase2 += sine_inc2;
            if (sine_phase1 > 2.0f * (float)M_PI) sine_phase1 -= 2.0f * (float)M_PI;
            if (sine_phase2 > 2.0f * (float)M_PI) sine_phase2 -= 2.0f * (float)M_PI;
#else
            x = TEST_TONE_AMPL * sinf(sine_phase1);
            sine_phase1 += sine_inc1;
            if (sine_phase1 > 2.0f * (float)M_PI) sine_phase1 -= 2.0f * (float)M_PI;
#endif
#else
            if (src == AUDIO_SRC_MIC) {
                x = mic_get_sample();
            } else {
                int16_t s = usb_audio_get_mono_8k();
                x = (float)s / 32768.0f;
            }

            if (fabsf(x) < 1e-5f) {
                if (silence_ctr < silence_samples) silence_ctr++;
            } else {
                silence_ctr = 0;
            }

            if (silence_ctr == silence_samples) {
                hilbert_reset();
                theta_prev = 0.0f;
                f_acc = 0.0f;
                fine_tune_phase = 0.0f;
                p_acc = 0.0f;
                tx_acc = 0.0f;

#if AUDIO_ENABLE_BANDPASS
                for (int i = 0; i < AUDIO_BP_MAX_STAGES; i++) {
                    biquad_reset(&bp_hpf[i]);
                    biquad_reset(&bp_lpf[i]);
                }
#endif
#if AUDIO_ENABLE_EQ
                biquad_reset(&eq_low);
                biquad_reset(&eq_high);
#endif
#if AUDIO_ENABLE_COMPRESSOR
                comp.env = 0.0f;
#endif
                silence_ctr = silence_samples + 1u;
            }
#endif

#if AUDIO_ENABLE_EQ
            if (cfg_local.enable_eq) {
                x = biquad_process(&eq_low,  x);
                x = biquad_process(&eq_high, x);
            }
#endif

#if AUDIO_ENABLE_COMPRESSOR
            if (cfg_local.enable_comp) {
                x = compressor_process(&comp, x);
                // output limiter
                if (x > cfg_local.comp_out_limit) x = cfg_local.comp_out_limit;
                if (x < -cfg_local.comp_out_limit) x = -cfg_local.comp_out_limit;
            }
#endif

#if AUDIO_ENABLE_BANDPASS
            if (cfg_local.enable_bandpass) {
                for (int i = 0; i < cfg_local.bp_stages; i++) x = biquad_process(&bp_hpf[i], x);
                for (int i = 0; i < cfg_local.bp_stages; i++) x = biquad_process(&bp_lpf[i], x);
            }
#endif

            float I;
            float Q = hilbert_process(x, &I);

            float Iq = I;
            float Qq = Q * (float)IQ_GAIN_CORR;

            float I2 = Iq * cphi - Qq * sphi;
            float Q2 = Iq * sphi + Qq * cphi;

            // Apply fine frequency tuning via complex carrier multiplication
            // Fine tune is calculated automatically from fractional Hz that PLL can't reach
            float fine_hz = get_fine_tune_hz();  // Auto-calculated from target freq + PPM
            if (fine_hz != 0.0f) {
                float fine_cos = cosf(fine_tune_phase);
                float fine_sin = sinf(fine_tune_phase);
                float I3 = I2 * fine_cos - Q2 * fine_sin;
                float Q3 = I2 * fine_sin + Q2 * fine_cos;
                I2 = I3;
                Q2 = Q3;
                fine_tune_phase += 2.0f * (float)M_PI * fine_hz / Fs;
                // Keep phase in [-π, π] to avoid precision loss
                if (fine_tune_phase > (float)M_PI)   fine_tune_phase -= 2.0f * (float)M_PI;
                if (fine_tune_phase < -(float)M_PI) fine_tune_phase += 2.0f * (float)M_PI;
            }

            float A = sqrtf(I2 * I2 + Q2 * Q2);

            float theta = atan2f(Q2, I2);

            float dtheta = theta - theta_prev;
            if (dtheta > (float)M_PI)   dtheta -= 2.0f * (float)M_PI;
            if (dtheta < -(float)M_PI) dtheta += 2.0f * (float)M_PI;
            theta_prev = theta;

            float f_off = dtheta * Fs / (2.0f * (float)M_PI);
            if (f_off > (float)F_OFF_LIMIT_HZ)  f_off = (float)F_OFF_LIMIT_HZ;
            if (f_off < -(float)F_OFF_LIMIT_HZ) f_off = -(float)F_OFF_LIMIT_HZ;

            float want_steps = f_off / PLL_STEP_HZ;
            int32_t Nf = (int32_t)floorf(want_steps);
            float ffrac = want_steps - (float)Nf;

            f_acc += ffrac;
            int32_t f_chosen = Nf;
            if (f_acc >= 1.0f) { f_chosen = Nf + 1; f_acc -= 1.0f; }

            int32_t cur_steps = base_steps + f_chosen;

            float duty = duty_from_A(A);

            int32_t p_chosen = PWR_MIN_DBM;
            uint8_t tx_on = 1;

            if (duty < 1.0f) {
                p_chosen = PWR_MIN_DBM;
                tx_acc += duty;
                if (tx_acc >= 1.0f) { tx_on = 1; tx_acc -= 1.0f; }
                else                { tx_on = 0; }
            } else {
                tx_on = 1;

                int8_t pwr_max = g_tx_power_max_dbm;  // Local copy for this sample
                float Aeff = A * cfg_local.amp_gain;
                if (Aeff < cfg_local.amp_min_a) Aeff = cfg_local.amp_min_a;

                float p_raw = (float)pwr_max + 20.0f * log10f(Aeff);

                float p_des = p_raw;
                if (p_des > (float)pwr_max) p_des = (float)pwr_max;
                if (p_des < (float)PWR_MIN_DBM) p_des = (float)PWR_MIN_DBM;

                int32_t p_low  = (int32_t)floorf(p_des);
                int32_t p_high = p_low + 1;

                if (p_low  < PWR_MIN_DBM) p_low  = PWR_MIN_DBM;
                if (p_high > pwr_max) p_high = pwr_max;

                float frac = p_des - (float)p_low;
                if (frac < 0.0f) frac = 0.0f;
                if (frac > 1.0f) frac = 1.0f;

                p_acc += frac;
                p_chosen = p_low;
                if (p_acc >= 1.0f && p_high != p_low) { p_chosen = p_high; p_acc -= 1.0f; }
            }

            // Global TX enable (GUI TX button), GPS gate and the SSB PTT
            if (!g_tx_enabled || !tx_allowed() || ssb_ptt_blocks()) {
                tx_on = 0;
            }

            blk[n].freq_steps = cur_steps;
            blk[n].p_dbm      = (int8_t)p_chosen;
            blk[n].tx_on      = tx_on;
            blk_tx |= tx_on;
        }
        if (blk_tx) tx_activity_mark();

        __compiler_memory_barrier();
        g_block_ready[b] = 1;
        __compiler_memory_barrier();

        g_prod_block = (b + 1u) % NUM_BLOCKS;

        // *** Signal Core1 to start after pre-buffering ***
        if (!g_core1_start) {
            prebuf_count++;
            if (prebuf_count >= prebuf_target) {
                __compiler_memory_barrier();
                g_core1_start = 1;
                __compiler_memory_barrier();
            }
        }
    }
}

// ==========================================================
// TinyUSB HID callbacks (stubs) – only compiled when HID is enabled
// ==========================================================
#if CFG_TUD_HID
uint16_t tud_hid_get_report_cb(uint8_t instance, uint8_t report_id,
                               hid_report_type_t report_type,
                               uint8_t* buffer, uint16_t reqlen)
{
    (void)instance; (void)report_id; (void)report_type; (void)buffer; (void)reqlen;
    return 0;
}

void tud_hid_set_report_cb(uint8_t instance, uint8_t report_id,
                           hid_report_type_t report_type,
                           uint8_t const* buffer, uint16_t bufsize)
{
    (void)instance; (void)report_id; (void)report_type; (void)buffer; (void)bufsize;
}
#endif /* CFG_TUD_HID */
