SimonRZz/SX1280_QO100_SSB_TX/gpsdo.c

// gpsdo.c — GPSDO integration for SX1280_QO100_SSB_TX (Pico SDK C)
//
// Ported from gpsdo_rp2350.ino (Arduino / CT2GQV).
// All Arduino-specific APIs replaced with Pico SDK equivalents.
//
// Hardware:
//   NEO-7M GPS  → UART1   GP4 = TX (→ GPS RX), GP5 = RX (← GPS TX)
//   SI5351      → I2C0    GP0 = SDA, GP1 = SCL
//   TCXO_EN (GP22) and SX1280 NRESET (GP20) are managed by main.c.
//
// NOTE: GP0/GP1 are used here for I2C.  CMakeLists.txt must therefore
//       set pico_enable_stdio_uart to 0 (UART0 defaults to GP0/GP1).

#include "gpsdo.h"

#include <string.h>
#include <stdio.h>

#include "pico/stdlib.h"
#include "hardware/i2c.h"
#include "hardware/uart.h"
#include "hardware/gpio.h"

// ---------------------------------------------------------------------------
// Configuration
// ---------------------------------------------------------------------------
#define GPSDO_I2C           i2c0
#define GPSDO_I2C_SDA       0u
#define GPSDO_I2C_SCL       1u
#define GPSDO_I2C_BAUD      100000u   // 100 kHz — reliable with internal pull-ups

// UART1 pin assignment.
// If uart_rx stays 0, try swapping these two lines (swap GP4 and GP5).
#define GPSDO_UART          uart1
#define GPSDO_UART_TX       4u        // Pico TX (output) → NEO-7M RX
#define GPSDO_UART_RX       5u        // Pico RX (input)  ← NEO-7M TX
#define GPSDO_GPS_BAUD      9600u

#define GPSDO_PRINT_MS      10000u    // status line interval (10 s — keeps RF quiet)
#define GPSDO_NMEA_STALE_MS 3000u
#define GPSDO_GGA_STALE_MS  5000u
#define GPSDO_GSV_FRESH_MS  10000u
#define GPSDO_SI5351_POLL_MS 30000u   // SI5351 reg-0 re-read interval once locked
#define GPSDO_SI5351_FAST_POLL_MS 500u // ... while still waiting for PLL lock at boot
#define GPSDO_LOST_MS       10000u    // no fix for this long after having had one = signal lost
#define GPSDO_NMEA_BUF      128u
#define GPSDO_BOOT_DELAY_MS 300u      // wait before sending UBX commands

// ---------------------------------------------------------------------------
// SI5351 minimal driver (I2C0)
// Two outputs, both from the 24 MHz GPS TIMEPULSE reference:
//
//   CLK1  52 MHz  → SX1280 XTA        PLL A: 24 MHz × (36 + 5/6) = 884 MHz
//                                     MS1:   884 ÷ 17 = 52 MHz
//   CLK0 144 MHz  → receive mixer LO  PLL B: 24 MHz × 36 = 864 MHz
//                 (off at boot, "lo 1")    MS0: 864 ÷ 6 = 144 MHz
//   CLK2  25 or 36 MHz → Si4732 RCLK      PLL B; "rclk freq" switches between
//                 (off at boot, "rclk 1")  MS2: 864 ÷ (34+14/25) or 864 ÷ 24
//
// Which receive-side signal sits on which output follows the board, not the
// other way round; electrically either would do, both are next to CLK1 on the
// package and both can be driven from PLL B.
//
// The mixer does not run on 144 MHz itself: its local oscillator is the 5th
// harmonic at 720 MHz, picked out by a high-pass and lifted by an SPF5189Z at
// the receiver. That is why CLK2 runs at 8 mA — the harmonic lives on the edge
// steepness — and why the divider is a plain even integer. Multiplying by 5
// also multiplies the phase noise by 20·log10(5) = 14 dB, so there is no room
// for a fractional divider here. 144 MHz is the only frequency near the target
// that PLL B reaches with an integer divider (720 ÷ 144 = 5 is not a legal
// MultiSynth value, 864 ÷ 6 is). Hence CLK0 at 8 mA with an even integer.
//
// The 25 MHz on CLK2 may be fractional: the Si4732 divides it by 800 and
// multiplies back up internally, so the two roughly cancel, and the part is
// built for a 32.768 kHz watch crystal at ±20 ppm. 864/25 is an exact
// fraction, so the frequency is exact.
//
// PLL A stays fractional, as it always was: 52 MHz needs a 624 MHz VCO for an
// integer path and there are only two PLLs. It has been on the air like this.
//
// Register values:
//   PLL A: p1=4202 (0x106A), p2=4, p3=6
//   MS1:   p1=1664 (0x0680), p2=0, p3=1
//   PLL B: p1=4096 (0x1000), p2=0, p3=1
//   MS0:   p1=256  (0x0100), p2=0,  p3=1    (144 MHz, integer ÷6)
//   MS2:   p1=3911 (0x0F47), p2=17, p3=25   (25 MHz, ÷34+14/25)
// ---------------------------------------------------------------------------
// SI5351 I2C address — auto-detected in gpsdo_init().
// Common values: 0x60 (SDO/AD0=GND), 0x61 (SDO/AD0=VCC).
// Some boards use 0x62 or 0x63; all four are tried.
// 0x00 means "not found yet".
static uint8_t s_si_addr = 0x00u;

// Receive-side outputs, both off until asked for.
static bool s_loOn   = false;  // CLK0, 144 MHz, mixer LO
static bool s_rclkOn = false;  // CLK2, switchable Si4732 reference clock
static uint8_t s_rclkDrive = 3u;  // IDRV field of CLK2_CTRL: 0=2mA .. 3=8mA
// 0 = direct 32.768 kHz, the demonstrated working SSB setup. The high-clock
// tests failed but did not isolate startup/property interpretation as the
// cause. Clock pickup is still a hypothesis; old cross-mode RSSI comparisons
// did not establish its amplitude or prove that a particular RC cures it.
// See si5351_write_pllb_and_ms2().
static uint8_t s_rclkMhz   = 0u;
static bool s_pllbReady = false;  // PLL B + MS0/MS2 configured yet?

#define SI_REG_STATUS      0u    // Device status (read-only)
#define SI_STATUS_SYS_INIT (1u << 7) // 1 = calibrating (not ready)
#define SI_STATUS_LOL_A    (1u << 5) // 1 = PLL A loss-of-lock
#define SI_STATUS_LOS_XTAL (1u << 3) // 1 = no signal on XA pin
#define SI_REG_OEB         3u    // Output Enable (active LOW per bit)
#define SI_REG_CLK0_CTRL   16u
#define SI_REG_CLK1_CTRL   17u
#define SI_REG_CLK2_CTRL   18u
#define SI_REG_PLLA_BASE   26u   // 8 bytes: regs 26-33
#define SI_REG_PLLB_BASE   34u   // 8 bytes: regs 34-41
#define SI_REG_MS0_BASE    42u   // 8 bytes: regs 42-49
#define SI_REG_MS1_BASE    50u   // 8 bytes: regs 50-57
#define SI_REG_MS2_BASE    58u   // 8 bytes: regs 58-65
#define SI_REG_PLL_RESET   177u
#define SI_REG_XTAL_LOAD   183u

#define SI_OEB_ALL_OFF     0xFFu

// Output enable is active LOW, one bit per clock: bit 0 = CLK0, 1 = CLK1,
// 2 = CLK2. Written only through si_write_oeb(), which always leaves CLK1
// enabled — it is the SX1280's only clock — so no combination of receive-side
// switching can take the transmitter's clock away.
#define SI_OEB_BIT_CLK0    (1u << 0)
#define SI_OEB_BIT_CLK1    (1u << 1)
#define SI_OEB_BIT_CLK2    (1u << 2)

// Scan 0x60–0x63 (all valid SI5351 I2C addresses).
// Retries up to 3 times with a short delay between attempts.
// Sets s_si_addr on success; leaves it 0x00 on failure.
static bool si5351_scan(void)
{
    static const uint8_t candidates[] = { 0x60u, 0x61u, 0x62u, 0x63u };
    for (int attempt = 0; attempt < 3; attempt++) {
        for (size_t i = 0; i < sizeof(candidates); i++) {
            uint8_t dummy;
            int ret = i2c_read_blocking(GPSDO_I2C, candidates[i], &dummy, 1, false);
            if (ret == 1) {
                s_si_addr = candidates[i];
                return true;
            }
        }
        sleep_ms(20);  // brief pause before retry
    }
    s_si_addr = 0x00u;  // explicit "not found"
    return false;
}

static bool si_write_reg(uint8_t reg, uint8_t val)
{
    uint8_t buf[2] = { reg, val };
    return i2c_write_blocking(GPSDO_I2C, s_si_addr, buf, 2, false) == 2;
}

static bool si_write_regs(uint8_t base, const uint8_t *data, size_t len)
{
    // max needed: 1 address byte + 8 data bytes = 9
    uint8_t buf[9];
    if (len == 0u || len > 8u) return false;
    buf[0] = base;
    memcpy(buf + 1, data, len);
    return i2c_write_blocking(GPSDO_I2C, s_si_addr, buf, len + 1u, false)
           == (int)(len + 1u);
}

static bool si_read_reg(uint8_t reg, uint8_t *val)
{
    if (i2c_write_blocking(GPSDO_I2C, s_si_addr, &reg, 1, true) != 1) return false;
    return i2c_read_blocking(GPSDO_I2C, s_si_addr, val, 1, false) == 1;
}

// Writes the output-enable register from the two receive-side flags. CLK1 is
// cleared unconditionally, so there is no code path — and no combination of
// "lo" and "rclk" — that can switch off the SX1280's clock.
static bool si_write_oeb(void)
{
    uint8_t v = SI_OEB_ALL_OFF;
    v &= (uint8_t)~SI_OEB_BIT_CLK1;                        // always on
    if (s_loOn)   v &= (uint8_t)~SI_OEB_BIT_CLK0;          // 144 MHz
    if (s_rclkOn) v &= (uint8_t)~SI_OEB_BIT_CLK2;          // 25 MHz
    return si_write_reg(SI_REG_OEB, v);
}

static bool si5351_init_clocks(void)
{
    // Scan for SI5351 at 0x60–0x63 before writing any registers.
    if (!si5351_scan()) return false;

    // Disable all outputs while configuring.
    if (!si_write_reg(SI_REG_OEB, SI_OEB_ALL_OFF)) return false;

    // Power down both receive-side outputs. PLL B and their MultiSynths are
    // NOT configured here — see si5351_init_pllb() for why.
    si_write_reg(SI_REG_CLK0_CTRL, 0x80u);
    si_write_reg(SI_REG_CLK2_CTRL, 0x80u);

    // CLK1: PDN=0, INT=1 (integer mode), MS_SRC=PLLA, INV=0,
    //        CLK_SRC=MS1(self)=0b11, IDRV=4mA=0b01
    //   Byte: 0b 0 1 0 0 11 01 = 0x4D
    si_write_reg(SI_REG_CLK1_CTRL, 0x4Du);

    // Crystal load capacitance: 8 pF (bits[7:6]=0b10) + reserved 0x12.
    si_write_reg(SI_REG_XTAL_LOAD, 0x92u);

    // PLL A: p1=4202=0x106A, p2=4, p3=6
    //   Regs 26-33: [p3_hi, p3_lo, p1[17:16], p1_hi, p1_lo,
    //                p3[19:16]|p2[19:16], p2_hi, p2_lo]
    static const uint8_t plla[8] = {
        0x00u, 0x06u,   // p3=6
        0x00u,          // p1[17:16]=0
        0x10u, 0x6Au,   // p1[15:8]=0x10, p1[7:0]=0x6A  (4202)
        0x00u,          // upper nibbles of p3/p2 = 0
        0x00u, 0x04u    // p2=4
    };
    if (!si_write_regs(SI_REG_PLLA_BASE, plla, 8u)) return false;

    // MS1 (CLK1): p1=1664=0x0680, p2=0, p3=1
    //   Regs 50-57
    static const uint8_t ms1[8] = {
        0x00u, 0x01u,   // p3=1
        0x00u,          // R_DIV=/1, DIVBY4=0, p1[17:16]=0
        0x06u, 0x80u,   // p1[15:8]=0x06, p1[7:0]=0x80  (1664)
        0x00u,          // upper nibbles = 0
        0x00u, 0x00u    // p2=0
    };
    if (!si_write_regs(SI_REG_MS1_BASE, ms1, 8u)) return false;

    si_write_reg(SI_REG_PLL_RESET, 0xA0u);

    s_pllbReady = false;
    s_loOn      = false;
    s_rclkOn    = false;
    si_write_oeb();

    return true;
}

// Configures PLL B and the two receive-side MultiSynths, once, on first use.
//
// This used to happen during gpsdo_init(), and the transmitter then started
// hanging at "SI5351: PLL unlocked" — sporadically at first, then every time.
// PLL A is the SX1280's only clock, and bringing a second PLL and two more
// MultiSynths up alongside it costs supply current on a 3V3 rail that already
// carries the OLED, the GPS, the microphone amplifier and now the Si4732.
//
// So the boot path is back to exactly what it was for months: PLL A, MS1,
// CLK1, nothing else. The receive side is built only when someone asks for it,
// which cannot happen before the boot gate has seen a locked 52 MHz.
// MultiSynth 2 and its control byte, for whichever reference the Si4732 is
// being fed. Both come off PLL B at 864 MHz.
//
//   25 MHz: 864 ÷ (34 + 14/25), p1=3911 (0x0F47), p2=17, p3=25 — fractional
//   36 MHz: 864 ÷ 24,           p1=2560 (0x0A00), p2=0,  p3=1  — even integer
//
// 25 MHz was the original choice and it works, but on this board it leaks into
// the Si4732's AM input at 65 dBuV. With a 19.5 MHz IF that is five megahertz
// away, inside the front end's reach, and it drags the AGC down across the
// whole band. 36 MHz moves it to sixteen megahertz away and, being an even
// integer divisor, lets the MultiSynth run in integer mode, which is quieter
// again. The Si4732 does not care which it gets: it divides down to about
// 32 kHz either way (800 and 1125 both divide exactly).
// 32.768 kHz needs a different PLL B as well, so this writes both.
//
// Every reference design for this patch clocks the part from a 32.768 kHz
// watch crystal. 25 MHz / 800 and 36 MHz / 1125 are structurally the same
// thing - a high clock through the prescaler - and they behaved identically,
// which says less than it looked like it did. A direct 32.768 kHz with
// prescaler 1 is the case that has never been tried.
//
//   PLL B = 24 MHz x (32 + 96/125) = 786.432 MHz   (a=32, b=96, c=125)
//   MS2   = 375 (integer), R = 64
//   786.432e6 / 375 / 64 = 32768 Hz exactly
//
// It costs CLK0: 144 MHz is not an integer divisor of 786.432 MHz, so the
// mixer LO is switched off while this is selected.
static bool si5351_write_pllb_and_ms2(void)
{
    static const uint8_t pllb_864[8] = {            // 24 x 36      = 864 MHz
        0x00u, 0x01u, 0x00u, 0x10u, 0x00u, 0x00u, 0x00u, 0x00u
    };
    static const uint8_t pllb_786[8] = {            // 24 x 32.768  = 786.432 MHz
        0x00u, 0x7Du, 0x00u, 0x0Eu, 0x62u, 0x00u, 0x00u, 0x26u
    };
    static const uint8_t ms0_144[8] = {             // 864 / 6      = 144 MHz
        0x00u, 0x01u, 0x00u, 0x01u, 0x00u, 0x00u, 0x00u, 0x00u
    };
    static const uint8_t ms2_25[8] = {              // 864 / (34+14/25)
        0x00u, 0x19u, 0x00u, 0x0Fu, 0x47u, 0x00u, 0x00u, 0x11u
    };
    static const uint8_t ms2_36[8] = {              // 864 / 24
        0x00u, 0x01u, 0x00u, 0x0Au, 0x00u, 0x00u, 0x00u, 0x00u
    };
    static const uint8_t ms2_32k[8] = {             // 786.432 / 375, R = 64
        0x00u, 0x01u, 0x60u, 0xB9u, 0x80u, 0x00u, 0x00u, 0x00u
    };
    // 32.768 MHz: 864 / (26 + 47/128), p1=2863 (0x0B2F), p2=0, p3=128.
    // 864e6 * 128 / 3375 = 32 768 000 Hz exactly. Divided by 1000 in the
    // Si4732 that requests the same 32768 Hz reference, but actual SSB RX
    // with this configuration is not established. PLL B stays at 864 MHz,
    // so CLK0 keeps its 144 MHz and the mixer LO survives.
    static const uint8_t ms2_32m[8] = {
        0x00u, 0x80u, 0x00u, 0x0Bu, 0x2Fu, 0x00u, 0x00u, 0x00u
    };

    const bool low = (s_rclkMhz == 0u);             // 0 marks 32.768 kHz
    if (!si_write_regs(SI_REG_PLLB_BASE, low ? pllb_786 : pllb_864, 8u)) return false;
    if (!si_write_regs(SI_REG_MS0_BASE,  ms0_144, 8u)) return false;

    const uint8_t *ms2 = low ? ms2_32k
                       : (s_rclkMhz == 36u) ? ms2_36
                       : (s_rclkMhz == 32u) ? ms2_32m
                                            : ms2_25;
    const bool integer = low || (s_rclkMhz == 36u);
    if (!si_write_regs(SI_REG_MS2_BASE, ms2, 8u)) return false;

    // CLK2: PDN=0, MS2_INT per the divisor, MS_SRC=PLL B, CLK_SRC=MS2, IDRV.
    // 8 mA, because 2 mA left the Si4732 answering on I2C but refusing to tune.
    return si_write_reg(SI_REG_CLK2_CTRL,
                        (uint8_t)((integer ? 0x6Cu : 0x2Cu) | (s_rclkDrive & 3u)));
}

static bool si5351_init_pllb(void)
{
    if (s_pllbReady) return true;

    if (!si5351_write_pllb_and_ms2()) return false;

    // CLK0: PDN=0, INT=1, PLL B, CLK_SRC=MS0, 8 mA — the mixer LO lives on the
    // 5th harmonic, which only exists because the edges are steep.
    si_write_reg(SI_REG_CLK0_CTRL, 0x6Fu);

    // PLL B ONLY. 0xA0 would reset PLL A as well and take the SX1280's clock
    // away for milliseconds, in the middle of transmission.
    if (!si_write_reg(SI_REG_PLL_RESET, 0x80u)) return false;

    s_pllbReady = true;
    return true;
}

// Switch the 144 MHz mixer LO (CLK0). Useful for measuring the LO branch
// against a quiet baseline, and for silencing it during transmit.
bool gpsdo_set_lo_enabled(bool on)
{
    if (s_si_addr == 0x00u) return false;
    // PLL B is at 786.432 MHz for the 32.768 kHz reference and cannot make
    // 144 MHz from it.
    if (on && s_rclkMhz == 0u) return false;
    if (on && !si5351_init_pllb()) return false;
    bool prev = s_loOn;
    s_loOn = on;
    if (!si_write_oeb()) { s_loOn = prev; return false; }
    return true;
}

// Switch the 25 MHz Si4732 reference clock (CLK2). The receiver cannot tune
// without it, so si4732 bring-up turns it on first.
bool gpsdo_set_rclk_enabled(bool on)
{
    if (s_si_addr == 0x00u) return false;
    if (on && !si5351_init_pllb()) return false;
    bool prev = s_rclkOn;
    s_rclkOn = on;
    if (!si_write_oeb()) { s_rclkOn = prev; return false; }
    return true;
}

bool gpsdo_rclk_enabled(void) { return s_rclkOn; }

// Drive strength of CLK2, settable at runtime because the level the Si4732
// needs on its RCLK pin is not something this project has pinned down: the
// chip talks happily but refuses to tune when the reference is too weak, and
// that is a bench question, not a datasheet one. 2, 4, 6 or 8 mA.
bool gpsdo_set_rclk_drive(uint8_t ma)
{
    if (s_si_addr == 0x00u) return false;
    if (!si5351_init_pllb()) return false;
    uint8_t idrv;
    switch (ma) {
        case 2u: idrv = 0u; break;
        case 4u: idrv = 1u; break;
        case 6u: idrv = 2u; break;
        case 8u: idrv = 3u; break;
        default: return false;
    }
    uint8_t prev = s_rclkDrive;
    s_rclkDrive = idrv;
    // Through the same writer, so the integer-mode bit cannot drift out of
    // step with the divisor currently loaded.
    if (!si5351_write_pllb_and_ms2()) { s_rclkDrive = prev; return false; }
    return true;
}

// Move the Si4732's reference between 25 and 36 MHz. Only MultiSynth 2
// changes; PLL B and CLK0's 144 MHz stay as they are. The PLL B reset
// afterwards is belt and braces for the switch between fractional and integer
// mode — it disturbs the mixer LO for microseconds and nothing else. CLK1,
// the SX1280's 52 MHz, is on PLL A and is not touched.
//
// This moves one end of the link only. si4732_set_rclk_hz() moves the other,
// and the receiver tunes wrong until both agree.
// mhz: 25, 36, or 0 for 32.768 kHz.
bool gpsdo_set_rclk_mhz(uint8_t mhz)
{
    // 0 = 32.768 kHz, 32 = 32.768 MHz, 25 and 36 are what they say.
    if (mhz != 25u && mhz != 36u && mhz != 0u && mhz != 32u) return false;
    if (s_si_addr == 0x00u) return false;
    if (!si5351_init_pllb()) return false;

    uint8_t prev = s_rclkMhz;
    s_rclkMhz = mhz;
    // 144 MHz is not an integer divisor of 786.432 MHz, so the mixer LO has
    // no valid setting here. Switch it off rather than emit a wrong frequency.
    if (mhz == 0u && s_loOn) { s_loOn = false; (void)si_write_oeb(); }
    if (!si5351_write_pllb_and_ms2()) { s_rclkMhz = prev; return false; }
    return si_write_reg(SI_REG_PLL_RESET, 0x80u);
}

uint8_t gpsdo_rclk_mhz(void) { return s_rclkMhz; }

uint8_t gpsdo_rclk_drive(void)
{
    static const uint8_t ma[4] = { 2u, 4u, 6u, 8u };
    return ma[s_rclkDrive & 3u];
}

bool gpsdo_lo_enabled(void) { return s_loOn; }

// ---------------------------------------------------------------------------
// Runtime state
// ---------------------------------------------------------------------------
static int      s_fixQuality      = 0;
static int      s_satsUsed        = 0;
static char     s_utc[7]          = "------";
static char     s_date[7]         = "------"; // ddmmyy from RMC
static bool     s_clk1Ok          = false;   // I2C init succeeded
static uint8_t  s_si5351_status   = 0xFFu;   // SI5351 reg 0; 0xFF = not yet read
static uint32_t s_si5351_pollMs   = 0u;
static bool     s_gpsdoReady      = false;

// Position & locator (updated from GGA when fixQuality > 0)
static float    s_lat             = 0.0f;    // decimal degrees, positive = N
static float    s_lon             = 0.0f;    // decimal degrees, positive = E
static int16_t  s_alt_m           = 0;       // altitude in metres
static bool     s_has_position    = false;
static char     s_locator[7]      = "------"; // 6-char Maidenhead

// Returns the clk1= status string based on SI5351 register 0.
// "ok"  – PLL A locked, XA signal present
// "lol" – PLL A loss of lock (XA seen but PLL not locked)
// "los" – loss of signal on XA (GPS 24 MHz not reaching SI5351)
// "fail"– I2C init failed (SI5351 not found or bus error)
static const char *si5351_clk_status(void)
{
    if (!s_clk1Ok)                              return "fail";
    if (s_si5351_status == 0xFFu)               return "ok";   // not yet polled
    if (s_si5351_status & SI_STATUS_LOS_XTAL)   return "los";
    if (s_si5351_status & SI_STATUS_LOL_A)      return "lol";
    return "ok";
}

static char     s_nmeaBuf[GPSDO_NMEA_BUF];
static size_t   s_nmeaIdx         = 0;
static bool     s_collecting      = false;
static bool     s_nmeaOverflow    = false;

static uint32_t s_lastNmeaMs      = 0;
static uint32_t s_lastTimeMs      = 0;
static uint32_t s_lastGgaMs       = 0;
static uint32_t s_lastGoodMs      = 0;       // last moment with SI5351 lock AND a position fix
static uint32_t s_lastPrintMs     = 0;
static uint32_t s_uartBytesRx     = 0;   // raw bytes received from GPS UART
static uint32_t s_nmeaCount       = 0;   // valid NMEA sentences parsed
static uint32_t s_detected_baud   = 0;   // baud rate confirmed during auto-detect

// GSV buckets: GP=0, GL=1, GA=2, GB/BD=3, GQ=4, GI=5, GN=6
#define GSV_BUCKETS 7u
static uint8_t  s_gsvVisible[GSV_BUCKETS];
static uint32_t s_gsvStampMs[GSV_BUCKETS];

// ---------------------------------------------------------------------------
// Internal helpers
// ---------------------------------------------------------------------------
static inline uint32_t gpsdo_ms(void)
{
    return to_ms_since_boot(get_absolute_time());
}

static inline bool is_digit6(const char *p)
{
    if (!p) return false;
    for (uint8_t i = 0u; i < 6u; i++) {
        if (p[i] < '0' || p[i] > '9') return false;
    }
    return true;
}

static uint16_t parse_uint(const char *p)
{
    if (!p) return 0u;
    uint16_t v = 0u; bool any = false;
    while (*p >= '0' && *p <= '9') {
        any = true;
        v = (uint16_t)(v * 10u + (uint16_t)(*p - '0'));
        ++p;
    }
    return any ? v : 0u;
}

static int8_t hex_nibble(char c)
{
    if (c >= '0' && c <= '9') return (int8_t)(c - '0');
    if (c >= 'A' && c <= 'F') return (int8_t)(c - 'A' + 10);
    if (c >= 'a' && c <= 'f') return (int8_t)(c - 'a' + 10);
    return -1;
}

static const char *nmea_field(const char *s, uint8_t n)
{
    uint8_t cnt = 0u;
    while (*s) {
        if (cnt == n) return s;
        if (*s == '*') break;
        if (*s == ',') cnt++;
        s++;
    }
    return (cnt == n) ? s : NULL;
}

static bool nmea_checksum_ok(const char *s)
{
    if (!s || s[0] != '$') return false;
    uint8_t cs = 0u;
    const char *p = s + 1;
    while (*p && *p != '*') { cs ^= (uint8_t)(*p); ++p; }
    if (*p != '*' || !p[1] || !p[2]) return false;
    int8_t hi = hex_nibble(p[1]);
    int8_t lo = hex_nibble(p[2]);
    if (hi < 0 || lo < 0) return false;
    return cs == (uint8_t)(((uint8_t)hi << 4) | (uint8_t)lo);
}

static int8_t talker_to_gsv_bucket(char t1, char t2)
{
    if (t1 == 'G' && t2 == 'P') return 0;
    if (t1 == 'G' && t2 == 'L') return 1;
    if (t1 == 'G' && t2 == 'A') return 2;
    if ((t1 == 'G' && t2 == 'B') || (t1 == 'B' && t2 == 'D')) return 3;
    if (t1 == 'G' && t2 == 'Q') return 4;
    if (t1 == 'G' && t2 == 'I') return 5;
    if (t1 == 'G' && t2 == 'N') return 6;
    return -1;
}

static uint16_t get_visible_sats(void)
{
    const uint32_t now = gpsdo_ms();
    // Prefer combined GN bucket if fresh.
    if (s_gsvStampMs[6] != 0u &&
        (now - s_gsvStampMs[6]) <= GPSDO_GSV_FRESH_MS) {
        return s_gsvVisible[6];
    }
    uint16_t sum = 0u;
    for (uint8_t i = 0u; i < 6u; i++) {
        if (s_gsvStampMs[i] != 0u &&
            (now - s_gsvStampMs[i]) <= GPSDO_GSV_FRESH_MS) {
            sum += s_gsvVisible[i];
        }
    }
    return sum;
}

// ---------------------------------------------------------------------------
// Coordinate helpers
// ---------------------------------------------------------------------------

// Parse "DDMM.MMMM" (lat, deg_digits=2) or "DDDMM.MMMM" (lon, deg_digits=3)
// into decimal degrees. Returns 0 on malformed input. Apply N/S/E/W sign outside.
static float parse_nmea_coord(const char *p, int deg_digits)
{
    if (!p || *p < '0' || *p > '9') return 0.0f;
    int32_t deg = 0;
    for (int i = 0; i < deg_digits; i++) {
        if (p[i] < '0' || p[i] > '9') return 0.0f;
        deg = deg * 10 + (p[i] - '0');
    }
    const char *mp = p + deg_digits;
    float min = 0.0f, frac = 0.1f;
    bool dot = false;
    while (*mp && *mp != ',' && *mp != '*') {
        if (*mp == '.') { dot = true; mp++; continue; }
        if (*mp < '0' || *mp > '9') break;
        if (!dot) { min = min * 10.0f + (float)(*mp - '0'); }
        else      { min += (float)(*mp - '0') * frac; frac *= 0.1f; }
        mp++;
    }
    return (float)deg + min / 60.0f;
}

// Parse altitude field (metres, may be fractional — truncate to integer).
static int16_t parse_alt(const char *p)
{
    if (!p || (*p != '-' && (*p < '0' || *p > '9'))) return 0;
    bool neg = (*p == '-'); if (neg) p++;
    int32_t v = 0;
    while (*p >= '0' && *p <= '9') { v = v * 10 + (*p - '0'); p++; }
    if (v > 32767) v = 32767;
    return (int16_t)(neg ? -v : v);
}

// Compute 6-character Maidenhead locator from decimal degrees.
static void compute_maidenhead(float lat, float lon, char *loc6)
{
    lon += 180.0f;  lat += 90.0f;           // shift to positive range
    int fl = (int)(lon / 20.0f);  if (fl > 17) fl = 17;
    int fa = (int)(lat / 10.0f);  if (fa > 17) fa = 17;
    lon -= fl * 20.0f;  lat -= fa * 10.0f;
    int sl = (int)(lon / 2.0f);   if (sl > 9) sl = 9;
    int sa = (int)(lat);          if (sa > 9) sa = 9;
    lon -= sl * 2.0f;  lat -= (float)sa;
    int ssl = (int)(lon * 12.0f); if (ssl > 23) ssl = 23;
    int ssa = (int)(lat * 24.0f); if (ssa > 23) ssa = 23;
    loc6[0] = (char)('A' + fl);
    loc6[1] = (char)('A' + fa);
    loc6[2] = (char)('0' + sl);
    loc6[3] = (char)('0' + sa);
    loc6[4] = (char)('a' + ssl);
    loc6[5] = (char)('a' + ssa);
    loc6[6] = '\0';
}

// ---------------------------------------------------------------------------
// NMEA parsers
// ---------------------------------------------------------------------------
static void parse_time(const char *s, uint8_t fn)
{
    const char *f = nmea_field(s, fn);
    if (f && is_digit6(f)) {
        for (uint8_t i = 0u; i < 6u; i++) s_utc[i] = f[i];
        s_utc[6] = '\0';
        s_lastTimeMs = gpsdo_ms();
    }
}

static void parse_gga(const char *s)
{
    s_lastGgaMs  = gpsdo_ms();
    parse_time(s, 1u);
    s_fixQuality = (int)parse_uint(nmea_field(s, 6u));
    s_satsUsed   = (int)parse_uint(nmea_field(s, 7u));
    if (s_fixQuality > 0) {
        const char *lat_f = nmea_field(s, 2u);
        const char *ns_f  = nmea_field(s, 3u);
        const char *lon_f = nmea_field(s, 4u);
        const char *ew_f  = nmea_field(s, 5u);
        const char *alt_f = nmea_field(s, 9u);
        if (lat_f && ns_f && lon_f && ew_f &&
            lat_f[0] >= '0' && lat_f[0] <= '9') {
            float lat = parse_nmea_coord(lat_f, 2);
            float lon = parse_nmea_coord(lon_f, 3);
            if (ns_f[0] == 'S') lat = -lat;
            if (ew_f[0] == 'W') lon = -lon;
            s_lat = lat; s_lon = lon;
            s_has_position = true;
            compute_maidenhead(lat, lon, s_locator);
        }
        if (alt_f) s_alt_m = parse_alt(alt_f);
    }
}

static void parse_rmc(const char *s)
{
    parse_time(s, 1u);
    const char *d = nmea_field(s, 9u);          // ddmmyy
    if (d && is_digit6(d)) {
        for (uint8_t i = 0u; i < 6u; i++) s_date[i] = d[i];
        s_date[6] = '\0';
    }
}

static void parse_gsv(const char *s)
{
    if (parse_uint(nmea_field(s, 2u)) != 1u) return; // only first message
    uint16_t visible = parse_uint(nmea_field(s, 3u));
    int8_t bucket    = talker_to_gsv_bucket(s[1], s[2]);
    if (bucket < 0) return;
    s_gsvVisible[(uint8_t)bucket] = (visible > 255u) ? 255u : (uint8_t)visible;
    s_gsvStampMs[(uint8_t)bucket] = gpsdo_ms();
}

static void process_nmea_sentence(const char *s)
{
    if (s[0] != '$' || s[1] == '\0' || s[2] == '\0' ||
        s[3] == '\0' || s[4] == '\0' || s[5] == '\0') return;
    if (!nmea_checksum_ok(s)) return;
    s_lastNmeaMs = gpsdo_ms();
    s_nmeaCount++;
    char c4 = s[3], c5 = s[4], c6 = s[5];
    if (c4 == 'G' && c5 == 'G' && c6 == 'A') { parse_gga(s); return; }
    if (c4 == 'R' && c5 == 'M' && c6 == 'C') { parse_rmc(s); return; }
    if (c4 == 'G' && c5 == 'S' && c6 == 'V') { parse_gsv(s); return; }
}

static void process_incoming_gps(void)
{
    while (uart_is_readable(GPSDO_UART)) {
        char c = (char)uart_getc(GPSDO_UART);
        s_uartBytesRx++;
        if (c == '$') {
            s_collecting   = true;
            s_nmeaOverflow = false;
            s_nmeaIdx      = 0u;
            s_nmeaBuf[s_nmeaIdx++] = c;
            continue;
        }
        if (!s_collecting) continue;
        if (c == '\r' || c == '\n') {
            if (!s_nmeaOverflow && s_nmeaIdx > 6u) {
                s_nmeaBuf[s_nmeaIdx] = '\0';
                process_nmea_sentence(s_nmeaBuf);
            }
            s_collecting   = false;
            s_nmeaOverflow = false;
            s_nmeaIdx      = 0u;
            continue;
        }
        if (!s_nmeaOverflow) {
            if (s_nmeaIdx < (GPSDO_NMEA_BUF - 1u))
                s_nmeaBuf[s_nmeaIdx++] = c;
            else
                s_nmeaOverflow = true;
        }
    }
}

// ---------------------------------------------------------------------------
// UBX configuration packets
// ---------------------------------------------------------------------------

// CFG-TP5: TIMEPULSE2 = 24 MHz continuous (drives SI5351 reference input).
static const uint8_t UBX_CFG_TP5_24MHZ[] = {
    0xB5, 0x62, 0x06, 0x31, 0x20, 0x00, 0x00, 0x01,
    0x00, 0x00, 0x00, 0x00, 0x00, 0x00, 0x00, 0x36,
    0x6E, 0x01, 0x00, 0x36, 0x6E, 0x01, 0x00, 0x00,
    0x00, 0x80, 0x00, 0x00, 0x00, 0x80, 0x00, 0x00,
    0x00, 0x00, 0x6F, 0x00, 0x00, 0x00, 0x11, 0xD8
};

// CFG-NAV5: Stationary dynamic model.
static const uint8_t UBX_CFG_NAV5_STATIONARY[] = {
    0xB5, 0x62, 0x06, 0x24, 0x24, 0x00, 0xFF, 0xFF,
    0x02, 0x03, 0x00, 0x00, 0x00, 0x00, 0x10, 0x27,
    0x00, 0x00, 0x05, 0x00, 0xFA, 0x00, 0xFA, 0x00,
    0x64, 0x00, 0x2C, 0x01, 0x00, 0x3C, 0x00, 0x00,
    0x00, 0x00, 0x00, 0x00, 0x00, 0x00, 0x00, 0x00,
    0x00, 0x00, 0x4E, 0x60
};

static void send_ubx_packet(const uint8_t *pkt, size_t len)
{
    for (size_t i = 0u; i < len; i++) {
        uart_putc_raw(GPSDO_UART, pkt[i]);
    }
}

// ---------------------------------------------------------------------------
// Public API
// ---------------------------------------------------------------------------

void gpsdo_init(void)
{
    memset(s_gsvVisible, 0, sizeof(s_gsvVisible));
    memset(s_gsvStampMs, 0, sizeof(s_gsvStampMs));

    // ── I2C0 for SI5351 ──────────────────────────────────────────────────────
    i2c_init(GPSDO_I2C, GPSDO_I2C_BAUD);
    gpio_set_function(GPSDO_I2C_SDA, GPIO_FUNC_I2C);
    gpio_set_function(GPSDO_I2C_SCL, GPIO_FUNC_I2C);
    gpio_pull_up(GPSDO_I2C_SDA);
    gpio_pull_up(GPSDO_I2C_SCL);

    sleep_ms(10u); // SI5351 power-on stabilisation

    s_clk1Ok = si5351_init_clocks();
    if (s_clk1Ok) {
        sleep_ms(50u);  // give PLL time to lock before reading status
        si_read_reg(SI_REG_STATUS, &s_si5351_status);
        s_si5351_pollMs = to_ms_since_boot(get_absolute_time());
        printf("[GPSDO] SI5351 reg0=0x%02X: clk1=%s  "
               "(LOL_A=%d LOS_XTAL=%d SYS_INIT=%d)\n",
               (unsigned)s_si5351_status, si5351_clk_status(),
               !!(s_si5351_status & SI_STATUS_LOL_A),
               !!(s_si5351_status & SI_STATUS_LOS_XTAL),
               !!(s_si5351_status & SI_STATUS_SYS_INIT));
    } else {
        printf("[GPSDO] SI5351 not found or I2C error\n");
    }

    // ── UART1 for NEO-7M GPS ─────────────────────────────────────────────────
    gpio_set_function(GPSDO_UART_TX, GPIO_FUNC_UART);
    gpio_set_function(GPSDO_UART_RX, GPIO_FUNC_UART);

    // Auto-detect GPS baud rate.
    // NEO-7M default is 9600, but u-center or prior config may have changed it.
    // We try each rate for 400 ms and look for a '$' (NMEA sentence start).
    static const uint32_t baud_candidates[] = { 9600u, 38400u, 57600u, 115200u };
    uint32_t detected_baud = 9600u; // fallback
    for (size_t bi = 0u; bi < sizeof(baud_candidates)/sizeof(baud_candidates[0]); bi++) {
        uart_init(GPSDO_UART, baud_candidates[bi]);
        uart_set_format(GPSDO_UART, 8, 1, UART_PARITY_NONE);
        // Drain stale bytes from previous attempt.
        while (uart_is_readable(GPSDO_UART)) { uart_getc(GPSDO_UART); }
        uint32_t t_end = to_ms_since_boot(get_absolute_time()) + 400u;
        uint32_t rx_count = 0u;
        bool found_dollar = false;
        while ((int32_t)(to_ms_since_boot(get_absolute_time()) - t_end) < 0) {
            if (uart_is_readable(GPSDO_UART)) {
                char c = (char)uart_getc(GPSDO_UART);
                rx_count++;
                if (c == '$') { found_dollar = true; }
            }
        }
        if (found_dollar && rx_count >= 10u) {
            // Enough data with a proper NMEA start — baud rate confirmed.
            detected_baud = baud_candidates[bi];
            s_uartBytesRx = rx_count;
            break;
        }
    }
    // Re-init at confirmed baud rate (already set in loop, but make it explicit).
    uart_init(GPSDO_UART, detected_baud);
    uart_set_format(GPSDO_UART, 8, 1, UART_PARITY_NONE);
    while (uart_is_readable(GPSDO_UART)) { uart_getc(GPSDO_UART); }

    // Store detected baud for status reporting.
    s_detected_baud = detected_baud;

    send_ubx_packet(UBX_CFG_TP5_24MHZ,       sizeof(UBX_CFG_TP5_24MHZ));
    sleep_ms(50u);
    send_ubx_packet(UBX_CFG_NAV5_STATIONARY, sizeof(UBX_CFG_NAV5_STATIONARY));
    sleep_ms(50u);

    printf("[GPSDO] UBX config sent — waiting for GPS lock...\n");
}

static bool si_locked_now(void)
{
    return s_clk1Ok &&
           !(s_si5351_status & SI_STATUS_LOS_XTAL) &&
           !(s_si5351_status & SI_STATUS_LOL_A);
}

void gpsdo_task(void)
{
    process_incoming_gps();

    // Re-read the SI5351 status register. Fast while waiting for the PLL at
    // boot (the GPS TIMEPULSE may appear a moment after UBX config); slow once
    // locked, to keep I2C traffic away from an active transmission.
    if (s_clk1Ok) {
        uint32_t now_ms = to_ms_since_boot(get_absolute_time());
        uint32_t interval = si_locked_now() ? GPSDO_SI5351_POLL_MS
                                            : GPSDO_SI5351_FAST_POLL_MS;
        if ((now_ms - s_si5351_pollMs) >= interval) {
            s_si5351_pollMs = now_ms;
            si_read_reg(SI_REG_STATUS, &s_si5351_status);
        }
    }

    // READY when SI5351 is locked AND GPS has provided at least one UTC timestamp.
    // UTC appearing means the GPS module has disciplined its oscillator to at least
    // one satellite — the TIMEPULSE 24 MHz is now frequency-accurate.
    // Without UTC the GPS runs on its free-running TCXO (±2.5 ppm = ±6 kHz at 2.4 GHz).
    const bool utc_valid = (s_utc[0] != '-');
    // Remember the last moment everything was actually good, so a lock that
    // is lost later can be reported (s_gpsdoReady itself never falls back:
    // the SX1280 keeps running on the free-wheeling TIMEPULSE).
    if (si_locked_now() && s_fixQuality > 0 && s_satsUsed >= 3) {
        s_lastGoodMs = gpsdo_ms();
    }

    if (!s_gpsdoReady && si_locked_now() && utc_valid) {
        s_gpsdoReady = true;
        printf("[GPSDO] READY — SI5351 locked + GPS UTC received, TX enabled\n");
    }
}

// Re-runs the clock configuration from scratch. The boot gate calls this when
// PLL A has not locked after a few seconds, rather than waiting forever: a
// single write lost on the I2C bus, or a PLL that came up unlocked, is worth one
// more attempt before telling the operator the transmitter cannot start.
bool gpsdo_retry_clock(void)
{
    s_clk1Ok = si5351_init_clocks();
    if (s_clk1Ok) {
        sleep_ms(50u);
        si_read_reg(SI_REG_STATUS, &s_si5351_status);
        s_si5351_pollMs = gpsdo_ms();
    }
    return s_clk1Ok;
}

bool gpsdo_clock_ok(void)
{
    return si_locked_now();
}

bool gpsdo_signal_lost(void)
{
    if (s_lastGoodMs == 0u) return false;                     // never had a fix — not "lost"
    return (gpsdo_ms() - s_lastGoodMs) >= GPSDO_LOST_MS;
}

bool gpsdo_is_ready(void)
{
    return s_gpsdoReady;
}

bool gpsdo_si5351_ok(void)
{
    return s_clk1Ok;
}

int gpsdo_format_status(char *buf, size_t size)
{
    const uint32_t now = gpsdo_ms();

    // sig: GPS time-discipline status
    //   "stable" – UTC received, GGA fresh, satellites tracked → 24 MHz disciplined
    //   "lost"   – had a fix, none for GPSDO_LOST_MS           → drifting on the GPS TCXO
    //   "stale"  – had UTC but no GGA for >60 s                → receiver silent
    //   "wait"   – no UTC ever received                        → cold start
    // NOTE: the NEO-7M keeps emitting GGA without a fix, so sentence arrival
    // alone does not mean the reference is disciplined — hence the "lost" case.
    const bool utc_valid  = (s_utc[0] != '-');
    const bool gga_recent = (s_lastGgaMs != 0u) && ((now - s_lastGgaMs) <= 60000u);
    const bool lost       = gpsdo_signal_lost();
    const char *sig = !utc_valid       ? "wait"
                    : !gga_recent      ? "stale"
                    : lost             ? "lost"
                    :                    "stable";

    // fix: position fix (needs ≥3 sats — consistent with Arduino "LCK" = sats≥3)
    //   "locked" – position fix active, locator valid
    //   "wait"   – no fix yet
    const char *fix = (s_fixQuality > 0 && s_satsUsed >= 3) ? "locked" : "wait";

    // Always use last known sats/vis — do NOT zero on stale (robustness against
    // brief interruptions, same approach as the reference Arduino sketch).
    const uint16_t vis = get_visible_sats();

    // Format UTC as HH:MM:SS (last known value, never zeroed)
    char utc_str[9];
    if (utc_valid) {
        snprintf(utc_str, sizeof(utc_str), "%c%c:%c%c:%c%c",
                 s_utc[0], s_utc[1], s_utc[2], s_utc[3], s_utc[4], s_utc[5]);
    } else {
        snprintf(utc_str, sizeof(utc_str), "--:--:--");
    }

    return snprintf(buf, size,
                    "GPSDO: sig=%s fix=%s sats=%d vis=%d clk1=%s"
                    " utc=%s loc=%s alt=%dm lost=%d\r\n",
                    sig, fix,
                    s_satsUsed,   // last known — not zeroed on stale
                    (int)vis,
                    si5351_clk_status(),
                    utc_str,
                    s_has_position ? s_locator : "------",
                    (int)s_alt_m,
                    lost ? 1 : 0);
}

void gpsdo_get_info(gpsdo_info_t *o)
{
    const bool utc_valid  = (s_utc[0] != '-');
    const bool date_valid = (s_date[0] != '-');
    if (utc_valid) snprintf(o->utc_hhmm, sizeof(o->utc_hhmm), "%c%c:%c%c", s_utc[0], s_utc[1], s_utc[2], s_utc[3]);
    else           snprintf(o->utc_hhmm, sizeof(o->utc_hhmm), "--:--");
    if (date_valid) snprintf(o->date, sizeof(o->date), "%c%c.%c%c.20%c%c",
                             s_date[0], s_date[1], s_date[2], s_date[3], s_date[4], s_date[5]);
    else            snprintf(o->date, sizeof(o->date), "--.--.----");
    snprintf(o->locator, sizeof(o->locator), "%s", s_has_position ? s_locator : "------");
    o->utc_valid   = utc_valid;
    o->fix         = (s_fixQuality > 0 && s_satsUsed >= 3);
    o->sats_used   = (uint8_t)(s_satsUsed < 0 ? 0 : (s_satsUsed > 255 ? 255 : s_satsUsed));
    o->sats_vis    = (uint8_t)(get_visible_sats() > 255u ? 255u : get_visible_sats());
    o->alt_m       = s_alt_m;
}

bool gpsdo_status_due(void)
{
    const uint32_t now = gpsdo_ms();
    if ((now - s_lastPrintMs) >= GPSDO_PRINT_MS) {
        s_lastPrintMs = now;
        return true;
    }
    return false;
}
