SimonRZz/SX1280_QO100_SSB_TX/gpsdo.h

// gpsdo.h — GPSDO integration header for SX1280_QO100_SSB_TX
//
// Provides GPS-disciplined 52 MHz reference via SI5351 clock generator
// locked to a u-blox NEO-7M GPS module.
//
// Hardware (all pins free in the SX1280 master design):
//   SI5351  → I2C0   GP0 = SDA, GP1 = SCL
//   NEO-7M  → UART1  GP4 = TX (→ GPS RX), GP5 = RX (← GPS TX)
//   SX1280 NRESET (GP20) is held LOW by main.c until gpsdo_is_ready().

#pragma once

#include <stdint.h>
#include <stdbool.h>
#include <stddef.h>

// Initialise I2C0, SI5351 (52 MHz on CLK1) and UART1 (GPS at 9600 baud).
// Sends UBX-CFG-TP5 and UBX-CFG-NAV5 to the NEO-7M.
// Returns immediately after hardware setup — call gpsdo_task() in a loop
// until gpsdo_is_ready().
void gpsdo_init(void);

// Service the GPS UART: drain incoming bytes, parse NMEA sentences,
// update internal state. Call this frequently (every few ms is fine).
void gpsdo_task(void);

// Returns true while the SI5351 CLK1 (52 MHz) is running and its PLL is
// locked to the GPS TIMEPULSE — i.e. the SX1280 has a usable clock.
// This is the condition for releasing the SX1280 reset.  It does NOT
// imply GPS discipline: without a satellite the NEO-7M free-runs at
// ±2.5 ppm (≈ ±6 kHz at 2.4 GHz).
bool gpsdo_clock_ok(void);

// Re-sends the whole SI5351 configuration. The boot gate uses this when PLL A
// has not locked after a few seconds instead of waiting indefinitely.
bool gpsdo_retry_clock(void);

// Returns true once gpsdo_clock_ok() AND the GPS has delivered a UTC
// timestamp, meaning the 24 MHz TIMEPULSE is satellite-disciplined.
// This is the condition for allowing transmission.
bool gpsdo_is_ready(void);

// True when a position fix existed earlier but has been gone for a while.
// gpsdo_is_ready() deliberately stays true in that case — the SX1280 keeps
// running on the now free-wheeling TIMEPULSE — so this is what the display
// uses to warn that the reference is drifting.
bool gpsdo_signal_lost(void);

// Returns true if the SI5351 was found and CLK1 is running.
// False means SI5351 is not connected or not responding.
bool gpsdo_si5351_ok(void);

// Fill buf with the machine-parseable status line:
//   "GPSDO: lock=<0|1> sats=<N> clk1=<ok|fail>\r\n"
// Returns the number of characters written (excluding the NUL terminator).
int gpsdo_format_status(char *buf, size_t size);

// Returns true once every GPSDO_PRINT_MS milliseconds (2 s default).
// Use this to rate-limit periodic status output.
bool gpsdo_status_due(void);

// Snapshot of the GPS fields for the display. Strings are placeholders
// ("--:--", "--.--.----", "------") while the value is unknown.
typedef struct {
    char    utc_hhmm[6];    // "HH:MM"
    char    date[11];       // "DD.MM.YYYY" (from RMC)
    char    locator[7];     // 6-char Maidenhead
    bool    utc_valid;
    bool    fix;            // position fix with >= 3 satellites
    uint8_t sats_used;
    uint8_t sats_vis;
    int16_t alt_m;
} gpsdo_info_t;
void gpsdo_get_info(gpsdo_info_t *out);

// ---------------------------------------------------------------------------
// Receive mixer local oscillator — SI5351 CLK0, 144 MHz
// ---------------------------------------------------------------------------
// The downconverter's LO is the 5th harmonic of this, 720 MHz, selected by a
// high-pass and amplified at the receiver.
//
// OFF after gpsdo_init(). Deliberately: init runs before the boot gate that
// waits for a locked 52 MHz, so a fault on the CLK0 line would otherwise stop
// the transmitter from starting. Enable it with gpsdo_set_lo_enabled(true) once
// the radio is up. CLK1 (52 MHz, the SX1280's only clock) is never affected.
bool gpsdo_set_lo_enabled(bool on);
bool gpsdo_lo_enabled(void);

// ---------------------------------------------------------------------------
// Si4732 reference clock — SI5351 CLK2, 25 MHz
// ---------------------------------------------------------------------------
// The Si4732 has no crystal: it runs off this clock on its RCLK pin, divided by
// 800 to 31250 Hz. Exact (864 MHz / 25), from PLL B, through a fractional
// MultiSynth, which the Si4732 does not mind — it is built for a 32.768 kHz
// watch crystal.
//
// OFF after gpsdo_init(), for the same reason as the mixer LO: nothing on the
// receive side may keep the transmitter from booting. The receiver cannot tune
// without it, so bring-up enables it before powering the Si4732 up.
bool gpsdo_set_rclk_enabled(bool on);
bool gpsdo_rclk_enabled(void);

// Drive strength of that output, 2/4/6/8 mA, changeable at runtime. The level
// the Si4732 actually needs on RCLK is not settled in this project; a chip that
// answers on I2C but reports "tune did not complete" and 0 kHz back is the
// symptom of too weak a reference.
bool    gpsdo_set_rclk_drive(uint8_t ma);
uint8_t gpsdo_rclk_drive(void);

// 25 or 36 MHz. 25 is the original and works, but it leaks into the Si4732's
// AM input at 65 dBuV — only five megahertz from a 19.5 MHz IF, close enough
// to pull the front-end AGC down across the whole band. 36 MHz comes off the
// same PLL B through an even integer divisor and sits sixteen megahertz away.
// Changes only MultiSynth 2; CLK1 (the SX1280's 52 MHz) is on PLL A and is
// never touched. The matching si4732_set_rclk_hz() must follow, or the
// receiver tunes to the wrong frequency.
bool    gpsdo_set_rclk_mhz(uint8_t mhz);
uint8_t gpsdo_rclk_mhz(void);
