SimonRZz/SX1280_QO100_SSB_TX/gui.py

#!/usr/bin/env python3
"""
SX1280 QO-100 SSB TX Control GUI
Original: SP8ESA  |  CW Keyer Tab: erweitert  |  v2.0.0 Status Sync
pip install pyserial pyaudio numpy
"""

import tkinter as tk
from tkinter import ttk, messagebox, filedialog
import threading
import time
import queue
import re
import ctypes
import ctypes.util
import sys
from dataclasses import dataclass
from typing import Optional

try:
    import serial
    import serial.tools.list_ports
    HAS_SERIAL = True
except ImportError:
    serial = None
    HAS_SERIAL = False

try:
    import pyaudio
    import numpy as np
    HAS_AUDIO = True
except ImportError:
    HAS_AUDIO = False


# ALSA-Fehlermeldungen unterdrücken
def _suppress_alsa_errors():
    try:
        lib = ctypes.util.find_library('asound')
        if not lib:
            return
        asound = ctypes.cdll.LoadLibrary(lib)
        _CB_TYPE = ctypes.CFUNCTYPE(
            None,
            ctypes.c_char_p,
            ctypes.c_int,
            ctypes.c_char_p,
            ctypes.c_int,
            ctypes.c_char_p,
        )
        sys.modules[__name__]._alsa_error_cb = _CB_TYPE(lambda *a: None)
        asound.snd_lib_error_set_handler(sys.modules[__name__]._alsa_error_cb)
    except Exception:
        pass

_suppress_alsa_errors()


MORSE_TABLE = {
    '.-':'A',    '-...':'B',  '-.-.':'C',  '-..':'D',
    '.':'E',     '..-.':'F',  '--.':'G',   '....':'H',
    '..':'I',    '.---':'J',  '-.-':'K',   '.-..':'L',
    '--':'M',    '-.':'N',    '---':'O',   '.--.':'P',
    '--.-':'Q',  '.-.':'R',   '...':'S',   '-':'T',
    '..-':'U',   '...-':'V',  '.--':'W',   '-..-':'X',
    '-.--':'Y',  '--..':'Z',
    '.----':'1', '..---':'2', '...--':'3', '....-':'4',
    '.....':'5', '-....':'6', '--...':'7', '---..':'8',
    '----.':'9', '-----':'0',
    '.-.-.-':'.', '--..--':',', '..--..':'?', '.----.': "'",
    '-..-.':'/',  '---...':':',  '-.--.':'(',  '-.--.-':')',
    '.-...':'&',  '-...-':'=',   '.-.-.':'+',  '-....-':'-',
    '.-..-.':'"', '.--.-.':'@',
}

# Inverse table: char → morse code string (for text-to-CW sending)
MORSE_CODE = {v: k for k, v in MORSE_TABLE.items()}
MORSE_CODE[' '] = ' '  # word space

READABLE_PINS = ['CTS', 'DSR', 'RI', 'CD']

QO100_LO_HZ = 8_089_500_100  # Measured QO-100 transponder LO offset, nominal 8089.5 MHz


@dataclass
class TxConfig:
    freq_hz: float = 2_400_400_000.0
    ppm: float = 0.0
    tx_power_dbm: int = 4
    tx_enabled: bool = True
    enable_bp: bool = True
    enable_eq: bool = True
    enable_comp: bool = True
    bp_lo_hz: float = 50.0
    bp_hi_hz: float = 2700.0
    bp_stages: int = 7
    eq_low_hz: float = 190.0
    eq_low_db: float = -2.0
    eq_high_hz: float = 1700.0
    eq_high_db: float = 13.5
    comp_thr_db: float = -2.5
    comp_ratio: float = 6.1
    comp_attack_ms: float = 41.1
    comp_release_ms: float = 1595.0
    comp_makeup_db: float = 0.0
    comp_knee_db: float = 16.5
    comp_out_limit: float = 0.940
    amp_gain: float = 2.9
    amp_min_a: float = 0.000002


class SerialWorker:
    def __init__(self, rx_queue: queue.Queue):
        self.rx_queue = rx_queue
        self.ser = None
        self.thread = None
        self.stop_evt = threading.Event()
        self.lock = threading.Lock()

    def is_connected(self):
        port, reader = self.ser, self.thread
        return (port is not None and port.is_open
                and reader is not None and reader.is_alive())

    def connect(self, port, baud=115200):
        if not HAS_SERIAL:
            raise RuntimeError("pyserial not installed")
        with self.lock:
            if self.is_connected():
                return
            self.ser = serial.Serial(port=port, baudrate=baud, timeout=0.1, write_timeout=0.5)
            # Each reader owns its port and stop event. Reconnecting must not
            # revive an old reader by clearing the event it was waiting on.
            self.stop_evt = threading.Event()
            self.thread = threading.Thread(target=self._rx_loop,
                                           args=(self.ser, self.stop_evt), daemon=True)
            self.thread.start()

    def disconnect(self):
        with self.lock:
            self.stop_evt.set()
            s = self.ser
            self.ser = None
            self.thread = None
        if s:
            try: s.close()
            except: pass

    def send_line(self, line):
        line = line.strip()
        if not line:
            return
        data = (line + "\r\n").encode("utf-8", errors="replace")
        with self.lock:
            if not self.is_connected():
                raise RuntimeError("Not connected")
            self.ser.write(data)
            self.ser.flush()

    def _rx_loop(self, port, stop_evt):
        buf = bytearray()
        try:
            while not stop_evt.is_set():
                chunk = port.read(256)
                with self.lock:
                    if self.ser is not port or self.stop_evt is not stop_evt:
                        break
                if chunk:
                    buf.extend(chunk)
                    while b"\n" in buf:
                        line, _, rest = buf.partition(b"\n")
                        buf = bytearray(rest)
                        txt = line.decode("utf-8", errors="replace").rstrip("\r")
                        with self.lock:
                            if self.ser is not port or self.stop_evt is not stop_evt:
                                return
                            self.rx_queue.put(txt)
                else:
                    time.sleep(0.01)
        except Exception as e:
            with self.lock:
                # A late error from an old reader must not disconnect a newer
                # port or mark its connection as failed.
                if self.ser is port and self.stop_evt is stop_evt:
                    self.ser = None
                    self.thread = None
                    stop_evt.set()
                    self.rx_queue.put(f"[SERIAL ERROR] {e}")
        finally:
            with self.lock:
                if self.ser is port and self.stop_evt is stop_evt:
                    self.ser = None
                    self.thread = None
                    stop_evt.set()
            try:
                port.close()
            except Exception:
                pass


class AudioEngine:
    def __init__(self):
        self.sample_rate = 44100
        self.tone_freq   = 700
        self.volume      = 0.5
        self._playing    = False
        self._lock       = threading.Lock()
        self._running    = False
        self._thread     = None
        self.pa          = None
        self.available   = False

        if not HAS_AUDIO:
            return
        try:
            self.pa = pyaudio.PyAudio()
            self._running = True
            self.available = True
            self._thread = threading.Thread(target=self._watchdog, daemon=True)
            self._thread.start()
        except Exception as e:
            print(f"Audio init: {e}")

    _CHUNK    = 256          # samples per buffer (≈5.8 ms @ 44100 Hz)
    _RAMP_MS  = 8            # attack/release ramp length in milliseconds

    def _open_stream(self):
        try:
            return self.pa.open(
                format=pyaudio.paInt16, channels=1,
                rate=self.sample_rate, output=True,
                frames_per_buffer=self._CHUNK)
        except Exception:
            # pa selbst neu initialisieren
            try: self.pa.terminate()
            except: pass
            try:
                self.pa = pyaudio.PyAudio()
                return self.pa.open(
                    format=pyaudio.paInt16, channels=1,
                    rate=self.sample_rate, output=True,
                    frames_per_buffer=self._CHUNK)
            except Exception:
                return None

    def _watchdog(self):
        while self._running:
            stream = self._open_stream()
            if stream is None:
                time.sleep(2.0)
                continue
            self._stream_loop(stream)
            if self._running:
                time.sleep(0.5)

    def _stream_loop(self, stream):
        chunk        = self._CHUNK
        ramp_samples = max(1, int(self.sample_rate * self._RAMP_MS / 1000))
        max_step     = chunk / ramp_samples   # max volume change per chunk
        current_vol  = 0.0
        phase        = 0
        try:
            while self._running:
                with self._lock:
                    target = self.volume if self._playing else 0.0
                    freq   = self.tone_freq
                # Linear ramp: spread the volume change evenly across the chunk
                # so there are no amplitude steps at chunk boundaries → no clicks.
                delta   = max(min(target - current_vol, max_step), -max_step)
                env     = np.linspace(current_vol, current_vol + delta,
                                      chunk, endpoint=False, dtype=np.float32)
                current_vol += delta
                t = (np.arange(chunk, dtype=np.float32) + phase) / self.sample_rate
                s = (np.sin(2 * np.pi * freq * t) * env * 32767).astype(np.int16)
                phase = (phase + chunk) % self.sample_rate
                try:
                    stream.write(s.tobytes(), exception_on_underflow=False)
                except Exception:
                    return
        except Exception:
            return
        finally:
            try: stream.stop_stream()
            except: pass
            try: stream.close()
            except: pass

    def on(self):
        with self._lock: self._playing = True

    def off(self):
        with self._lock: self._playing = False

    def set_freq(self, f):
        with self._lock: self.tone_freq = max(200, min(2000, int(f)))

    def set_vol(self, v):
        with self._lock: self.volume = max(0.0, min(1.0, float(v)))

    def close(self):
        self._running = False
        self._playing = False
        if self._thread and self._thread.is_alive():
            self._thread.join(timeout=2.0)
        if self.pa:
            try: self.pa.terminate()
            except: pass


class KeyReader:
    def __init__(self, port, baud, dit_pin, dah_pin, active_low):
        self.port       = port
        self.baud       = baud
        self.dit_pin    = dit_pin.upper()
        self.dah_pin    = dah_pin.upper() if dah_pin else None
        self.active_low = active_low
        self.ser        = None

    def connect(self):
        try:
            self.ser = serial.Serial(
                self.port, self.baud,
                timeout=0, dsrdtr=False, rtscts=False)
            self.ser.dtr = True
            self.ser.rts = True
            return True, ""
        except Exception as e:
            self.ser = None
            return False, str(e)

    def _pin(self, name):
        if not self.ser or name not in READABLE_PINS:
            return False
        try:
            raw = {'CTS': self.ser.cts, 'DSR': self.ser.dsr,
                   'RI':  self.ser.ri,  'CD':  self.ser.cd}[name]
            return (not raw) if self.active_low else raw
        except:
            return False

    def read(self):
        return self._pin(self.dit_pin), \
               (self._pin(self.dah_pin) if self.dah_pin else False)

    def disconnect(self):
        if self.ser:
            try: self.ser.close()
            except: pass
            self.ser = None


class Keyer:
    STRAIGHT = 0
    IAMBIC_A = 1
    IAMBIC_B = 2

    # Contact-bounce filter: input must be stable for this many ticks (2 ms each)
    # before a state change is accepted.  3 ticks = 6 ms covers typical paddle bounce.
    _DEBOUNCE_TICKS = 3

    def __init__(self):
        self.mode       = self.IAMBIC_A
        self.wpm        = 18
        self.weight     = 3.0
        self._update_timing()
        self._state     = 'IDLE'
        self._t0        = 0.0
        self._sym_buf   = ''
        self._pend_dit  = False
        self._pend_dah  = False
        self._was_dit   = False
        # Debounced paddle state (what _iambic sees)
        self._dit_stable = False
        self._dah_stable = False
        # How many consecutive ticks the raw input has differed from stable state
        self._dit_db_cnt = 0
        self._dah_db_cnt = 0
        self.cb_key_on  = None
        self.cb_key_off = None
        self.cb_char    = None
        self.cb_word_sp = None
        self._lock      = threading.Lock()

    def _update_timing(self):
        self.dit_ms = 1200.0 / self.wpm
        self.dah_ms = self.dit_ms * self.weight
        self.iel_ms = self.dit_ms
        self.ich_ms = self.dit_ms * 3.0
        self.iwd_ms = self.dit_ms * 7.0

    def set_wpm(self, w):
        self.wpm = max(5, min(60, int(w)))
        self._update_timing()

    def set_weight(self, w):
        self.weight = max(2.0, min(5.0, float(w)))
        self._update_timing()

    def set_mode(self, m):
        self.mode = m

    def tick(self, dit_in, dah_in):
        try:
            with self._lock:
                now = time.monotonic() * 1000.0

                # --- debounce dit ---
                if dit_in != self._dit_stable:
                    self._dit_db_cnt += 1
                    if self._dit_db_cnt >= self._DEBOUNCE_TICKS:
                        self._dit_stable = dit_in
                        self._dit_db_cnt = 0
                        if dit_in:          # rising edge on debounced signal
                            self._pend_dit = True
                else:
                    self._dit_db_cnt = 0

                # --- debounce dah ---
                if dah_in != self._dah_stable:
                    self._dah_db_cnt += 1
                    if self._dah_db_cnt >= self._DEBOUNCE_TICKS:
                        self._dah_stable = dah_in
                        self._dah_db_cnt = 0
                        if dah_in:          # rising edge on debounced signal
                            self._pend_dah = True
                else:
                    self._dah_db_cnt = 0

                if self.mode == self.STRAIGHT:
                    return self._straight(self._dit_stable, now)
                return self._iambic(self._dit_stable, self._dah_stable, now)
        except:
            return False

    def _straight(self, key, now):
        if key:
            if self._state == 'IDLE':
                self._state = 'DOWN'
                self._t0 = now
                self._sym_buf = ''
                if self.cb_key_on: self.cb_key_on()
            return True
        else:
            if self._state == 'DOWN':
                dur = now - self._t0
                self._state = 'IDLE'
                self._t0 = now
                if self.cb_key_off: self.cb_key_off()
                self._sym_buf += '.' if dur < self.dit_ms * 2.0 else '-'
            elif self._state == 'IDLE' and self._sym_buf:
                if now - self._t0 >= self.ich_ms:
                    ch = MORSE_TABLE.get(self._sym_buf, '?')
                    self._sym_buf = ''
                    if self.cb_char: self.cb_char(ch)
            return False

    def _iambic(self, dit, dah, now):
        # FIX A: removed level-triggered "if dit: self._pend_dit = True" lines.
        # Pending flags are now set exclusively by rising-edge detection in tick().
        el = now - self._t0

        if self._state == 'IDLE':
            if self._pend_dit and not self._pend_dah:
                self._send_dit(now); self._pend_dit = False
            elif self._pend_dah and not self._pend_dit:
                self._send_dah(now); self._pend_dah = False
            elif self._pend_dit and self._pend_dah:
                if self._was_dit:
                    self._send_dah(now); self._pend_dah = False
                else:
                    self._send_dit(now); self._pend_dit = False
            return False

        elif self._state == 'DIT':
            if el >= self.dit_ms:
                self._sym_buf += '.'
                self._was_dit = True
                if self.cb_key_off: self.cb_key_off()
                # Hold-to-repeat is decided at the end of the SPACE (see IEL),
                # not here: a normal tap outlasts one element at 20+ WPM and
                # sampling at element end produced double dits.
                if self.mode == self.IAMBIC_A:
                    # A: clear memory for any paddle released at element end
                    if not dit: self._pend_dit = False
                    if not dah: self._pend_dah = False
                self._state = 'IEL'; self._t0 = now
            elif self.mode == self.IAMBIC_B and dah:
                # Iambic B squeeze latch: opposite paddle held during element
                self._pend_dah = True
            return True

        elif self._state == 'DAH':
            if el >= self.dah_ms:
                self._sym_buf += '-'
                self._was_dit = False
                if self.cb_key_off: self.cb_key_off()
                if self.mode == self.IAMBIC_A:
                    if not dit: self._pend_dit = False
                    if not dah: self._pend_dah = False
                self._state = 'IEL'; self._t0 = now
            elif self.mode == self.IAMBIC_B and dit:
                # Iambic B squeeze latch (symmetric for dit side)
                self._pend_dit = True
            return True

        elif self._state == 'IEL':
            if el >= self.iel_ms:
                # Hold-to-repeat: whatever is still pressed at the end of the space
                if dit: self._pend_dit = True
                if dah: self._pend_dah = True
                have_dit = self._pend_dit
                have_dah = self._pend_dah
                if have_dit and have_dah:
                    # Squeeze: alternate based on what was last sent
                    if self._was_dit:
                        self._send_dah(now); self._pend_dah = False
                    else:
                        self._send_dit(now); self._pend_dit = False
                elif have_dah:
                    self._send_dah(now); self._pend_dah = False
                elif have_dit:
                    self._send_dit(now); self._pend_dit = False
                else:
                    self._state = 'ICH'; self._t0 = now
            return False

        elif self._state == 'ICH':
            if el >= self.ich_ms:
                # Complete character
                ch = MORSE_TABLE.get(self._sym_buf, '?')
                self._sym_buf = ''
                if self.cb_char: self.cb_char(ch)
                # FIX A: do NOT copy current key level into pending here.
                # Rising-edge detection in tick() already set _pend_* if user
                # pressed a key during ICH – no need to re-read the level.
                if self._pend_dit or self._pend_dah:
                    self._state = 'IDLE'; self._t0 = now
                else:
                    self._state = 'IWD'; self._t0 = now
            # FIX A: only check _pend_* (edge-based), not raw dit/dah level
            elif self._pend_dit or self._pend_dah:
                if self._pend_dah:
                    self._send_dah(now); self._pend_dah = False
                else:
                    self._send_dit(now); self._pend_dit = False
            return False

        elif self._state == 'IWD':
            if el >= self.iwd_ms - self.ich_ms:
                if self.cb_word_sp: self.cb_word_sp()
                self._state = 'IDLE'; self._t0 = now
            # FIX A: only check _pend_* (edge-based), not raw dit/dah level
            elif self._pend_dit or self._pend_dah:
                self._state = 'IDLE'; self._t0 = now
            return False

        return False

    def _send_dit(self, now):
        self._pend_dit = False   # clear BOTH latches at element start
        self._pend_dah = False   # mirrors uSDX KEYED_PREP: keyerControl &= ~(DIT_L|DAH_L)
        self._state = 'DIT'; self._t0 = now
        if self.cb_key_on: self.cb_key_on()

    def _send_dah(self, now):
        self._pend_dit = False   # clear BOTH latches at element start
        self._pend_dah = False   # mirrors uSDX KEYED_PREP: keyerControl &= ~(DIT_L|DAH_L)
        self._state = 'DAH'; self._t0 = now
        if self.cb_key_on: self.cb_key_on()

    def get_sym_buf(self):
        try:
            with self._lock: return self._sym_buf
        except:
            return ''

    def reset(self):
        try:
            with self._lock:
                self._state = 'IDLE'
                self._sym_buf = ''
                self._pend_dit = self._pend_dah = False
                self._dit_stable = self._dah_stable = False
                self._dit_db_cnt = self._dah_db_cnt = 0
                if self.cb_key_off: self.cb_key_off()
        except:
            pass


def list_serial_ports():
    if not HAS_SERIAL:
        return []
    ports = []
    for p in serial.tools.list_ports.comports():
        if "SX1280" in p.description or "cafe:4073" in str(p.hwid).lower():
            ports.insert(0, (p.device, f"★ {p.device} ({p.description})"))
        else:
            ports.append((p.device, f"{p.device} ({p.description})"))
    return ports


class Debouncer:
    def __init__(self, tk_root, delay_ms, fn):
        self.root = tk_root
        self.delay_ms = delay_ms
        self.fn = fn
        self._after_id = None
        self._last_args = None
        self._last_kwargs = None

    def call(self, *args, **kwargs):
        self._last_args = args
        self._last_kwargs = kwargs
        if self._after_id is not None:
            try: self.root.after_cancel(self._after_id)
            except: pass
        self._after_id = self.root.after(self.delay_ms, self._fire)

    def _fire(self):
        self._after_id = None
        if self._last_args is not None:
            self.fn(*self._last_args, **(self._last_kwargs or {}))


class LabeledScale(ttk.Frame):
    def __init__(self, parent, label, var, from_, to, resolution, on_change, format_str="{:.1f}"):
        super().__init__(parent)
        self.var = var
        self.resolution = resolution
        self.on_change = on_change
        self.format_str = format_str
        self.columnconfigure(1, weight=1)
        ttk.Label(self, text=label, width=16, anchor="w").grid(row=0, column=0, sticky="w")
        self.scale = ttk.Scale(self, from_=from_, to=to, orient=tk.HORIZONTAL,
                               variable=var, command=self._on_scale)
        self.scale.grid(row=0, column=1, sticky="ew", padx=(8, 8))
        self.value_label = ttk.Label(self, width=10, anchor="e")
        self.value_label.grid(row=0, column=2, sticky="e")
        self._update_value_label()
        self.scale.bind("<ButtonRelease-1>", self._on_release)
        # Auto-update label on programmatic .set() (e.g. from !S status push)
        var.trace_add("write", lambda *_: self._update_value_label())

    def _on_scale(self, _val):
        self._update_value_label()

    def _on_release(self, _event):
        v = float(self.var.get())
        v = round(v / self.resolution) * self.resolution
        self.var.set(v)
        self._update_value_label()
        self.on_change(v)

    def _update_value_label(self):
        v = float(self.var.get())
        text = self.format_str(v) if callable(self.format_str) else self.format_str.format(v)
        self.value_label.config(text=text)


class ScrollableFrame(ttk.Frame):
    """Frame with vertical scrollbar – used for the RF & DSP tab."""
    def __init__(self, parent, **kwargs):
        super().__init__(parent, **kwargs)
        self.canvas = tk.Canvas(self, highlightthickness=0, borderwidth=0)
        self.scrollbar = ttk.Scrollbar(self, orient="vertical", command=self.canvas.yview)
        self.inner = ttk.Frame(self.canvas)
        self.inner.bind("<Configure>",   self._on_inner_cfg)
        self.canvas.bind("<Configure>",  self._on_canvas_cfg)
        self._win = self.canvas.create_window((0, 0), window=self.inner, anchor="nw")
        self.canvas.configure(yscrollcommand=self.scrollbar.set)
        self.canvas.pack(side="left", fill="both", expand=True)
        self.scrollbar.pack(side="right", fill="y")
        self.canvas.bind("<Enter>", lambda _: self._bind_wheel())
        self.canvas.bind("<Leave>", lambda _: self._unbind_wheel())

    def _on_inner_cfg(self, _e):
        self.canvas.configure(scrollregion=self.canvas.bbox("all"))

    def _on_canvas_cfg(self, e):
        self.canvas.itemconfig(self._win, width=e.width)

    def _bind_wheel(self):
        self.canvas.bind_all("<Button-4>",   self._scroll)
        self.canvas.bind_all("<Button-5>",   self._scroll)
        self.canvas.bind_all("<MouseWheel>", self._scroll)

    def _unbind_wheel(self):
        for ev in ("<Button-4>", "<Button-5>", "<MouseWheel>"):
            self.canvas.unbind_all(ev)

    def _scroll(self, e):
        if   e.num == 4: self.canvas.yview_scroll(-3, "units")
        elif e.num == 5: self.canvas.yview_scroll( 3, "units")
        elif hasattr(e, 'delta'): self.canvas.yview_scroll(-1*(e.delta//120), "units")


class SX1280ControlApp(ttk.Frame):
    FREQ_MIN_HZ = 2_400_000_000
    FREQ_MAX_HZ = 2_400_500_000

    def __init__(self, master):
        super().__init__(master)
        self.master = master
        self.config  = TxConfig()
        self.rx_queue = queue.Queue()
        self.worker  = SerialWorker(self.rx_queue)
        self.debounced_send = Debouncer(master, 150, self._send_cmd_safe)
        self.freq_debouncer = Debouncer(master, 200, self._send_freq)

        self._status_updating = False  # guard against feedback loops during !S sync
        self._heartbeat_id   = None    # after() id for periodic status requests
        self._log_buf        = []      # (timestamp, tag, msg) — source of truth for the console
        self._cmd_history    = []
        self._cmd_hist_idx   = None

        self.audio       = AudioEngine()
        self.keyer       = Keyer()
        self.key_reader  = None
        self._cw_running      = False
        self._cw_thread       = None
        self._cw_text_thread  = None
        self._cw_stop_evt     = threading.Event()
        # FIX B: shared key state written only by _cw_loop (background thread),
        # read only by _cw_gui_update (GUI thread) – eliminates serial port race.
        self._cw_key_state = (False, False)
        self._cw_tx_active        = False  # True while firmware is in CW keyer mode
        self._cw_test_stop_pending = False  # True when test carrier stop triggered (not keyer stop)

        # Keyer callbacks: sidetone + firmware keying (key 1 / key 0)
        def _on_key_on():
            self.audio.on()
            if self._cw_tx_active:
                try: self.worker.send_line("key 1")
                except: pass
        def _on_key_off():
            self.audio.off()
            if self._cw_tx_active:
                try: self.worker.send_line("key 0")
                except: pass
        self.keyer.cb_key_on  = _on_key_on
        self.keyer.cb_key_off = _on_key_off

        self._create_variables()
        self._build_ui()
        self._update_freq_display()

        master.bind_all("<Button-4>",   self._on_global_scroll)
        master.bind_all("<Button-5>",   self._on_global_scroll)
        master.bind_all("<MouseWheel>", self._on_global_scroll)
        master.bind_all("<Escape>",     self._cw_on_esc)

        self._poll_rx()
        self._cw_gui_update()
        self.pack(fill="both", expand=True)

    def _create_variables(self):
        self.port_var    = tk.StringVar()
        self.status_var  = tk.StringVar(value="⚫ Disconnected")
        self.mode_var    = tk.StringVar(value="usb")
        self.tune_var    = tk.BooleanVar(value=False)
        self.freq_mhz_var  = tk.DoubleVar(value=self.config.freq_hz / 1_000_000)
        self.freq_khz_var  = tk.StringVar(value=f"{self.config.freq_hz / 1000:.1f}")
        _dl0 = self.config.freq_hz + QO100_LO_HZ
        self.dl_mhz_var    = tk.DoubleVar(value=_dl0 / 1_000_000)
        self.dl_khz_var    = tk.StringVar(value=f"{_dl0 / 1000:.1f}")
        self.ppm_var      = tk.DoubleVar(value=0.0)
        self.txpwr_var    = tk.IntVar(value=self.config.tx_power_dbm)
        self.tx_enabled_var          = tk.BooleanVar(value=True)
        self.scroll_tune_enabled_var = tk.BooleanVar(value=False)
        self.en_bp_var    = tk.BooleanVar(value=self.config.enable_bp)
        self.en_eq_var    = tk.BooleanVar(value=self.config.enable_eq)
        self.en_comp_var  = tk.BooleanVar(value=self.config.enable_comp)
        self.bp_lo_var    = tk.DoubleVar(value=self.config.bp_lo_hz)
        self.bp_hi_var    = tk.DoubleVar(value=self.config.bp_hi_hz)
        self.bp_stages_var = tk.IntVar(value=self.config.bp_stages)
        self.eq_low_hz_var  = tk.DoubleVar(value=self.config.eq_low_hz)
        self.eq_low_db_var  = tk.DoubleVar(value=self.config.eq_low_db)
        self.eq_high_hz_var = tk.DoubleVar(value=self.config.eq_high_hz)
        self.eq_high_db_var = tk.DoubleVar(value=self.config.eq_high_db)
        self.comp_thr_var    = tk.DoubleVar(value=self.config.comp_thr_db)
        self.comp_ratio_var  = tk.DoubleVar(value=self.config.comp_ratio)
        self.comp_att_var    = tk.DoubleVar(value=self.config.comp_attack_ms)
        self.comp_rel_var    = tk.DoubleVar(value=self.config.comp_release_ms)
        self.comp_makeup_var = tk.DoubleVar(value=self.config.comp_makeup_db)
        self.comp_knee_var   = tk.DoubleVar(value=self.config.comp_knee_db)
        self.comp_outlim_var = tk.DoubleVar(value=self.config.comp_out_limit)
        self.amp_gain_var    = tk.DoubleVar(value=self.config.amp_gain)
        self.amp_min_a_var   = tk.StringVar(value=f"{self.config.amp_min_a:.9f}")
        self.cw_port_var        = tk.StringVar()
        self.cw_baud_var        = tk.StringVar(value='9600')
        self.cw_mode_var        = tk.StringVar(value='Iambic B')
        self.cw_dit_var         = tk.StringVar(value='CTS')
        self.cw_dah_var         = tk.StringVar(value='CD')
        self.cw_active_low_var  = tk.BooleanVar(value=False)
        self.cw_wpm_var         = tk.DoubleVar(value=18)
        self.cw_tone_var        = tk.DoubleVar(value=700)
        self.cw_vol_var         = tk.DoubleVar(value=70)
        self.cw_conn_status_var = tk.StringVar(value='● DISCONNECTED')
        self.cw_text_var        = tk.StringVar(value='CQ CQ DE SX1280')
        self.cw_weight_var      = tk.DoubleVar(value=3.0)
        # GPSDO state
        self.gpsdo_sig_var  = tk.StringVar(value="--")
        self.gpsdo_fix_var  = tk.StringVar(value="--")
        self.gpsdo_sats_var = tk.StringVar(value="--")
        self.gpsdo_vis_var  = tk.StringVar(value="--")
        self.gpsdo_clk1_var = tk.StringVar(value="--")
        self.gpsdo_utc_var  = tk.StringVar(value="--:--:--")
        self.gpsdo_loc_var  = tk.StringVar(value="------")
        self.gpsdo_alt_var  = tk.StringVar(value="--")

        self.fw_version_var = tk.StringVar(value="")
        self.cfg_dirty_var  = tk.StringVar(value="")
        self.txgate_var     = tk.StringVar(value="")
        self.gps_gate_var   = tk.BooleanVar(value=True)
        self._gps_ready     = None   # None = unknown, else bool from !S gps=
        self._gps_gate      = None   # None = unknown, else bool from !S gate=
        self._gps_lost      = False  # from GPSDO lost= — had a fix, lost it

        # On-device keyer (firmware), synced from !S kwpm= / kmode=
        self.dev_kmode_var  = tk.StringVar(value="Iambic B")
        self.dev_kwpm_var   = tk.IntVar(value=18)
        self.dev_kratio_var = tk.DoubleVar(value=3.0)
        self.dev_key_var    = tk.StringVar(value="Paddle: —   Key: —")
        self.dev_sym_var    = tk.StringVar(value="")   # elements of the character being keyed
        self._dev_sym       = ""
        self.dev_sthz_var   = tk.IntVar(value=700)     # sidetone Hz (firmware, GP12)
        self.dev_stvol_var  = tk.IntVar(value=30)      # sidetone volume %
        self.dev_sttest_var = tk.BooleanVar(value=False)

        # Audio source (firmware): "pc" = USB audio, "mic" = MAX4466 on GP26
        self.audio_src_var  = tk.StringVar(value="pc")
        self.mic_gain_var   = tk.DoubleVar(value=10.0)
        self.mic_gate_var   = tk.DoubleVar(value=0.02)
        self.ptt_req_var    = tk.BooleanVar(value=True)
        self.ptt_state_var  = tk.StringVar(value="PTT —")

    def _build_ui(self):
        self.master.title("SX1280 QO-100 SSB TX Control")
        self.master.geometry("900x820")
        self.master.minsize(600, 500)
        self.columnconfigure(0, weight=1)
        self.rowconfigure(1, weight=1)
        self._build_connection_bar()
        self.notebook = ttk.Notebook(self)
        self.notebook.grid(row=1, column=0, sticky="nsew", padx=5, pady=5)
        self._build_dsp_tab()
        self._build_tx_tab()
        self._build_rx_tab()
        self._build_cw_tab()
        self._build_gpsdo_tab()
        self._build_console_tab()

    def _build_connection_bar(self):
        f = ttk.Frame(self)
        f.grid(row=0, column=0, sticky="ew", padx=5, pady=5)
        f.columnconfigure(1, weight=1)
        ttk.Label(f, text="Port:").grid(row=0, column=0, padx=(0, 5))
        ports = list_serial_ports()
        self.port_map = {label: dev for dev, label in ports}
        labels = list(self.port_map.keys()) or ["(no ports found)"]
        self.port_var.set(labels[0] if labels else "")
        self.port_combo = ttk.Combobox(f, textvariable=self.port_var,
                                        values=labels, state="readonly", width=45)
        self.port_combo.grid(row=0, column=1, sticky="ew", padx=5)
        bf = ttk.Frame(f)
        bf.grid(row=0, column=2)
        ttk.Button(bf, text="🔄", width=3, command=self._refresh_ports).pack(side="left", padx=2)
        ttk.Button(bf, text="Connect",    command=self._connect).pack(side="left", padx=2)
        ttk.Button(bf, text="Disconnect", command=self._disconnect).pack(side="left", padx=2)
        ttk.Label(f, textvariable=self.status_var).grid(row=0, column=3, padx=(10, 0))
        ttk.Label(f, textvariable=self.fw_version_var,
                  foreground="gray").grid(row=0, column=4, padx=(10, 0))
        ttk.Label(f, textvariable=self.cfg_dirty_var,
                  foreground="#cc6600").grid(row=0, column=5, padx=(10, 0))
        self.txgate_bar_lbl = ttk.Label(f, textvariable=self.txgate_var,
                                        font=("TkDefaultFont", 9, "bold"))
        self.txgate_bar_lbl.grid(row=1, column=0, columnspan=5, sticky="w", pady=(2, 0))

    def _build_dsp_tab(self):
        sc = ScrollableFrame(self.notebook)
        self.notebook.add(sc, text="RF & DSP")
        tab = sc.inner
        tab.columnconfigure(0, weight=1)

        rf = ttk.LabelFrame(tab, text="RF / Frequency", padding=10)
        rf.grid(row=0, column=0, sticky="ew", pady=(0, 10))
        rf.columnconfigure(1, weight=1)

        tbf = ttk.Frame(rf)
        tbf.grid(row=0, column=0, columnspan=3, sticky="ew", pady=(0, 10))
        # Mode (USB/CW) radio buttons
        ttk.Label(tbf, text="Mode:").pack(side="left", padx=(0, 4))
        ttk.Radiobutton(tbf, text="USB (SSB)", variable=self.mode_var,
                        value="usb", command=self._on_mode_change).pack(side="left", padx=3)
        ttk.Radiobutton(tbf, text="CW", variable=self.mode_var,
                        value="cw",  command=self._on_mode_change).pack(side="left", padx=3)
        ttk.Separator(tbf, orient="vertical").pack(side="left", fill="y", padx=12, pady=2)
        # TUNE carrier button
        self.tune_button = tk.Button(tbf, text="TUNE OFF", width=11,
                                      font=("TkDefaultFont", 10, "bold"),
                                      command=self._toggle_tune, relief="raised", bd=3,
                                      bg="#cccccc", fg="black")
        self.tune_button.pack(side="left", padx=5)
        ttk.Separator(tbf, orient="vertical").pack(side="left", fill="y", padx=12, pady=2)
        self.tx_button = tk.Button(tbf, text="TX OFF", width=12,
                                    font=("TkDefaultFont", 11, "bold"),
                                    command=self._toggle_tx, relief="raised", bd=3)
        self.tx_button.pack(side="left", padx=5)
        self._update_tx_button()
        ttk.Checkbutton(tbf, text="🖱️ Scroll Tune (50 Hz/step)",
                        variable=self.scroll_tune_enabled_var).pack(side="left", padx=20)

        ttk.Label(rf, text="Uplink:").grid(row=1, column=0, sticky="w")
        fsf = ttk.Frame(rf)
        fsf.grid(row=1, column=1, sticky="ew", padx=5)
        fsf.columnconfigure(0, weight=1)
        self.freq_scale = ttk.Scale(fsf, from_=self.FREQ_MIN_HZ/1e6, to=self.FREQ_MAX_HZ/1e6,
                                     orient=tk.HORIZONTAL, variable=self.freq_mhz_var,
                                     command=self._on_freq_slider)
        self.freq_scale.grid(row=0, column=0, sticky="ew")
        fef = ttk.Frame(rf)
        fef.grid(row=1, column=2)
        self.freq_entry = ttk.Entry(fef, textvariable=self.freq_khz_var, width=14)
        self.freq_entry.pack(side="left")
        self.freq_entry.bind("<Return>", lambda e: self._send_freq_from_entry())
        ttk.Label(fef, text=" kHz").pack(side="left")

        ttk.Label(rf, text="Downlink:").grid(row=2, column=0, sticky="w")
        dlf = ttk.Frame(rf)
        dlf.grid(row=2, column=1, sticky="ew", padx=5)
        dlf.columnconfigure(0, weight=1)
        self.dl_scale = ttk.Scale(dlf,
                                   from_=(self.FREQ_MIN_HZ + QO100_LO_HZ) / 1e6,
                                   to=(self.FREQ_MAX_HZ + QO100_LO_HZ) / 1e6,
                                   orient=tk.HORIZONTAL, variable=self.dl_mhz_var,
                                   command=self._on_dl_slider)
        self.dl_scale.grid(row=0, column=0, sticky="ew")
        dlef = ttk.Frame(rf)
        dlef.grid(row=2, column=2)
        self.dl_entry = ttk.Entry(dlef, textvariable=self.dl_khz_var, width=14)
        self.dl_entry.pack(side="left")
        self.dl_entry.bind("<Return>", lambda e: self._send_dl_from_entry())
        ttk.Label(dlef, text=" kHz").pack(side="left")

        fdf = ttk.Frame(rf)
        fdf.grid(row=3, column=1, columnspan=2, sticky="w", padx=5)
        self.freq_mhz_label = ttk.Label(fdf, text="2400.4000 MHz ↑",
                                         font=("TkDefaultFont", 12, "bold"))
        self.freq_mhz_label.pack(side="left")
        ttk.Label(fdf, text="   →   ").pack(side="left")
        self.downlink_label = ttk.Label(fdf, text="10489.9000 MHz ↓",
                                         font=("TkDefaultFont", 12, "bold"), foreground="blue")
        self.downlink_label.pack(side="left")

        ttk.Label(rf, text="PPM:").grid(row=4, column=0, sticky="w", pady=(10, 0))
        pf = ttk.Frame(rf)
        pf.grid(row=4, column=1, columnspan=2, sticky="ew", padx=5, pady=(10, 0))
        pf.columnconfigure(0, weight=1)
        ttk.Scale(pf, from_=-2.0, to=2.0, orient=tk.HORIZONTAL,
                  variable=self.ppm_var, command=self._on_ppm_slider).grid(row=0, column=0, sticky="ew")
        self.ppm_label = ttk.Label(pf, text="0.000 ppm", width=12)
        self.ppm_label.grid(row=0, column=1, padx=5)

        ttk.Label(rf, text="TX Power:").grid(row=5, column=0, sticky="w", pady=(10, 0))
        tpf = ttk.Frame(rf)
        tpf.grid(row=5, column=1, sticky="ew", padx=5, pady=(10, 0))
        tpf.columnconfigure(0, weight=1)
        LabeledScale(tpf, "", self.txpwr_var, -18, 13, 1,
                     lambda v: self._send_cmd_safe(f"txpwr {int(v)}"),
                     lambda v: f"{int(v)} dBm").pack(fill="x")

        ef = ttk.LabelFrame(tab, text="DSP Modules", padding=10)
        ef.grid(row=1, column=0, sticky="ew", pady=(0, 10))
        ttk.Checkbutton(ef, text="Bandpass Filter", variable=self.en_bp_var,
                        command=lambda: self._send_enable("bp",   self.en_bp_var.get())).pack(side="left", padx=20)
        ttk.Checkbutton(ef, text="Equalizer",       variable=self.en_eq_var,
                        command=lambda: self._send_enable("eq",   self.en_eq_var.get())).pack(side="left", padx=20)
        ttk.Checkbutton(ef, text="Compressor",      variable=self.en_comp_var,
                        command=lambda: self._send_enable("comp", self.en_comp_var.get())).pack(side="left", padx=20)

        bpf = ttk.LabelFrame(tab, text="Bandpass Filter", padding=10)
        bpf.grid(row=2, column=0, sticky="ew", pady=(0, 10))
        bpf.columnconfigure(0, weight=1)
        LabeledScale(bpf, "Low cutoff (Hz)",    self.bp_lo_var,     50, 1500, 10,
                     lambda v: self.debounced_send.call(f"set bp_lo {v:.0f}"), "{:.0f}").pack(fill="x")
        LabeledScale(bpf, "High cutoff (Hz)",   self.bp_hi_var,    500, 3600, 10,
                     lambda v: self.debounced_send.call(f"set bp_hi {v:.0f}"), "{:.0f}").pack(fill="x")
        LabeledScale(bpf, "Steepness (stages)", self.bp_stages_var,  1,   10,  1,
                     lambda v: self.debounced_send.call(f"set bp_stages {int(v)}"),
                     lambda v: f"{int(v)} ({int(v)*12} dB/oct)").pack(fill="x")

        eqf = ttk.LabelFrame(tab, text="Equalizer (Shelving)", padding=10)
        eqf.grid(row=3, column=0, sticky="ew", pady=(0, 10))
        eqf.columnconfigure(0, weight=1)
        LabeledScale(eqf, "Low shelf freq (Hz)",  self.eq_low_hz_var,   50, 1000, 10,
                     lambda v: self.debounced_send.call(f"set eq_low_hz {v:.0f}"),  "{:.0f}").pack(fill="x")
        LabeledScale(eqf, "Low shelf gain (dB)",  self.eq_low_db_var,  -24,   24, 0.5,
                     lambda v: self.debounced_send.call(f"set eq_low_db {v:.1f}"),  "{:.1f}").pack(fill="x")
        LabeledScale(eqf, "High shelf freq (Hz)", self.eq_high_hz_var, 500, 3500,  10,
                     lambda v: self.debounced_send.call(f"set eq_high_hz {v:.0f}"), "{:.0f}").pack(fill="x")
        LabeledScale(eqf, "High shelf gain (dB)", self.eq_high_db_var, -24,   24, 0.5,
                     lambda v: self.debounced_send.call(f"set eq_high_db {v:.1f}"), "{:.1f}").pack(fill="x")

        cf = ttk.LabelFrame(tab, text="Compressor", padding=10)
        cf.grid(row=4, column=0, sticky="ew", pady=(0, 10))
        cf.columnconfigure(0, weight=1)
        LabeledScale(cf, "Threshold (dB)",   self.comp_thr_var,   -60,    0, 0.5,
                     lambda v: self.debounced_send.call(f"set comp_thr {v:.1f}"),    "{:.1f}").pack(fill="x")
        LabeledScale(cf, "Ratio",            self.comp_ratio_var,   1,   20, 0.1,
                     lambda v: self.debounced_send.call(f"set comp_ratio {v:.1f}"),  "{:.1f}:1").pack(fill="x")
        LabeledScale(cf, "Attack (ms)",      self.comp_att_var,   0.1,  200, 0.1,
                     lambda v: self.debounced_send.call(f"set comp_att {v:.1f}"),    "{:.1f}").pack(fill="x")
        LabeledScale(cf, "Release (ms)",     self.comp_rel_var,    10, 2000,   1,
                     lambda v: self.debounced_send.call(f"set comp_rel {v:.0f}"),    "{:.0f}").pack(fill="x")
        LabeledScale(cf, "Makeup gain (dB)", self.comp_makeup_var,  0,   40, 0.5,
                     lambda v: self.debounced_send.call(f"set comp_makeup {v:.1f}"), "{:.1f}").pack(fill="x")
        LabeledScale(cf, "Knee (dB)",        self.comp_knee_var,    0,   24, 0.5,
                     lambda v: self.debounced_send.call(f"set comp_knee {v:.1f}"),   "{:.1f}").pack(fill="x")
        LabeledScale(cf, "Output limit",     self.comp_outlim_var, 0.01, 0.999, 0.001,
                     lambda v: self.debounced_send.call(f"set comp_outlim {v:.3f}"), "{:.3f}").pack(fill="x")

        pwf = ttk.LabelFrame(tab, text="Power Shaping", padding=10)
        pwf.grid(row=5, column=0, sticky="ew", pady=(0, 10))
        pwf.columnconfigure(0, weight=1)
        LabeledScale(pwf, "Amp gain", self.amp_gain_var, 0.01, 5.0, 0.01,
                     lambda v: self.debounced_send.call(f"set amp_gain {v:.3f}"),
                     "{:.3f}").pack(fill="x")
        amf = ttk.Frame(pwf)
        amf.pack(fill="x", pady=(5, 0))
        ttk.Label(amf, text="Amp min A:", width=16).pack(side="left")
        ttk.Entry(amf, textvariable=self.amp_min_a_var, width=16).pack(side="left", padx=5)
        ttk.Button(amf, text="Set",
                   command=lambda: self._send_cmd_safe(f"set amp_min_a {self.amp_min_a_var.get()}")
                   ).pack(side="left")

    def _build_tx_tab(self):
        tab = ttk.Frame(self.notebook, padding=10)
        self.notebook.add(tab, text="TX Control")
        tab.columnconfigure(0, weight=1)

        # --- Audio source ---
        asf = ttk.LabelFrame(tab, text="Audio source", padding=10)
        asf.grid(row=0, column=0, sticky="ew", pady=(0, 10))
        asf.columnconfigure(2, weight=1)
        ttk.Radiobutton(asf, text="PC (USB audio)", variable=self.audio_src_var, value="pc",
                        command=self._on_audio_src).grid(row=0, column=0, sticky="w")
        ttk.Radiobutton(asf, text="Microphone (MAX4466 at Pico GP26)", variable=self.audio_src_var,
                        value="mic", command=self._on_audio_src).grid(row=0, column=1, sticky="w", padx=(16, 0))
        ttk.Label(asf, text="Mic gain:").grid(row=1, column=0, sticky="w", pady=(6, 0))
        ttk.Scale(asf, from_=1, to=50, orient="horizontal", variable=self.mic_gain_var,
                  command=lambda v: self._on_mic_param("gain")).grid(row=1, column=1, columnspan=2,
                                                                       sticky="ew", padx=6, pady=(6, 0))
        self.mic_gain_lbl = ttk.Label(asf, text="10.0×", width=7)
        self.mic_gain_lbl.grid(row=1, column=3, sticky="w", pady=(6, 0))
        ttk.Label(asf, text="Noise gate:").grid(row=2, column=0, sticky="w", pady=(2, 0))
        ttk.Scale(asf, from_=0.0, to=0.5, orient="horizontal", variable=self.mic_gate_var,
                  command=lambda v: self._on_mic_param("gate")).grid(row=2, column=1, columnspan=2,
                                                                       sticky="ew", padx=6, pady=(2, 0))
        self.mic_gate_lbl = ttk.Label(asf, text="0.020", width=7)
        self.mic_gate_lbl.grid(row=2, column=3, sticky="w", pady=(2, 0))

        # PTT — the CW paddle doubles as the push-to-talk in SSB
        ttk.Checkbutton(asf, text="Require PTT (CW paddle, either side) for microphone transmission",
                        variable=self.ptt_req_var,
                        command=self._on_ptt_req).grid(row=3, column=0, columnspan=3,
                                                       sticky="w", pady=(8, 0))
        self.ptt_state_lbl = ttk.Label(asf, textvariable=self.ptt_state_var,
                                       font=("Consolas", 10, "bold"))
        self.ptt_state_lbl.grid(row=3, column=3, sticky="w", pady=(8, 0))

        # Live level meter — the only practical way to set the gain while talking
        ttk.Label(asf, text="Level:").grid(row=4, column=0, sticky="w", pady=(8, 0))
        self.mic_meter = tk.Canvas(asf, width=320, height=18, highlightthickness=1,
                                   highlightbackground="#999999", bg="#f0f0f0")
        self.mic_meter.grid(row=4, column=1, columnspan=2, sticky="w", padx=6, pady=(8, 0))
        self.mic_meter_lbl = ttk.Label(asf, text="—", width=14, font=("Consolas", 9))
        self.mic_meter_lbl.grid(row=4, column=3, sticky="w", pady=(8, 0))
        self._mic_peak_hold = 0.0
        self._mic_peak_age = 0

        ttk.Label(asf, text="Without a microphone wired to GP26 keep PC selected — an open ADC input is noise. "
                            "The OLED MODE item cycles USB PC → USB MIC → CW. SSB has no PTT of its own: "
                            "with the microphone selected and this unchecked, any room noise transmits.",
                  foreground="gray", wraplength=760, justify="left").grid(row=5, column=0, columnspan=4,
                                                                           sticky="w", pady=(6, 0))

        cwf = ttk.LabelFrame(tab, text="CW Test Mode", padding=20)
        cwf.grid(row=1, column=0, sticky="ew", pady=(0, 10))
        ttk.Label(cwf, text="Transmit continuous carrier for testing:").pack(anchor="w")
        bf = ttk.Frame(cwf)
        bf.pack(pady=10)
        ttk.Button(bf, text="▶ Start CW", command=self._start_cw, width=15).pack(side="left", padx=10)
        ttk.Button(bf, text="⏹ Stop",     command=self._stop_cw,  width=15).pack(side="left", padx=10)

        qf = ttk.LabelFrame(tab, text="Quick Commands", padding=20)
        qf.grid(row=2, column=0, sticky="ew", pady=(0, 10))
        qb = ttk.Frame(qf)
        qb.pack()
        ttk.Button(qb, text="GET Config", command=lambda: self._send_cmd_safe("get"),  width=15).pack(side="left", padx=5)
        ttk.Button(qb, text="DIAG",       command=lambda: self._send_cmd_safe("diag"), width=15).pack(side="left", padx=5)
        ttk.Button(qb, text="HELP",       command=lambda: self._send_cmd_safe("help"), width=15).pack(side="left", padx=5)

        mf = ttk.LabelFrame(tab, text="Manual Command", padding=10)
        mf.grid(row=3, column=0, sticky="ew", pady=(0, 10))
        mf.columnconfigure(0, weight=1)
        self.manual_cmd_var = tk.StringVar()
        ce = ttk.Entry(mf, textvariable=self.manual_cmd_var)
        ce.grid(row=0, column=0, sticky="ew", padx=(0, 5))
        ce.bind("<Return>", lambda e: self._send_manual_cmd())
        ttk.Button(mf, text="Send", command=self._send_manual_cmd).grid(row=0, column=1)

        inf = ttk.LabelFrame(tab, text="Device Info", padding=10)
        inf.grid(row=4, column=0, sticky="nsew", pady=(0, 10))
        tab.rowconfigure(4, weight=1)
        self.info_text = tk.Text(inf, height=10, wrap="word", state="disabled",
                                  bg="#f5f5f5", font=("Consolas", 10))
        self.info_text.pack(fill="both", expand=True)

    def _build_cw_tab(self):
        tab = ttk.Frame(self.notebook, padding=10)
        self.notebook.add(tab, text="⚡ CW Keyer")
        tab.columnconfigure(0, weight=1)
        tab.columnconfigure(1, weight=1)
        tab.rowconfigure(3, weight=1)

        pf = ttk.LabelFrame(tab, text="FTDI Adapter", padding=10)
        pf.grid(row=0, column=0, sticky="ew", padx=(0, 5), pady=(0, 8))
        pf.columnconfigure(1, weight=1)
        ttk.Label(pf, text="Port:").grid(row=0, column=0, sticky="w")
        all_ports = [p.device for p in serial.tools.list_ports.comports()] if HAS_SERIAL else []
        self.cw_port_combo = ttk.Combobox(pf, textvariable=self.cw_port_var,
                                           values=all_ports, width=18)
        if all_ports:
            self.cw_port_var.set(all_ports[0])
        self.cw_port_combo.grid(row=0, column=1, padx=4)
        ttk.Button(pf, text="↻", width=3, command=self._cw_refresh_ports).grid(row=0, column=2)
        ttk.Label(pf, text="Baud rate:").grid(row=1, column=0, sticky="w", pady=3)
        self.cw_baud_combo = ttk.Combobox(pf, textvariable=self.cw_baud_var, width=18,
                                           values=['1200','2400','4800','9600','19200','38400','115200'])
        self.cw_baud_combo.grid(row=1, column=1, padx=4)

        mf = ttk.LabelFrame(tab, text="Mode & Pins", padding=10)
        mf.grid(row=1, column=0, sticky="ew", padx=(0, 5), pady=(0, 8))
        ttk.Label(mf, text="Mode:").grid(row=0, column=0, sticky="w")
        self.cw_mode_combo = ttk.Combobox(mf, textvariable=self.cw_mode_var, width=14,
                                           values=['Straight', 'Iambic A', 'Iambic B'])
        self.cw_mode_combo.grid(row=0, column=1, columnspan=2, padx=4, pady=2)
        self.cw_mode_combo.bind('<<ComboboxSelected>>', self._cw_mode_changed)
        ttk.Label(mf, text="Dit / Key:").grid(row=1, column=0, sticky="w")
        self.cw_dit_combo = ttk.Combobox(mf, textvariable=self.cw_dit_var,
                                          width=7, values=READABLE_PINS)
        self.cw_dit_combo.grid(row=1, column=1, padx=4, pady=2)
        self._cw_dah_lbl = ttk.Label(mf, text="Dah:")
        self._cw_dah_lbl.grid(row=2, column=0, sticky="w")
        self._cw_dah_cb = ttk.Combobox(mf, textvariable=self.cw_dah_var,
                                        width=7, values=READABLE_PINS)
        self._cw_dah_cb.grid(row=2, column=1, padx=4, pady=2)
        self.cw_active_low_cb = ttk.Checkbutton(mf, text="Active Low (key→GND)",
                                                  variable=self.cw_active_low_var)
        self.cw_active_low_cb.grid(row=3, column=0, columnspan=3, sticky="w", pady=2)

        self.cw_conn_btn = ttk.Button(tab, text="▶  CONNECT", command=self._cw_toggle)
        self.cw_conn_btn.grid(row=2, column=0, sticky="ew", padx=(0, 5), pady=(0, 8))

        cpf = ttk.LabelFrame(tab, text="CW Parameters", padding=10)
        cpf.grid(row=0, column=1, rowspan=3, sticky="nsew", pady=(0, 8))
        cpf.columnconfigure(0, weight=1)

        def cw_slider(label, var, from_, to, fmt, cb):
            r = ttk.Frame(cpf)
            r.pack(fill='x', pady=2)
            ttk.Label(r, text=label, width=16, anchor='w').pack(side='left')
            lbl = ttk.Label(r, text=fmt(var.get()), width=10, anchor='e')
            lbl.pack(side='right')
            def _cb(v):
                lbl.config(text=fmt(float(v)))
                cb(float(v))
            ttk.Scale(cpf, from_=from_, to=to, orient='horizontal',
                      variable=var, command=_cb).pack(fill='x')

        cw_slider("Speed (WPM)",   self.cw_wpm_var,    5,   60,
                  lambda v: f"{int(v)} WPM", lambda v: self.keyer.set_wpm(v))
        cw_slider("Weight (Dah)",  self.cw_weight_var, 2.0, 5.0,
                  lambda v: f"{v:.2f}×", lambda v: self.keyer.set_weight(v))
        cw_slider("Sidetone (Hz)", self.cw_tone_var,  400, 1000,
                  lambda v: f"{int(v)} Hz",  lambda v: self.audio.set_freq(v))
        cw_slider("Volume",        self.cw_vol_var,    0,  100,
                  lambda v: f"{int(v)} %",   lambda v: self.audio.set_vol(v / 100))

        if not HAS_AUDIO:
            ttk.Label(cpf, text="pyaudio missing\npip install pyaudio numpy",
                      foreground="red").pack(pady=5)

        # === Send Text as CW ===
        tf = ttk.LabelFrame(tab, text="Send Text as CW", padding=8)
        tf.grid(row=3, column=1, sticky="nsew", pady=(0, 8))
        tf.columnconfigure(0, weight=1)
        self.cw_text_entry = ttk.Entry(tf, textvariable=self.cw_text_var,
                                       font=("TkDefaultFont", 13))
        self.cw_text_entry.grid(row=0, column=0, sticky="ew", ipady=6)
        self.cw_text_entry.bind("<Return>", lambda _: self._start_cw_text())
        tbf2 = ttk.Frame(tf)
        tbf2.grid(row=1, column=0, sticky="ew", pady=(6, 0))
        self.cw_text_btn = ttk.Button(tbf2, text="▶ Send", command=self._start_cw_text, width=10)
        self.cw_text_btn.pack(side="left", padx=(0, 4))
        ttk.Button(tbf2, text="⛔ Stop", command=self._abort_cw_text, width=8).pack(side="left")

        sf = ttk.LabelFrame(tab, text="Status", padding=8)
        sf.grid(row=3, column=0, sticky="nsew", padx=(0, 5), pady=(0, 8))
        self.cw_conn_lbl = ttk.Label(sf, textvariable=self.cw_conn_status_var,
                                      font=("TkDefaultFont", 11, "bold"), foreground="red")
        self.cw_conn_lbl.pack()
        self.cw_key_lbl = ttk.Label(sf, text="KEY: OPEN",
                                     font=("Consolas", 10), foreground="gray")
        self.cw_key_lbl.pack(pady=2)
        self.cw_sym_lbl = ttk.Label(sf, text="",
                                     font=("Consolas", 20, "bold"), foreground="#cc8800")
        self.cw_sym_lbl.pack(pady=4)
        self.cw_tx_btn = ttk.Button(sf, text="⬛  TX OFF",
                                    command=self._cw_toggle_tx)
        self.cw_tx_btn.pack(fill='x', pady=(4, 0))

        ttk.Label(tab, text="ESC = Abort  |  Pin → Key → GND  |  Active Low",
                  foreground="gray").grid(row=4, column=0, columnspan=2, pady=2)

        # --- On-device keyer (paddles wired to the Pico) ---
        df = ttk.LabelFrame(tab, text="On-device keyer (paddles at Pico GP9 dit / GP11 dah)", padding=10)
        df.grid(row=4, column=0, columnspan=2, sticky="ew", pady=(8, 0))
        ttk.Label(df, text="Mode:").grid(row=0, column=0, sticky="w")
        cb = ttk.Combobox(df, textvariable=self.dev_kmode_var, width=10, state="readonly",
                          values=self._DEV_KMODES)
        cb.grid(row=0, column=1, padx=4)
        cb.bind("<<ComboboxSelected>>", lambda e: self._dev_keyer_send("mode"))
        ttk.Label(df, text="WPM:").grid(row=0, column=2, sticky="e", padx=(12, 0))
        sp = ttk.Spinbox(df, from_=5, to=60, width=5, textvariable=self.dev_kwpm_var,
                         command=lambda: self._dev_keyer_send("wpm"))
        sp.grid(row=0, column=3, padx=4)
        sp.bind("<Return>", lambda e: self._dev_keyer_send("wpm"))
        ttk.Label(df, text="Dah ratio:").grid(row=0, column=4, sticky="e", padx=(12, 0))
        sr = ttk.Spinbox(df, from_=2.0, to=5.0, increment=0.1, width=5, format="%.1f",
                         textvariable=self.dev_kratio_var,
                         command=lambda: self._dev_keyer_send("ratio"))
        sr.grid(row=0, column=5, padx=4)
        sr.bind("<Return>", lambda e: self._dev_keyer_send("ratio"))
        df.columnconfigure(6, weight=1)

        # Sidetone (PWM on GP12 → headphones)
        ttk.Label(df, text="Sidetone:").grid(row=1, column=0, sticky="w", pady=(6, 0))
        sh = ttk.Spinbox(df, from_=300, to=1200, increment=10, width=5, textvariable=self.dev_sthz_var,
                         command=lambda: self._dev_keyer_send("tone"))
        sh.grid(row=1, column=1, padx=4, pady=(6, 0))
        sh.bind("<Return>", lambda e: self._dev_keyer_send("tone"))
        ttk.Label(df, text="Volume:").grid(row=1, column=2, sticky="e", padx=(12, 0), pady=(6, 0))
        ttk.Scale(df, from_=0, to=100, orient="horizontal", variable=self.dev_stvol_var,
                  command=lambda v: self._dev_keyer_send("vol")).grid(row=1, column=3, columnspan=2,
                                                                      sticky="ew", padx=4, pady=(6, 0))
        self.dev_stvol_lbl = ttk.Label(df, text="30 %", width=5)
        self.dev_stvol_lbl.grid(row=1, column=5, sticky="w", pady=(6, 0))
        ttk.Checkbutton(df, text="Test tone", variable=self.dev_sttest_var,
                        command=lambda: self._dev_keyer_send("test")).grid(row=1, column=6, sticky="w",
                                                                           padx=(12, 0), pady=(6, 0))

        # Live view: paddle contacts, key output, elements of the current character
        self.dev_key_lbl = ttk.Label(df, textvariable=self.dev_key_var, font=("Consolas", 10, "bold"))
        self.dev_key_lbl.grid(row=2, column=0, columnspan=4, sticky="w", pady=(8, 0))
        ttk.Label(df, textvariable=self.dev_sym_var, font=("Consolas", 20, "bold"),
                  foreground="#cc8800", width=8, anchor="w").grid(row=2, column=4, columnspan=3,
                                                                  sticky="w", pady=(2, 0))

        # Decoded text — the firmware's reading of what was keyed at the jack
        dtf = ttk.Frame(df)
        dtf.grid(row=3, column=0, columnspan=7, sticky="ew", pady=(6, 0))
        dtf.columnconfigure(0, weight=1)
        self.dev_decoded = tk.Text(dtf, height=3, wrap="word", font=("Consolas", 12),
                                   state="disabled", bg="#f7f7f7")
        self.dev_decoded.grid(row=0, column=0, sticky="ew")
        ttk.Button(dtf, text="Clear", width=6,
                   command=self._dev_decoded_clear).grid(row=0, column=1, sticky="n", padx=(6, 0))

        ttk.Label(df, text="Runs in firmware — keys the transmitter without this PC. "
                           "WPM is also on the OLED menu. Settings are saved to flash. "
                           "Decoded text uses the WPM above, so wrong letters mean the timing is off.",
                  foreground="gray", wraplength=760, justify="left").grid(row=4, column=0, columnspan=7,
                                                                           sticky="w", pady=(4, 0))

    def _on_audio_src(self):
        if self._status_updating:
            return
        self._send_cmd_safe(f"src {self.audio_src_var.get()}")

    _MIC_METER_W = 320

    def _handle_mic_level(self, line):
        """!M pk=<0..1000> env=<0..1000> thr=<0..1000> gate=<0|1>"""
        kv = {}
        for p in line[3:].split():
            if "=" in p:
                k, v = p.split("=", 1)
                kv[k] = v
        try:
            pk   = int(kv.get("pk", 0)) / 1000.0
            env  = int(kv.get("env", 0)) / 1000.0
            thr  = int(kv.get("thr", 0)) / 1000.0
            gate = kv.get("gate") == "1"
        except ValueError:
            return

        # Peak hold decays after about a second so a short syllable stays readable
        if pk >= self._mic_peak_hold:
            self._mic_peak_hold = pk
            self._mic_peak_age = 0
        else:
            self._mic_peak_age += 1
            if self._mic_peak_age > 10:
                self._mic_peak_hold = max(pk, self._mic_peak_hold - 0.05)

        w, h = self._MIC_METER_W, 18
        c = self.mic_meter
        c.delete("all")
        # bar: green while clean, orange approaching full scale, red at clipping
        lvl = min(pk, 1.0)
        colour = "#cc0000" if lvl >= 0.99 else "#cc8800" if lvl > 0.8 else "#2e8b2e"
        if lvl > 0:
            c.create_rectangle(0, 0, int(w * lvl), h, fill=colour, outline="")
        # gate threshold: below this nothing is transmitted
        tx = int(w * min(thr, 1.0))
        c.create_line(tx, 0, tx, h, fill="#0066cc", width=2)
        # peak hold
        px = int(w * min(self._mic_peak_hold, 1.0))
        if px > 1:
            c.create_line(px, 0, px, h, fill="#333333", width=2)

        self.mic_meter_lbl.config(
            text=f"{lvl*100:3.0f}%  {'OPEN' if gate else 'shut'}",
            foreground="#cc0000" if lvl >= 0.99 else ("#007700" if gate else "#888888"))
        if abs(float(self.mic_gate_var.get()) - thr) > 0.0005:
            self.mic_gate_var.set(thr)
            self.mic_gate_lbl.config(text=f"{thr:.3f}")

    def _on_ptt_req(self):
        if self._status_updating:
            return
        self._send_cmd_safe(f"ptt {1 if self.ptt_req_var.get() else 0}")

    def _on_mic_param(self, what):
        if self._status_updating:
            return
        if what == "gain":
            v = float(self.mic_gain_var.get())
            self.mic_gain_lbl.config(text=f"{v:.1f}×")
            self.debounced_send.call(f"mic gain {v:.1f}")
        else:
            v = float(self.mic_gate_var.get())
            self.mic_gate_lbl.config(text=f"{v:.3f}")
            self.debounced_send.call(f"mic gate {v:.3f}")

    _DEV_KMODES = ["Straight", "Iambic A", "Iambic B"]

    def _handle_keyer_event(self, line):
        p = line[3:].strip()
        if p.startswith("e="):
            self._dev_sym += p[2:3]
            self.dev_sym_var.set(self._dev_sym)
        elif p.startswith("c="):
            self._dev_sym = ""
            self.dev_sym_var.set("")
            self._dev_decoded_append(p[2:3] or "?")
        elif p == "w":
            self._dev_decoded_append(" ")

    def _dev_decoded_append(self, s):
        self.dev_decoded.config(state="normal")
        self.dev_decoded.insert("end", s)
        if int(self.dev_decoded.index("end-1c").split(".")[0]) > 50:
            self.dev_decoded.delete("1.0", "2.0")
        self.dev_decoded.see("end")
        self.dev_decoded.config(state="disabled")

    def _dev_decoded_clear(self):
        self.dev_decoded.config(state="normal")
        self.dev_decoded.delete("1.0", "end")
        self.dev_decoded.config(state="disabled")
        self._dev_sym = ""
        self.dev_sym_var.set("")

    def _dev_keyer_send(self, what):
        if self._status_updating:
            return
        try:
            if what == "mode":
                self._send_cmd_safe(f"keyer mode {self._DEV_KMODES.index(self.dev_kmode_var.get())}")
            elif what == "wpm":
                self._send_cmd_safe(f"keyer wpm {int(self.dev_kwpm_var.get())}")
            elif what == "ratio":
                self._send_cmd_safe(f"keyer ratio {float(self.dev_kratio_var.get()):.1f}")
            elif what == "tone":
                self._send_cmd_safe(f"keyer tone {int(self.dev_sthz_var.get())}")
            elif what == "vol":
                v = int(float(self.dev_stvol_var.get()))
                self.dev_stvol_lbl.config(text=f"{v} %")
                self.debounced_send.call(f"keyer vol {v}")   # slider drags coalesce
            elif what == "test":
                self._send_cmd_safe(f"keyer test {1 if self.dev_sttest_var.get() else 0}")
        except (ValueError, tk.TclError) as e:
            self._log(f"[KEYER] invalid value: {e}", "error")

    # ------------------------------------------------------------------
    # Receiver (Si4732 behind the QO-100 downconverter)
    # ------------------------------------------------------------------
    # Commands map 1:1 onto the firmware's "rx ..." console commands; the
    # live values come from the "!R key=value ..." lines that every "rx"
    # command answers with. Polling "rx" once a second keeps them current.
    _RX_STEPS = [("10 Hz", 0.01), ("100 Hz", 0.1), ("1 kHz", 1.0), ("5 kHz", 5.0), ("9 kHz", 9.0)]
    _RX_BW_AM  = ["1000", "1800", "2000", "2500", "3000", "4000", "6000"]
    _RX_BW_SSB = ["500", "1000", "1200", "2200", "3000", "4000"]
    # The beacons are placed relative to the lower CW beacon as heard on the
    # bench (heard at 19359.8 with the old mirrored BFO sign, which was really 19360.2 kHz, with the TinySA as mixer LO at 720.137 MHz), because
    # their absolute IF depends on two uncalibrated oscillators. Offsets in kHz.
    _RX_BEACONS = [("Bake unten (CW)", 0.0), ("BPSK", 250.0), ("Bake oben (CW)", 500.0)]

    def _build_rx_tab(self):
        sc = ScrollableFrame(self.notebook)
        self.notebook.add(sc, text="RX")
        tab = sc.inner
        tab.columnconfigure(0, weight=1)

        self.rx_on_var    = tk.StringVar(value="—")
        self.rx_mode_var  = tk.StringVar(value="usb")
        self.rx_freq_var  = tk.StringVar(value="19358.0")
        self.rx_step_var  = tk.StringVar(value="1 kHz")
        self.rx_bw_var    = tk.StringVar(value="2200")
        self.rx_bfo_var   = tk.StringVar(value="500")
        self.rx_cal_var   = tk.StringVar(value="0")
        self.rx_vol_var   = tk.DoubleVar(value=50)
        self.rx_mon_var   = tk.BooleanVar(value=False)
        self.rx_monvol_var= tk.DoubleVar(value=50)
        self.rx_monagc_var= tk.BooleanVar(value=True)
        self.rx_rclk_var  = tk.StringVar(value="32k")
        self.rx_lo_var    = tk.BooleanVar(value=False)
        self.rx_live_var  = tk.BooleanVar(value=True)
        self.rx_rssi_var  = tk.StringVar(value="—")
        self.rx_snr_var   = tk.StringVar(value="—")
        self.rx_state_var = tk.StringVar(value="kein Status")
        self.rx_fresh_var = tk.StringVar(value="noch keine RX-Antwort")
        self.rx_scan_from = tk.StringVar(value="19350")
        self.rx_scan_to   = tk.StringVar(value="19366")
        self.rx_scan_step = tk.StringVar(value="1")
        self.rx_ref_var   = tk.StringVar(value="19360.2")
        self.rx_cw_var    = tk.BooleanVar(value=False)
        self.rx_cwbw_var  = tk.StringVar(value="150")
        self.rx_cwf0_var  = tk.StringVar(value="600")
        self.rx_level_var = tk.DoubleVar(value=25)
        self.rx_maxgain_var = tk.DoubleVar(value=36)
        self.rx_hang_var  = tk.DoubleVar(value=400)
        self.rx_poll_var  = tk.BooleanVar(value=True)

        # --- live status ---
        st = ttk.LabelFrame(tab, text="Status", padding=10)
        st.grid(row=0, column=0, sticky="ew", pady=(0, 8))
        st.columnconfigure(1, weight=1)
        ttk.Label(st, textvariable=self.rx_state_var, font=("Consolas", 11)).grid(
            row=0, column=0, columnspan=3, sticky="w")
        ttk.Label(st, text="RSSI:").grid(row=1, column=0, sticky="w", pady=(6, 0))
        self.rx_rssi_bar = ttk.Progressbar(st, maximum=80, mode="determinate")
        self.rx_rssi_bar.grid(row=1, column=1, sticky="ew", padx=6, pady=(6, 0))
        ttk.Label(st, textvariable=self.rx_rssi_var, width=10).grid(row=1, column=2, sticky="w", pady=(6, 0))
        ttk.Label(st, text="SNR:").grid(row=2, column=0, sticky="w")
        self.rx_snr_bar = ttk.Progressbar(st, maximum=40, mode="determinate")
        self.rx_snr_bar.grid(row=2, column=1, sticky="ew", padx=6)
        ttk.Label(st, textvariable=self.rx_snr_var, width=10).grid(row=2, column=2, sticky="w")
        bf = ttk.Frame(st)
        bf.grid(row=3, column=0, columnspan=3, sticky="w", pady=(6, 0))
        ttk.Checkbutton(bf, text="Live (1 s)", variable=self.rx_live_var).pack(side="left")
        ttk.Button(bf, text="Abfragen", command=lambda: self._send_cmd_safe("rx")).pack(side="left", padx=6)
        ttk.Button(bf, text="Diagnose", command=lambda: self._send_cmd_safe("rx diag")).pack(side="left")
        ttk.Label(bf, text="  (Diagnose erscheint im Console-Reiter)", foreground="gray").pack(side="left")
        ttk.Label(st, textvariable=self.rx_fresh_var, foreground="gray").grid(
            row=4, column=0, columnspan=3, sticky="w", pady=(4, 0))

        # --- receiver ---
        rf = ttk.LabelFrame(tab, text="Empfänger", padding=10)
        rf.grid(row=1, column=0, sticky="ew", pady=(0, 8))
        rf.columnconfigure(5, weight=1)
        ttk.Label(rf, text="Modus:").grid(row=0, column=0, sticky="w")
        for i, m in enumerate(("am", "usb", "lsb")):
            ttk.Radiobutton(rf, text=m.upper(), value=m, variable=self.rx_mode_var,
                            command=self._rx_set_mode).grid(row=0, column=1 + i, sticky="w", padx=(0, 6))
        ttk.Button(rf, text="Aus", command=lambda: self._send_cmd_safe("rx off")).grid(row=0, column=4, sticky="w")
        ttk.Label(rf, text="SSB lädt den Patch neu, das dauert ca. 3 s.", foreground="gray").grid(
            row=0, column=5, sticky="w", padx=(10, 0))

        ttk.Label(rf, text="Frequenz (kHz):").grid(row=1, column=0, sticky="w", pady=(8, 0))
        fe = ttk.Entry(rf, textvariable=self.rx_freq_var, width=12, font=("Consolas", 11))
        fe.grid(row=1, column=1, columnspan=2, sticky="w", pady=(8, 0))
        fe.bind("<Return>", lambda _e: self._rx_set_freq())
        ttk.Button(rf, text="Setzen", command=self._rx_set_freq).grid(row=1, column=3, sticky="w", pady=(8, 0))
        sf = ttk.Frame(rf)
        sf.grid(row=1, column=4, columnspan=2, sticky="w", pady=(8, 0))
        ttk.Button(sf, text="◀", width=3, command=lambda: self._rx_step(-1)).pack(side="left")
        ttk.Combobox(sf, textvariable=self.rx_step_var, values=[n for n, _ in self._RX_STEPS],
                     state="readonly", width=7).pack(side="left", padx=4)
        ttk.Button(sf, text="▶", width=3, command=lambda: self._rx_step(+1)).pack(side="left")

        ttk.Label(rf, text="Bandbreite (Hz):").grid(row=2, column=0, sticky="w", pady=(8, 0))
        self.rx_bw_combo = ttk.Combobox(rf, textvariable=self.rx_bw_var, values=self._RX_BW_SSB,
                                        state="readonly", width=8)
        self.rx_bw_combo.grid(row=2, column=1, columnspan=2, sticky="w", pady=(8, 0))
        self.rx_bw_combo.bind("<<ComboboxSelected>>",
                              lambda _e: self._send_cmd_safe(f"rx bw {self.rx_bw_var.get()}"))

        ttk.Label(rf, text="BFO (Hz):").grid(row=3, column=0, sticky="w", pady=(8, 0))
        be = ttk.Entry(rf, textvariable=self.rx_bfo_var, width=8)
        be.grid(row=3, column=1, columnspan=2, sticky="w", pady=(8, 0))
        be.bind("<Return>", lambda _e: self._rx_set_bfo())
        ttk.Button(rf, text="Setzen", command=self._rx_set_bfo).grid(row=3, column=3, sticky="w", pady=(8, 0))
        ttk.Label(rf, text="wird bei jeder Frequenzänderung neu gesetzt", foreground="gray").grid(
            row=3, column=4, columnspan=2, sticky="w", pady=(8, 0), padx=(6, 0))

        ttk.Label(rf, text="Kalibrierung (Hz):").grid(row=4, column=0, sticky="w", pady=(8, 0))
        ce = ttk.Entry(rf, textvariable=self.rx_cal_var, width=8)
        ce.grid(row=4, column=1, columnspan=2, sticky="w", pady=(8, 0))
        ce.bind("<Return>", lambda _e: self._send_cmd_safe(f"rx cal {self.rx_cal_var.get().strip()}"))
        ttk.Button(rf, text="Setzen",
                   command=lambda: self._send_cmd_safe(f"rx cal {self.rx_cal_var.get().strip()}")).grid(
            row=4, column=3, sticky="w", pady=(8, 0))
        ttk.Label(rf, text="LNB-Ablage; gemessen −4300", foreground="gray").grid(
            row=4, column=4, columnspan=2, sticky="w", pady=(8, 0), padx=(6, 0))

        LabeledScale(rf, "Si4732-Pegel", self.rx_vol_var, 0, 63, 1,
                     lambda v: self._send_cmd_safe(f"rx vol {int(v)}"), "{:.0f}").grid(
            row=5, column=0, columnspan=6, sticky="ew", pady=(8, 0))

        # --- beacons ---
        bk = ttk.LabelFrame(tab, text="QO-100-Baken (USB)", padding=10)
        bk.grid(row=2, column=0, sticky="ew", pady=(0, 8))
        ttk.Label(bk, text="Untere CW-Bake gehört bei (kHz):").grid(row=0, column=0, columnspan=2, sticky="w")
        ttk.Entry(bk, textvariable=self.rx_ref_var, width=10).grid(row=0, column=2, sticky="w", padx=4)
        for i, (name, off) in enumerate(self._RX_BEACONS):
            ttk.Button(bk, text=f"{name}\n+{off:.0f} kHz",
                       command=lambda o=off, n=name: self._rx_goto_beacon(o, "CW" in n)).grid(
                row=1, column=i, padx=4, pady=(6, 0), sticky="w")
        ttk.Label(bk, text="CW-Baken werden so abgestimmt, dass der Ton auf der Mitte des CW-Filters "
                           "liegt. Mit ◀ ▶ in 10-Hz-Schritten nachstimmen, bis er am lautesten ist. "
                           "CW: Ton mit Morse-Pausen; BPSK: gleichmäßiges Schnarren.",
                  foreground="gray", wraplength=620, justify="left").grid(
            row=2, column=0, columnspan=3, sticky="w", pady=(6, 0))

        # --- monitor ---
        mf = ttk.LabelFrame(tab, text="Kopfhörer-Monitor", padding=10)
        mf.grid(row=3, column=0, sticky="ew", pady=(0, 8))
        mf.columnconfigure(0, weight=1)
        top = ttk.Frame(mf)
        top.grid(row=0, column=0, sticky="w")
        ttk.Checkbutton(top, text="Empfängerton auf den Kopfhörer", variable=self.rx_mon_var,
                        command=lambda: self._send_cmd_safe(f"rx mon {1 if self.rx_mon_var.get() else 0}")
                        ).pack(side="left")
        ttk.Checkbutton(top, text="Audio-AGC", variable=self.rx_monagc_var,
                        command=lambda: self._send_cmd_safe(f"rx mon agc {1 if self.rx_monagc_var.get() else 0}")
                        ).pack(side="left", padx=(16, 0))
        ttk.Button(top, text="Status", command=lambda: self._send_cmd_safe("rx mon")).pack(side="left", padx=(16, 0))
        LabeledScale(mf, "Lautstärke", self.rx_monvol_var, 0, 100, 1,
                     lambda v: self._send_cmd_safe(f"rx mon vol {int(v)}"), "{:.0f} %").grid(
            row=1, column=0, sticky="ew", pady=(8, 0))
        LabeledScale(mf, "AGC-Zielpegel", self.rx_level_var, 5, 90, 1,
                     lambda v: self._send_cmd_safe(f"rx mon level {int(v)}"), "{:.0f} %").grid(
            row=3, column=0, sticky="ew", pady=(4, 0))
        cwf = ttk.Frame(mf)
        cwf.grid(row=4, column=0, sticky="w", pady=(8, 0))
        ttk.Checkbutton(cwf, text="CW-Filter", variable=self.rx_cw_var,
                        command=self._rx_send_cw).pack(side="left")
        ttk.Label(cwf, text="  Breite (Hz):").pack(side="left")
        cwb = ttk.Combobox(cwf, textvariable=self.rx_cwbw_var, values=["80", "150", "250", "400"],
                           state="readonly", width=5)
        cwb.pack(side="left")
        cwb.bind("<<ComboboxSelected>>", lambda _e: self._rx_send_cw())
        ttk.Label(cwf, text="  Tonhöhe (Hz):").pack(side="left")
        cwc = ttk.Entry(cwf, textvariable=self.rx_cwf0_var, width=6)
        cwc.pack(side="left")
        cwc.bind("<Return>", lambda _e: self._rx_send_cw())
        LabeledScale(mf, "AGC max. Verstärkung", self.rx_maxgain_var, 0, 36, 1,
                     lambda v: self._send_cmd_safe(f"rx mon maxgain {int(v)}"), "{:.0f} dB").grid(
            row=5, column=0, sticky="ew", pady=(8, 0))
        LabeledScale(mf, "AGC-Haltezeit", self.rx_hang_var, 0, 2000, 50,
                     lambda v: self._send_cmd_safe(f"rx mon hang {int(v)}"), "{:.0f} ms").grid(
            row=6, column=0, sticky="ew", pady=(4, 0))
        ttk.Checkbutton(mf, text="RSSI-Abfrage im Gerät (5×/s; zum Test auf Knistern abschalten)",
                        variable=self.rx_poll_var,
                        command=lambda: self._send_cmd_safe(f"rx mon poll {1 if self.rx_poll_var.get() else 0}")
                        ).grid(row=7, column=0, sticky="w", pady=(6, 0))
        ttk.Label(mf, text="Der Monitor belegt den ADC; die Sendequelle wird dabei auf PC umgeschaltet.",
                  foreground="gray").grid(row=2, column=0, sticky="w", pady=(4, 0))

        # --- clocks ---
        kf = ttk.LabelFrame(tab, text="Takte", padding=10)
        kf.grid(row=4, column=0, sticky="ew", pady=(0, 8))
        ttk.Label(kf, text="Referenz (RCLK):").grid(row=0, column=0, sticky="w")
        rc = ttk.Combobox(kf, textvariable=self.rx_rclk_var, values=["32k", "32m", "36", "25"],
                          state="readonly", width=6)
        rc.grid(row=0, column=1, sticky="w", padx=6)
        rc.bind("<<ComboboxSelected>>", lambda _e: self._send_cmd_safe(f"rclk freq {self.rx_rclk_var.get()}"))
        ttk.Label(kf, text="SSB empfängt nur mit 32k; dabei ist der eigene Mischer-LO aus.",
                  foreground="gray").grid(row=0, column=2, sticky="w")
        ttk.Checkbutton(kf, text="Eigener Mischer-LO (CLK0, 144 MHz × 5)", variable=self.rx_lo_var,
                        command=lambda: self._send_cmd_safe(f"lo {1 if self.rx_lo_var.get() else 0}")
                        ).grid(row=1, column=0, columnspan=3, sticky="w", pady=(6, 0))
        ttk.Label(kf, text="Aus lassen, wenn der TinySA den LO liefert.", foreground="gray").grid(
            row=2, column=0, columnspan=3, sticky="w")

        # --- scan ---
        scf = ttk.LabelFrame(tab, text="Suchlauf", padding=10)
        scf.grid(row=5, column=0, sticky="ew", pady=(0, 8))
        ttk.Label(scf, text="von").grid(row=0, column=0)
        ttk.Entry(scf, textvariable=self.rx_scan_from, width=8).grid(row=0, column=1, padx=4)
        ttk.Label(scf, text="bis").grid(row=0, column=2)
        ttk.Entry(scf, textvariable=self.rx_scan_to, width=8).grid(row=0, column=3, padx=4)
        ttk.Label(scf, text="Schritt (kHz)").grid(row=0, column=4)
        ttk.Entry(scf, textvariable=self.rx_scan_step, width=4).grid(row=0, column=5, padx=4)
        ttk.Button(scf, text="Start", command=lambda: self._send_cmd_safe(
            f"rx scan {self.rx_scan_from.get().strip()} {self.rx_scan_to.get().strip()} "
            f"{self.rx_scan_step.get().strip()}")).grid(row=0, column=6, padx=(8, 0))
        ttk.Label(scf, text="Ergebnis im Console-Reiter. Für Träger in AM suchen, in USB hören.",
                  foreground="gray").grid(row=1, column=0, columnspan=7, sticky="w", pady=(4, 0))

        self._rx_last_on = None
        self._rx_last_status_at = None
        self._rx_next_poll_at = 0.0
        self.master.after(1000, self._rx_live_tick)

    def _rx_set_mode(self):
        self._rx_last_on = None
        m = self.rx_mode_var.get()
        self.rx_bw_combo.config(values=self._RX_BW_AM if m == "am" else self._RX_BW_SSB)
        self._send_cmd_safe(f"rx {m}")

    def _rx_freq_khz(self):
        try:
            return float(self.rx_freq_var.get().replace(",", "."))
        except ValueError:
            return None

    def _rx_set_freq(self):
        khz = self._rx_freq_khz()
        if khz is None or not (2300.0 <= khz <= 26100.0):
            self._log("[RX] Frequenz 2300..26100 kHz", "error")
            return
        self.rx_freq_var.set(f"{khz:.2f}".rstrip("0").rstrip("."))
        self._send_cmd_safe(f"rx freq {khz:.3f}")

    def _rx_step(self, direction):
        khz = self._rx_freq_khz()
        if khz is None:
            return
        step = dict(self._RX_STEPS).get(self.rx_step_var.get(), 1.0)
        self.rx_freq_var.set(f"{khz + direction * step:.2f}")
        self._rx_set_freq()

    def _rx_set_bfo(self):
        try:
            hz = int(float(self.rx_bfo_var.get().replace(",", ".")))
        except ValueError:
            self._log("[RX] BFO in Hz", "error")
            return
        self._send_cmd_safe(f"rx bfo {hz}")

    def _rx_send_cw(self):
        if not self.rx_cw_var.get():
            self._send_cmd_safe("rx mon cw 0")
            return
        self._send_cmd_safe(f"rx mon cw {self.rx_cwbw_var.get()} {self.rx_cwf0_var.get().strip()}")

    def _rx_goto_beacon(self, offset_khz, is_cw):
        try:
            ref = float(self.rx_ref_var.get().replace(",", "."))
        except ValueError:
            self._log("[RX] Frequenz der unteren CW-Bake in kHz eintragen", "error")
            return
        if self.rx_mode_var.get() != "usb":
            self.rx_mode_var.set("usb")
            self._rx_set_mode()
        # In USB a carrier at C is heard at C - f. A CW beacon is put on the
        # CW filter's centre pitch; BPSK, ~800 Hz wide, about 1 kHz up.
        # No "rx bfo" afterwards: the firmware carries the sub-kHz part of
        # "rx freq" in the BFO, and a separate BFO command would undo it.
        try:
            pitch = float(self.rx_cwf0_var.get()) / 1000.0 if is_cw else 1.0
        except ValueError:
            pitch = 0.6
        self.rx_freq_var.set(f"{ref + offset_khz - pitch:.2f}")
        self._rx_set_freq()

    def _rx_live_tick(self):
        now = time.monotonic()
        try:
            if (self.rx_live_var.get() and self.worker.is_connected()
                    and self.notebook.tab(self.notebook.select(), "text") == "RX"
                    and now >= self._rx_next_poll_at):
                self.worker.send_line("rx")
                # Recheck OFF receivers too: they can be started externally.
                self._rx_next_poll_at = now + (5.0 if self._rx_last_on is False else 1.0)
        except Exception as e:
            self._log(f"[RX POLL ERROR] {e}", "error")
        self._rx_update_freshness(now)
        self.master.after(1000, self._rx_live_tick)

    def _rx_reset_status(self):
        self._rx_last_on = None
        self._rx_last_status_at = None
        self._rx_next_poll_at = 0.0
        self.rx_state_var.set("kein aktueller RX-Status")
        self.rx_rssi_var.set("—")
        self.rx_snr_var.set("—")
        self.rx_rssi_bar["value"] = 0
        self.rx_snr_bar["value"] = 0
        self.rx_fresh_var.set("noch keine RX-Antwort")

    def _rx_update_freshness(self, now):
        if not self.worker.is_connected():
            self.rx_fresh_var.set("RX-Daten: nicht verbunden")
        elif self._rx_last_status_at is None:
            self.rx_fresh_var.set("RX-Daten: noch keine Antwort")
        else:
            age = max(0.0, now - self._rx_last_status_at)
            stale_after = 7.0 if self._rx_last_on is False else 3.0
            prefix = "VERALTET — " if age > stale_after else ""
            live = "" if self.rx_live_var.get() else "Live aus; "
            self.rx_fresh_var.set(f"{prefix}{live}letzte RX-Antwort vor {age:.0f} s")

    def _handle_rx_status(self, line):
        kv = dict(t.split("=", 1) for t in line[3:].split() if "=" in t)
        def num(k, d=0):
            try: return int(kv.get(k, d))
            except ValueError: return d
        on = kv.get("on") == "1"
        self._rx_last_on = on
        now = time.monotonic()
        self._rx_last_status_at = now
        self._rx_next_poll_at = now + (1.0 if on else 5.0)
        self._rx_update_freshness(now)
        hz = num("hz")
        mode = kv.get("mode", "?")
        rssi, snr = num("rssi", -1), num("snr", -1)
        self.rx_state_var.set(
            f"{'EIN' if on else 'AUS'}  {mode.upper():3}  {hz/1000:10.3f} kHz  "
            f"BW {kv.get('bw', '?')} Hz  BFO {kv.get('bfo', '?')} Hz  Pegel {kv.get('vol', '?')}"
            + ("  STUMM" if kv.get("mute") == "1" else ""))
        self.rx_rssi_var.set(f"{rssi} dBµV" if rssi >= 0 else "—")
        self.rx_snr_var.set(f"{snr} dB" if snr >= 0 else "—")
        self.rx_rssi_bar["value"] = max(0, rssi)
        self.rx_snr_bar["value"] = max(0, snr)
        # Keep the controls in step with the radio, except while the user
        # is typing into a field.
        focus = self.master.focus_get()
        if mode in ("am", "usb", "lsb"):
            self.rx_mode_var.set(mode)
        if hz and not isinstance(focus, (ttk.Entry, tk.Entry)):
            self.rx_freq_var.set(f"{hz/1000:.2f}".rstrip("0").rstrip("."))
            self.rx_bfo_var.set(kv.get("bfo", self.rx_bfo_var.get()))
            self.rx_cal_var.set(kv.get("cal", self.rx_cal_var.get()))
        if kv.get("bw", "").isdigit():
            self.rx_bw_var.set(kv["bw"])

    def _build_gpsdo_tab(self):
        tab = ttk.Frame(self.notebook, padding=10)
        self.notebook.add(tab, text="GPSDO")
        tab.columnconfigure(0, weight=1)

        # Two big status indicators
        sf = ttk.LabelFrame(tab, text="Status", padding=10)
        sf.grid(row=0, column=0, sticky="ew", pady=(0, 8))
        sf.columnconfigure(0, weight=1)
        sf.columnconfigure(1, weight=1)

        ttk.Label(sf, text="GPS Signal:", anchor="w").grid(
            row=0, column=0, sticky="w", padx=(0, 4))
        self.gpsdo_sig_label = ttk.Label(
            sf, textvariable=self.gpsdo_sig_var,
            font=("TkDefaultFont", 11, "bold"), anchor="w")
        self.gpsdo_sig_label.grid(row=0, column=1, sticky="w", pady=2)

        ttk.Label(sf, text="GPS Position:", anchor="w").grid(
            row=1, column=0, sticky="w", padx=(0, 4))
        self.gpsdo_fix_label = ttk.Label(
            sf, textvariable=self.gpsdo_fix_var,
            font=("TkDefaultFont", 11, "bold"), anchor="w")
        self.gpsdo_fix_label.grid(row=1, column=1, sticky="w", pady=2)

        # GPS detail fields
        df = ttk.LabelFrame(tab, text="GPS", padding=10)
        df.grid(row=1, column=0, sticky="ew", pady=(0, 8))
        df.columnconfigure(1, weight=1)

        ttk.Label(df, text="UTC time:").grid(row=0, column=0, sticky="w", padx=(0, 8))
        ttk.Label(df, textvariable=self.gpsdo_utc_var, anchor="w",
                  font=("Consolas", 11)).grid(row=0, column=1, sticky="w")

        ttk.Label(df, text="Locator:").grid(row=1, column=0, sticky="w", padx=(0, 8))
        ttk.Label(df, textvariable=self.gpsdo_loc_var, anchor="w",
                  font=("Consolas", 11)).grid(row=1, column=1, sticky="w")

        ttk.Label(df, text="Satellites used:").grid(row=2, column=0, sticky="w", padx=(0, 8))
        ttk.Label(df, textvariable=self.gpsdo_sats_var, anchor="w").grid(row=2, column=1, sticky="w")

        ttk.Label(df, text="Satellites visible:").grid(row=3, column=0, sticky="w", padx=(0, 8))
        ttk.Label(df, textvariable=self.gpsdo_vis_var, anchor="w").grid(row=3, column=1, sticky="w")

        ttk.Label(df, text="Altitude:").grid(row=4, column=0, sticky="w", padx=(0, 8))
        ttk.Label(df, textvariable=self.gpsdo_alt_var, anchor="w").grid(row=4, column=1, sticky="w")

        ttk.Label(df, text="CLK1 (52 MHz):").grid(row=5, column=0, sticky="w", padx=(0, 8))
        ttk.Label(df, textvariable=self.gpsdo_clk1_var, anchor="w").grid(row=5, column=1, sticky="w")

        # TX gate (firmware blocks TX until GPS UTC is valid)
        gf = ttk.LabelFrame(tab, text="TX gate", padding=10)
        gf.grid(row=2, column=0, sticky="ew", pady=(0, 8))
        gf.columnconfigure(0, weight=1)
        self.txgate_tab_lbl = ttk.Label(gf, textvariable=self.txgate_var,
                                        font=("TkDefaultFont", 10, "bold"))
        self.txgate_tab_lbl.grid(row=0, column=0, sticky="w")
        ttk.Checkbutton(gf, text="Require GPS UTC before transmitting (gpsgate)",
                        variable=self.gps_gate_var,
                        command=self._on_gps_gate_toggle).grid(row=1, column=0, sticky="w", pady=(4, 0))
        ttk.Label(gf, text="Off = bench-test override. Without GPS discipline the frequency may be "
                           "off by up to ±6 kHz at 2.4 GHz. The override resets to ON at every boot.",
                  foreground="gray", wraplength=520, justify="left").grid(row=2, column=0, sticky="w")

        # Manual refresh button
        bf = ttk.Frame(tab)
        bf.grid(row=3, column=0, sticky="w", pady=(4, 0))
        ttk.Button(bf, text="Refresh now",
                   command=lambda: self._send_cmd_safe("gpsdo")).pack(side="left")
        ttk.Label(bf, text="  (requests immediate status update)",
                  foreground="gray").pack(side="left")

    _LOG_MAX = 5000   # buffered console lines; oldest are dropped beyond this

    def _build_console_tab(self):
        tab = ttk.Frame(self.notebook, padding=10)
        self.notebook.add(tab, text="Console")
        tab.columnconfigure(0, weight=1)
        tab.rowconfigure(1, weight=1)

        # --- Toolbar: display filters ---
        tb = ttk.Frame(tab)
        tb.grid(row=0, column=0, sticky="ew", pady=(0, 6))
        self.log_timestamps_var  = tk.BooleanVar(value=True)
        self.log_show_status_var = tk.BooleanVar(value=False)
        self.log_show_gpsdo_var  = tk.BooleanVar(value=True)
        self.log_autoscroll_var  = tk.BooleanVar(value=True)
        self.log_filter_var      = tk.StringVar(value="")
        self.log_count_var       = tk.StringVar(value="0 lines")
        ttk.Checkbutton(tb, text="Timestamps", variable=self.log_timestamps_var,
                        command=self._rerender_log).pack(side="left")
        ttk.Checkbutton(tb, text="Push-Meldungen (!S/!K/!M)", variable=self.log_show_status_var,
                        command=self._rerender_log).pack(side="left", padx=(8, 0))
        ttk.Checkbutton(tb, text="GPSDO lines", variable=self.log_show_gpsdo_var,
                        command=self._rerender_log).pack(side="left", padx=(8, 0))
        ttk.Checkbutton(tb, text="Autoscroll",
                        variable=self.log_autoscroll_var).pack(side="left", padx=(8, 0))
        ttk.Label(tb, text="Filter:").pack(side="left", padx=(14, 3))
        fe = ttk.Entry(tb, textvariable=self.log_filter_var, width=18)
        fe.pack(side="left")
        fe.bind("<KeyRelease>", lambda e: self._rerender_log())
        ttk.Label(tb, textvariable=self.log_count_var, foreground="gray").pack(side="right")

        # --- Log view (read-only) ---
        lf = ttk.Frame(tab)
        lf.grid(row=1, column=0, sticky="nsew")
        lf.columnconfigure(0, weight=1)
        lf.rowconfigure(0, weight=1)
        self.log_text = tk.Text(lf, wrap="word", font=("Consolas", 9), state="disabled")
        self.log_text.grid(row=0, column=0, sticky="nsew")
        sb = ttk.Scrollbar(lf, orient="vertical", command=self.log_text.yview)
        sb.grid(row=0, column=1, sticky="ns")
        self.log_text.config(yscrollcommand=sb.set)
        self.log_text.tag_configure("ts",     foreground="#999999")
        self.log_text.tag_configure("sent",   foreground="#0066cc", font=("Consolas", 9, "bold"))
        self.log_text.tag_configure("ok",     foreground="#007700")
        self.log_text.tag_configure("recv",   foreground="#222222")
        self.log_text.tag_configure("warn",   foreground="#cc6600")
        self.log_text.tag_configure("error",  foreground="#cc0000", font=("Consolas", 9, "bold"))
        self.log_text.tag_configure("gpsdo",  foreground="#4a6fa5")
        self.log_text.tag_configure("status", foreground="#999999")
        self.log_text.tag_configure("info",   foreground="#666666", font=("Consolas", 9, "italic"))

        # --- Command line with history (Up/Down) ---
        cf = ttk.Frame(tab)
        cf.grid(row=2, column=0, sticky="ew", pady=(6, 0))
        cf.columnconfigure(1, weight=1)
        ttk.Label(cf, text=">", font=("Consolas", 10, "bold")).grid(row=0, column=0, padx=(0, 4))
        self.console_cmd_var = tk.StringVar()
        self.console_entry = ttk.Entry(cf, textvariable=self.console_cmd_var, font=("Consolas", 10))
        self.console_entry.grid(row=0, column=1, sticky="ew")
        self.console_entry.bind("<Return>", self._console_send)
        self.console_entry.bind("<Up>",     lambda e: self._console_hist(-1))
        self.console_entry.bind("<Down>",   lambda e: self._console_hist(+1))
        ttk.Button(cf, text="Send", command=self._console_send).grid(row=0, column=2, padx=(4, 0))

        # --- Buttons ---
        bf = ttk.Frame(tab)
        bf.grid(row=3, column=0, sticky="ew", pady=(8, 0))
        ttk.Button(bf, text="Clear Log", command=self._clear_log).pack(side="left")
        ttk.Button(bf, text="Save Log…", command=self._save_log).pack(side="left", padx=(6, 0))
        ttk.Button(bf, text="Send All Settings", command=self._send_all).pack(side="right")
        ttk.Button(bf, text="Save to Flash",
                   command=lambda: self._send_cmd_safe("save")).pack(side="right", padx=(0, 6))

    def _console_send(self, _event=None):
        cmd = self.console_cmd_var.get().strip()
        if not cmd:
            return "break"
        if not self._cmd_history or self._cmd_history[-1] != cmd:
            self._cmd_history.append(cmd)
        self._cmd_hist_idx = None
        self.console_cmd_var.set("")
        self._send_cmd_safe(cmd)
        return "break"

    def _console_hist(self, step):
        if not self._cmd_history:
            return "break"
        if self._cmd_hist_idx is None:
            self._cmd_hist_idx = len(self._cmd_history)
        self._cmd_hist_idx = max(0, min(len(self._cmd_history), self._cmd_hist_idx + step))
        if self._cmd_hist_idx < len(self._cmd_history):
            self.console_cmd_var.set(self._cmd_history[self._cmd_hist_idx])
        else:
            self.console_cmd_var.set("")
        self.console_entry.icursor("end")
        return "break"

    # CW KEYER
    def _cw_refresh_ports(self):
        if not HAS_SERIAL: return
        ports = [p.device for p in serial.tools.list_ports.comports()]
        self.cw_port_combo['values'] = ports
        if ports: self.cw_port_var.set(ports[0])

    def _cw_mode_changed(self, _=None):
        is_paddle = self.cw_mode_var.get() != 'Straight'
        self._cw_dah_cb.config(state='normal' if is_paddle else 'disabled')

    def _cw_set_widgets_state(self, state):
        for w in [self.cw_port_combo, self.cw_baud_combo, self.cw_mode_combo,
                  self.cw_dit_combo,  self._cw_dah_cb,    self.cw_active_low_cb]:
            try: w.config(state=state)
            except: pass
        if state == 'normal':
            self._cw_mode_changed()

    def _cw_toggle(self):
        if self._cw_running: self._cw_stop()
        else:                self._cw_start()

    def _cw_start(self):
        if not HAS_SERIAL:
            messagebox.showerror("Fehler", "pip install pyserial")
            return
        port = self.cw_port_var.get()
        if not port:
            messagebox.showerror("Fehler", "Keinen FTDI-Port ausgewaehlt!")
            return
        mode_map = {'Straight': Keyer.STRAIGHT,
                    'Iambic A': Keyer.IAMBIC_A,
                    'Iambic B': Keyer.IAMBIC_B}
        self.keyer.set_mode(mode_map[self.cw_mode_var.get()])
        self.keyer.set_wpm(self.cw_wpm_var.get())
        self.audio.set_freq(self.cw_tone_var.get())
        self.audio.set_vol(self.cw_vol_var.get() / 100)
        is_paddle = self.cw_mode_var.get() != 'Straight'
        dah_pin = self.cw_dah_var.get() if is_paddle else None
        self.key_reader = KeyReader(
            port=port, baud=int(self.cw_baud_var.get()),
            dit_pin=self.cw_dit_var.get(), dah_pin=dah_pin,
            active_low=self.cw_active_low_var.get())
        ok, err = self.key_reader.connect()
        if not ok:
            messagebox.showerror("FTDI Fehler", f"Verbindung fehlgeschlagen:\n{err}")
            self.key_reader = None
            return
        self._cw_running = True
        self._cw_thread  = threading.Thread(target=self._cw_loop, daemon=True)
        self._cw_thread.start()
        self.cw_conn_btn.config(text="DISCONNECT")
        self.cw_conn_status_var.set("● CONNECTED")
        self.cw_conn_lbl.config(foreground="green")
        self._cw_set_widgets_state('disabled')

    def _cw_stop(self):
        self._cw_running = False
        self.keyer.reset()
        if self.key_reader:
            self.key_reader.disconnect()
            self.key_reader = None
        # FIX B: reset shared key state so GUI shows "OFFEN" immediately
        self._cw_key_state = (False, False)
        self.cw_conn_btn.config(text="▶  CONNECT")
        self.cw_conn_status_var.set("● DISCONNECTED")
        self.cw_conn_lbl.config(foreground="red")
        self.cw_key_lbl.config(text="KEY: OPEN", foreground="gray")
        self._cw_set_widgets_state('normal')

    def _cw_loop(self):
        # FIX B: this is the ONLY place that calls key_reader.read() – eliminates
        # the race condition with _cw_gui_update() that caused GUI freezes.
        while self._cw_running:
            try:
                dit, dah = self.key_reader.read()
                self._cw_key_state = (dit, dah)
            except Exception:
                self.master.after(0, self._cw_stop)
                break
            self.keyer.tick(dit, dah)
            time.sleep(0.002)

    def _cw_gui_update(self):
        if self._cw_running:
            # FIX B: read from shared variable instead of calling key_reader.read()
            dit, dah = self._cw_key_state
            down = dit or dah
            self.cw_key_lbl.config(
                text="KEY: PRESSED" if down else "KEY: OPEN",
                foreground="green" if down else "gray")
        sym = self.keyer.get_sym_buf()
        self.cw_sym_lbl.config(text=sym)
        self.master.after(50, self._cw_gui_update)

    def _cw_on_esc(self, _=None):
        self._abort_cw_text()
        if self._cw_running:
            self._cw_stop()

    def _start_cw_text(self):
        text = self.cw_text_var.get().strip().upper()
        if not text:
            return
        unsupported = sorted({c for c in text if c != ' ' and c not in MORSE_CODE})
        if unsupported:
            messagebox.showerror("CW Text", f"Unsupported characters: {' '.join(unsupported)}")
            return
        if self._cw_text_thread and self._cw_text_thread.is_alive():
            messagebox.showinfo("CW Text", "CW text is already being sent.")
            return
        if not self.worker.is_connected():
            messagebox.showwarning("Not connected", "Please connect to the SX1280 first!")
            return
        self._cw_stop_evt.clear()
        wpm = max(5, min(60, int(self.cw_wpm_var.get())))
        self._cw_text_thread = threading.Thread(
            target=self._cw_text_worker, args=(text, wpm), daemon=True)
        self._cw_text_thread.start()

    def _abort_cw_text(self):
        self._cw_stop_evt.set()
        try: self._send_cmd_safe("stop")
        except: pass

    def _cw_text_worker(self, text, wpm):
        unit_s = 1.2 / float(wpm)
        weight = self.cw_weight_var.get()

        def sleep_ok(dur):
            end = time.monotonic() + dur
            while time.monotonic() < end:
                if self._cw_stop_evt.is_set():
                    return False
                time.sleep(min(0.02, end - time.monotonic()))
            return True

        self.master.after(0, lambda: self.cw_text_btn.config(state='disabled'))
        try:
            for ch in text:
                if self._cw_stop_evt.is_set():
                    break
                if ch == ' ':
                    self.master.after(0, lambda: self.cw_sym_lbl.config(text='_'))
                    if not sleep_ok(unit_s * 7): break
                    continue
                code = MORSE_CODE[ch]
                for j, sym in enumerate(code):
                    if self._cw_stop_evt.is_set(): break
                    self.master.after(0, lambda s=sym: self.cw_sym_lbl.config(text=s))
                    try: self.worker.send_line("cw")
                    except: break
                    dur = unit_s if sym == '.' else unit_s * weight
                    if not sleep_ok(dur): break
                    try: self.worker.send_line("stop")
                    except: break
                    if j < len(code) - 1 and not sleep_ok(unit_s): break
                if self._cw_stop_evt.is_set(): break
                # inter-character gap (3 units total, 1 already done)
                if not sleep_ok(unit_s * 2): break
        finally:
            try: self.worker.send_line("stop")
            except: pass
            self.master.after(0, lambda: self.cw_sym_lbl.config(text=''))
            self.master.after(0, lambda: self.cw_text_btn.config(state='normal'))

    def _handle_status_push(self, line):
        """Parse firmware !S status push and sync GUI widgets.

        Format: '!S mode=0 tune=0 tx=1 pwr=13 ppm=0.0000 freq=2400400000.0'
        Sent by firmware on state change or heartbeat.
        """
        try:
            parts = line.strip().split()
            kv = {}
            for p in parts[1:]:
                if "=" in p:
                    k, v = p.split("=", 1)
                    kv[k] = v

            self._status_updating = True

            if "mode" in kv:
                new_mode = "cw" if kv["mode"] == "1" else "usb"
                if self.mode_var.get() != new_mode:
                    self.mode_var.set(new_mode)

            if "tune" in kv:
                new_tune = kv["tune"] == "1"
                if self.tune_var.get() != new_tune:
                    self.tune_var.set(new_tune)
                    self._update_tune_button()

            if "tx" in kv:
                new_tx = kv["tx"] == "1"
                if self.tx_enabled_var.get() != new_tx:
                    self.tx_enabled_var.set(new_tx)
                    self._update_tx_button()

            if "pwr" in kv:
                new_pwr = int(kv["pwr"])
                if self.txpwr_var.get() != new_pwr:
                    self.txpwr_var.set(new_pwr)

            if "ppm" in kv:
                new_ppm = float(kv["ppm"])
                if abs(self.ppm_var.get() - new_ppm) > 0.0001:
                    self.ppm_var.set(new_ppm)
                    self.ppm_label.config(text=f"{new_ppm:.3f} ppm")

            if "freq" in kv:
                new_freq = float(kv["freq"])
                if abs(self.config.freq_hz - new_freq) > 0.5:
                    self.config.freq_hz = new_freq
                    self.freq_mhz_var.set(new_freq / 1_000_000)
                    self.freq_khz_var.set(f"{new_freq / 1000:.1f}")
                    self._update_freq_display()

            if "gps" in kv or "gate" in kv:
                self._update_txgate(kv.get("gps"), kv.get("gate"))

            if "dirty" in kv:
                self.cfg_dirty_var.set("● unsaved (autosave 5 s idle)" if kv["dirty"] == "1" else "")

            if "kwpm" in kv:
                w = int(kv["kwpm"])
                if self.dev_kwpm_var.get() != w:
                    self.dev_kwpm_var.set(w)
            if "kmode" in kv:
                m = self._DEV_KMODES[max(0, min(2, int(kv["kmode"])))]
                if self.dev_kmode_var.get() != m:
                    self.dev_kmode_var.set(m)
            if "sthz" in kv:
                hz = int(kv["sthz"])
                if self.dev_sthz_var.get() != hz:
                    self.dev_sthz_var.set(hz)
            if "stvol" in kv:
                vol = int(kv["stvol"])
                if int(float(self.dev_stvol_var.get())) != vol:
                    self.dev_stvol_var.set(vol)
                    self.dev_stvol_lbl.config(text=f"{vol} %")
            if "src" in kv:
                src = "mic" if kv["src"] == "1" else "pc"
                if self.audio_src_var.get() != src:
                    self.audio_src_var.set(src)

            if "ptt" in kv:
                # bit0 = pressed, bit1 = required, bit2 = currently blocking TX
                p = int(kv["ptt"])
                req = bool(p & 2)
                if self.ptt_req_var.get() != req:
                    self.ptt_req_var.set(req)
                if p & 4:
                    self.ptt_state_var.set("PTT open — TX blocked")
                    self.ptt_state_lbl.config(foreground="#cc6600")
                elif p & 1:
                    self.ptt_state_var.set("PTT pressed")
                    self.ptt_state_lbl.config(foreground="#cc0000")
                else:
                    self.ptt_state_var.set("PTT —")
                    self.ptt_state_lbl.config(foreground="#444444")
            if "key" in kv or "pdl" in kv:
                pdl = int(kv.get("pdl", "0"))
                key = kv.get("key", "0") == "1"
                pdl_txt = ("dit " if pdl & 1 else "    ") + ("dah" if pdl & 2 else "   ")
                self.dev_key_var.set(f"Paddle: [{pdl_txt}]   Key: {'DOWN' if key else 'up'}")
                self.dev_key_lbl.config(foreground="#cc0000" if key else "#444444")

            self._status_updating = False
        except Exception as e:
            self._status_updating = False
            self._log(f"[STATUS PARSE ERROR] {e}: {line!r}", "error")

    def _update_txgate_gps_lost(self, lost):
        """Keep the connection-bar banner in sync with the GPSDO tab."""
        if lost == self._gps_lost:
            return
        self._gps_lost = lost
        self._update_txgate(None, None)

    def _update_txgate(self, gps, gate):
        if gps is not None:
            self._gps_ready = (gps == "1")
        if gate is not None:
            self._gps_gate = (gate == "1")
            if self.gps_gate_var.get() != self._gps_gate:
                self.gps_gate_var.set(self._gps_gate)
        if self._gps_ready is None:
            return
        if self._gps_lost:
            text, color = "GPS SIGNAL LOST — TX frequency is drifting", "#cc0000"
        elif self._gps_ready:
            text, color = "TX allowed — GPS disciplined", "#007700"
        elif self._gps_gate is False:
            text, color = "TX allowed — GPS GATE OVERRIDE, no GPS discipline!", "#cc6600"
        else:
            text, color = "TX BLOCKED — waiting for GPS UTC", "#cc0000"
        self.txgate_var.set(text)
        for lbl in (self.txgate_bar_lbl, self.txgate_tab_lbl):
            lbl.config(foreground=color)

    def _on_gps_gate_toggle(self):
        if self._status_updating:
            return
        self._send_cmd_safe(f"gpsgate {1 if self.gps_gate_var.get() else 0}")

    def _parse_fw_line(self, line):
        m = re.search(r'\b(?:fw=|FW[:\] ]\s*)(\S+)\s+'
                      r'(?:git=(\S+)\s+)?built[= ]\s*(.+?)(?:\.\s*Type|\s*$)', line)
        if m:
            revision = f" git={m.group(2)}" if m.group(2) else ""
            self.fw_version_var.set(f"FW {m.group(1)}{revision}  ({m.group(3).strip()})")

    def _on_mode_change(self):
        if self._status_updating:
            return
        self._send_cmd_safe(f"mode {self.mode_var.get()}")

    def _toggle_tune(self):
        new_state = not self.tune_var.get()
        self.tune_var.set(new_state)
        self._update_tune_button()
        self._send_cmd_safe(f"tune {'1' if new_state else '0'}")

    def _update_tune_button(self):
        if self.tune_var.get():
            self.tune_button.config(text="TUNE ON",  bg="#ff8800", fg="white",
                                     activebackground="#ffaa00", activeforeground="white")
        else:
            self.tune_button.config(text="TUNE OFF", bg="#cccccc", fg="black",
                                     activebackground="#dddddd", activeforeground="black")

    # ORIGINAL
    def _refresh_ports(self):
        ports = list_serial_ports()
        self.port_map = {label: dev for dev, label in ports}
        labels = list(self.port_map.keys()) or ["(no ports found)"]
        self.port_combo["values"] = labels
        if labels: self.port_var.set(labels[0])
        self._log("Ports refreshed", "info")

    def _connect(self):
        if not HAS_SERIAL:
            messagebox.showerror("Missing dependency", "pip install pyserial")
            return
        label = self.port_var.get()
        port  = self.port_map.get(label)
        if not port or "no ports" in label.lower():
            messagebox.showerror("No port", "No serial port selected.")
            return
        try:
            self.worker.connect(port)
            self._rx_reset_status()
            self.status_var.set(f"🟢 Connected: {port}")
            self._log(f"Connected to {port} @ 115200 8N1 — requesting 'get' and 'status'", "info")
            self.master.after(500, lambda: self._send_cmd_safe("get"))
            self.master.after(800, lambda: self._send_cmd_safe("status"))
            self._start_heartbeat()
        except Exception as e:
            messagebox.showerror("Connection failed", str(e))
            self.status_var.set("🔴 Connection failed")

    def _disconnect(self):
        if self._heartbeat_id is not None:
            self.master.after_cancel(self._heartbeat_id)
            self._heartbeat_id = None
        self.worker.disconnect()
        self._rx_reset_status()
        self._rx_update_freshness(time.monotonic())
        self.status_var.set("⚫ Disconnected")
        self._log("Disconnected", "info")

    def _start_heartbeat(self):
        """Request !S status every 2 s so GUI stays in sync with hardware encoder."""
        if not self.worker.is_connected():
            self._heartbeat_id = None
            return
        try:
            self.worker.send_line("status")
        except Exception:
            pass
        self._heartbeat_id = self.master.after(2000, self._start_heartbeat)

    def _send_cmd_safe(self, cmd):
        try:
            if not self.worker.is_connected():
                self._log(f"[NOT CONNECTED] {cmd}", "error")
                return
            self.worker.send_line(cmd)
            self._log(cmd, "sent")
        except Exception as e:
            self._log(f"[SEND ERROR] {e}", "error")

    def _send_enable(self, which, enabled):
        self._send_cmd_safe(f"enable {which} {'1' if enabled else '0'}")

    def _toggle_tx(self):
        new_state = not self.tx_enabled_var.get()
        self.tx_enabled_var.set(new_state)
        self._update_tx_button()
        self._send_cmd_safe(f"tx {'1' if new_state else '0'}")

    def _update_tx_button(self):
        if self.tx_enabled_var.get():
            self.tx_button.config(text="TX ON",  bg="#00cc00", fg="white",
                                   activebackground="#00ff00", activeforeground="white")
        else:
            self.tx_button.config(text="TX OFF", bg="#cccccc", fg="black",
                                   activebackground="#dddddd", activeforeground="black")

    def _on_ppm_slider(self, _val):
        if self._status_updating:
            return
        ppm = self.ppm_var.get()
        self.ppm_label.config(text=f"{ppm:.3f} ppm")
        self._update_freq_display()
        self._send_cmd_safe(f"ppm {ppm:.4f}")

    def _update_freq_display(self):
        try:    hz = float(self.freq_khz_var.get()) * 1000
        except: hz = self.config.freq_hz
        dl_hz = hz + QO100_LO_HZ
        self.freq_mhz_label.config(text=f"{hz/1_000_000:.4f} MHz ↑")
        self.downlink_label.config(text=f"{dl_hz/1_000_000:.4f} MHz ↓")
        self.dl_mhz_var.set(dl_hz / 1_000_000)
        self.dl_khz_var.set(f"{dl_hz / 1000:.1f}")

    def _on_global_scroll(self, event):
        if not self.scroll_tune_enabled_var.get(): return
        try:
            if self.notebook.index(self.notebook.select()) != 0: return
        except: return
        return self._on_freq_scroll(event)

    def _on_freq_scroll(self, event):
        if not self.scroll_tune_enabled_var.get(): return
        if   event.num == 4: delta = 50
        elif event.num == 5: delta = -50
        elif hasattr(event, 'delta'): delta = 50 if event.delta > 0 else -50
        else: return
        try:    hz = float(self.freq_khz_var.get()) * 1000
        except: hz = self.config.freq_hz
        new_hz = max(self.FREQ_MIN_HZ, min(self.FREQ_MAX_HZ, hz + delta))
        self.freq_khz_var.set(f"{new_hz / 1000:.1f}")
        self.freq_mhz_var.set(new_hz / 1_000_000)
        self._update_freq_display()
        self._send_cmd_safe(f"freq {new_hz:.1f}")
        return "break"

    def _on_freq_slider(self, _val):
        if self._status_updating:
            return
        hz = max(self.FREQ_MIN_HZ, min(self.FREQ_MAX_HZ,
                 int(round(self.freq_mhz_var.get() * 1_000_000 / 100)) * 100))
        self.freq_khz_var.set(f"{hz / 1000:.1f}")
        self._update_freq_display()
        self._send_cmd_safe(f"freq {hz}")

    def _on_dl_slider(self, _val):
        if self._status_updating:
            return
        dl_hz = max(self.FREQ_MIN_HZ + QO100_LO_HZ,
                    min(self.FREQ_MAX_HZ + QO100_LO_HZ,
                        int(round(self.dl_mhz_var.get() * 1_000_000 / 100)) * 100))
        ul_hz = dl_hz - QO100_LO_HZ
        self.dl_mhz_var.set(dl_hz / 1_000_000)
        self.dl_khz_var.set(f"{dl_hz / 1000:.1f}")
        self.freq_mhz_var.set(ul_hz / 1_000_000)
        self.freq_khz_var.set(f"{ul_hz / 1000:.1f}")
        self.freq_mhz_label.config(text=f"{ul_hz/1_000_000:.4f} MHz ↑")
        self.downlink_label.config(text=f"{dl_hz/1_000_000:.4f} MHz ↓")
        self._send_cmd_safe(f"freq {ul_hz}")

    def _send_freq(self, hz):
        self._send_cmd_safe(f"freq {hz:.1f}")

    def _send_freq_from_entry(self):
        try:
            khz = float(self.freq_khz_var.get().replace(",", "."))
            hz = round(khz * 1000 / 100) * 100  # snap to 0.1 kHz
            hz = max(self.FREQ_MIN_HZ, min(self.FREQ_MAX_HZ, hz))
            self.freq_khz_var.set(f"{hz / 1000:.1f}")
            self.freq_mhz_var.set(hz / 1_000_000)
            self._update_freq_display()
            self._send_cmd_safe(f"freq {hz:.1f}")
        except ValueError:
            messagebox.showerror("Invalid frequency", "Frequency must be a number in kHz")

    def _send_dl_from_entry(self):
        try:
            khz = float(self.dl_khz_var.get().replace(",", "."))
            dl_hz = round(khz * 1000 / 100) * 100
            dl_hz = max(self.FREQ_MIN_HZ + QO100_LO_HZ,
                        min(self.FREQ_MAX_HZ + QO100_LO_HZ, dl_hz))
            ul_hz = dl_hz - QO100_LO_HZ
            self.dl_khz_var.set(f"{dl_hz / 1000:.1f}")
            self.dl_mhz_var.set(dl_hz / 1_000_000)
            self.freq_khz_var.set(f"{ul_hz / 1000:.1f}")
            self.freq_mhz_var.set(ul_hz / 1_000_000)
            self.freq_mhz_label.config(text=f"{ul_hz/1_000_000:.4f} MHz ↑")
            self.downlink_label.config(text=f"{dl_hz/1_000_000:.4f} MHz ↓")
            self._send_cmd_safe(f"freq {ul_hz:.1f}")
        except ValueError:
            messagebox.showerror("Invalid frequency", "Frequency must be a number in kHz")

    def _start_cw(self): self._send_cmd_safe("cw")
    def _stop_cw(self):
        self._cw_test_stop_pending = True   # suppress keyer TX-button reset in _poll_rx
        self._send_cmd_safe("stop")

    def _cw_toggle_tx(self):
        if not self.worker.is_connected():
            messagebox.showwarning("Not connected",
                                   "Please connect to the SX1280 first!")
            return
        self._cw_tx_active = not self._cw_tx_active
        if self._cw_tx_active:
            # PC keyer may key the firmware: make sure it is in CW mode
            self._send_cmd_safe("mode cw")
            self.cw_tx_btn.config(text="🔴  TX ON")
        else:
            # Only release the key/carrier. The mode is a persistent user
            # setting now (OLED, flash, on-device keyer) — never flip it here.
            self._send_cmd_safe("stop")
            self.cw_tx_btn.config(text="⬛  TX OFF")

    def _send_manual_cmd(self):
        cmd = self.manual_cmd_var.get().strip()
        if cmd:
            self._send_cmd_safe(cmd)
            self.manual_cmd_var.set("")

    def _send_all(self):
        self._send_cmd_safe(f"mode {self.mode_var.get()}")
        try:
            hz = round(float(self.freq_khz_var.get()) * 1000 / 100) * 100
            hz = max(self.FREQ_MIN_HZ, min(self.FREQ_MAX_HZ, hz))
        except ValueError:
            hz = int(self.config.freq_hz)
        self._send_cmd_safe(f"freq {hz}")
        try:
            ppm = float(str(self.ppm_var.get()).replace(",", "."))
            if -100 <= ppm <= 100: self._send_cmd_safe(f"ppm {ppm}")
        except: pass
        self._send_cmd_safe(f"txpwr {int(self.txpwr_var.get())}")
        self._send_cmd_safe(f"enable bp   {'1' if self.en_bp_var.get()   else '0'}")
        self._send_cmd_safe(f"enable eq   {'1' if self.en_eq_var.get()   else '0'}")
        self._send_cmd_safe(f"enable comp {'1' if self.en_comp_var.get() else '0'}")
        self._send_cmd_safe(f"set bp_lo {self.bp_lo_var.get():.0f}")
        self._send_cmd_safe(f"set bp_hi {self.bp_hi_var.get():.0f}")
        self._send_cmd_safe(f"set bp_stages {int(self.bp_stages_var.get())}")
        self._send_cmd_safe(f"set eq_low_hz {self.eq_low_hz_var.get():.0f}")
        self._send_cmd_safe(f"set eq_low_db {self.eq_low_db_var.get():.1f}")
        self._send_cmd_safe(f"set eq_high_hz {self.eq_high_hz_var.get():.0f}")
        self._send_cmd_safe(f"set eq_high_db {self.eq_high_db_var.get():.1f}")
        self._send_cmd_safe(f"set comp_thr {self.comp_thr_var.get():.1f}")
        self._send_cmd_safe(f"set comp_ratio {self.comp_ratio_var.get():.1f}")
        self._send_cmd_safe(f"set comp_att {self.comp_att_var.get():.1f}")
        self._send_cmd_safe(f"set comp_rel {self.comp_rel_var.get():.0f}")
        self._send_cmd_safe(f"set comp_makeup {self.comp_makeup_var.get():.1f}")
        self._send_cmd_safe(f"set comp_knee {self.comp_knee_var.get():.1f}")
        self._send_cmd_safe(f"set comp_outlim {self.comp_outlim_var.get():.3f}")
        self._send_cmd_safe(f"set amp_gain {self.amp_gain_var.get():.3f}")
        self._send_cmd_safe(f"set amp_min_a {self.amp_min_a_var.get()}")
        self._log("All settings sent", "info")

    @staticmethod
    def _classify_log(msg, tag):
        if tag != "recv":
            return tag
        if msg.startswith(("!S ", "!K ", "!M ")):
            return "status"
        if msg.startswith("GPSDO:"):
            return "gpsdo"
        if msg.startswith("OK"):
            return "ok"
        if msg.startswith(("ERR", "[SERIAL ERROR]", "[STATUS PARSE")):
            return "error"
        if msg.startswith("WARN"):
            return "warn"
        return "recv"

    def _log_visible(self, entry):
        _, tag, msg = entry
        if tag == "status" and not self.log_show_status_var.get():
            return False
        if tag == "gpsdo" and not self.log_show_gpsdo_var.get():
            return False
        f = self.log_filter_var.get().strip().lower()
        return not f or f in msg.lower()
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
