SimonRZz/SX1280_QO100_SSB_TX/(commit log)

2026-02-24 Add CW live preview (current character/symbol/state) in GUI
2026-02-25 Add CW live preview of current character and symbol
2026-02-27 Make FT8 button visible earlier in TX tab
2026-03-01 Add external CW keying with iambic modes and device selection
2026-03-01 Add FTDI modem-line keying input selection and pin mapping
2026-03-01 Revert "Merge pull request #7 from SimonRZz/codex/implement-external-keying-and-gui-features"
    This reverts commit f5ff8667850d7137e47bc0e168d103ab83116d88, reversing
    changes made to 2ca9ce4bcdf247bb06cee2380ebf9b94c1308dbb.
    [gui.py, main.c]
2026-03-03 Add CW Keyer tab with FTDI/pyserial input and three bug fixes
    Replaces the original 3-tab gui.py with a new 4-tab version that adds
    the '⚡ CW Keyer' tab (AudioEngine, KeyReader, Keyer state machine, Morse
    decoder) and fixes three known bugs in that extension:
    Fix A – Iambic double registration: _iambic() was level-triggered
    (if dit: self._pend_dit = True on every tick while key held), causing
    extra elements after ICH completes. Fixed by adding rising-edge detection
    (_prev_dit/_prev_dah) in tick() so pending flags are set only on key-press
    transitions. ICH/IWD states now check only _pend_* instead of raw pin level.
    Fix B – GUI freeze / race condition: _cw_gui_update() (tkinter 50ms ti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
    [gui.py]
2026-03-18 fix: add missing firmware CW keyer changes and TX keying to master
    main.c: The PR #10 merge resolved in favour of master for main.c, losing all
    firmware work from the feature branch. Restored:
    - sx_start_cw_mode(with_carrier) replacing sx_test_cw()
    - New 'cwkey' command: enters CW mode without carrier (for keyer TX ON)
    - 'cw' command: enters CW mode WITH carrier (test carrier button)
    - g_cw_with_carrier flag dispatched to sx_start_cw_mode()
    gui.py: Master's new architecture (2bdf1e6) had no transmitter keying at all.
    Added on top of the new architecture:
    - Keyer callbacks now also send 'key 1'/'key 0' to SX1280 when _cw_tx_active
    - TX ON/OFF button in CW Keyer status section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
    [gui.py, main.c]
2026-03-25 feat: merge upstream v2.0.0 (OLED, encoder, dual-core) + preserve CW keyer
    Upstream v2.0.0 changes (main.c):
    - Dual-core architecture: Core0=USB+DSP+UI, Core1=radio TX at 8kHz
    - SSD1306 128x64 OLED display via I2C1 (GPIO6/7) with DMA
    - Rotary encoder (GPIO2/3/4) for standalone frequency tuning
    - Hardware PTT/KEY via GPIO5 with carrier state machine
    - Unified carrier state machine (IDLE/ARMING/ARMED/CARRIER_ON)
    - GUI live sync via !S status push on state changes
    Preserved/added (main.c):
    - g_soft_ptt_key: software PTT from CDC for GUI CW keyer
    - carrier_poll: key = hardware OR software key
    - CDC commands: key 0|1 (software keying), cwkey, hang (compat)
    GUI changes (gui.py):
    - Mode (USB/CW)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
2026-03-26 feat: finalize upstream v2.0.0 GUI features
    - LabeledScale: trace_add so TX Power label auto-updates on .set()
    - ScrollableFrame: DSP tab is now scrollable (long content on small screens)
    - Frequency entry: changed from Hz to kHz (0.1 kHz resolution, matches upstream)
    - _on_freq_slider: add _status_updating guard (no echo-loop when encoder tunes)
    - Heartbeat: _start_heartbeat() sends "status" every 2s after connect
    so GUI stays in sync with hardware rotary encoder changes
    - on_close: routes through _disconnect() to cancel heartbeat cleanly
    https://claude.ai/code/session_01DQMHP5TiWccY7DKFq2FYMY
2026-03-26 fix: add hardware_i2c and hardware_dma to CMakeLists.txt for OLED support
    Upstream v2.0.0 added SSD1306 OLED via I2C1 with DMA-driven refresh.
    These two Pico SDK libraries were missing and caused build failure.
    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
2026-03-26 fix: add ssd1306 OLED driver files missing from v2.0.0 merge
    ssd1306.h / ssd1306.c: 128x64 I2C OLED driver with DMA refresh
    CMakeLists.txt: add ssd1306.c to build sources
    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
2026-03-26 Add Keyer.set_weight() and fix weight slider, squeeze keying, CW text send, TX power default
    - Keyer: add self.weight=3.0, use it in _update_timing(), add set_weight() method
    - Keyer IEL: alternate dit/dah on squeeze based on _was_dit flag
    - GUI: CW tab weight slider (2.0–5.0) calls keyer.set_weight()
    - GUI: CW text-send entry + Send/Stop buttons with _cw_text_worker thread
    - TxConfig: default tx_power_dbm changed from 13 to 4
    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
    [gui.py]
2026-03-26 Fix CW sidetone clicks, defaults: dah=CD, 18 WPM, active-low
    AudioEngine: replace per-chunk exponential smoothing with linear ramp
    (np.linspace) across each chunk so amplitude never steps at a chunk
    boundary → no key clicks. Buffer reduced 512→256 samples (5.8 ms)
    for lower latency; ramp time 8 ms gives a clean sine attack/release.
    Defaults: dah pin CTS→CD, WPM 20→18 (Keyer + GUI), active-low on.
    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
    [gui.py]
2026-03-26 Fix CW slider label init, active-low default off
    cw_slider: label was initialized with fmt(from_) instead of fmt(var.get()),
    causing WPM/Hz labels to always show the minimum value on startup.
    Active-low checkbox now unchecked by default.
    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
    [gui.py]
2026-03-26 Fix Iambic B squeeze latch: last element not registered
    In Iambic B, _pend_dah/_pend_dit is cleared when an element starts.
    If the opposite paddle is held continuously (no new rising edge), the
    pending flag is never re-set. If the user releases the paddle just
    before IEL's level check, the element is missed.
    Fix: during DIT state, continuously latch _pend_dah if dah is held
    (and vice versa during DAH) — but only in Iambic B mode. This mirrors
    how real hardware Iambic B keyers work: the opposite paddle is latched
    at any point during the current element, not only on the rising edge.
    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
    [gui.py]
2026-03-27 feat: integrate GPSDO (SI5351 + NEO-7M) from merge-gpsdo-sketch-a6u0B
    Hardware: SI5351 52 MHz on I2C0 (GP0/GP1), NEO-7M GPS on UART1 (GP4/GP5).
    SX1280 RESET held LOW at boot until gpsdo_is_ready() — ensures the
    52 MHz reference is locked and GPS UTC is valid before RF bring-up.
    main.c:
    - #include "gpsdo.h", OPCODE_SET_FS 0xC1
    - USE_TCXO_MODULE 0 (TCXO removed, SI5351 on XTA)
    - gpsdo_init() + wait loop before SX1280 reset release; 2 s CDC heartbeat
    - 'gpsdo' CDC command for on-demand status
    - gpsdo_task() + gpsdo_status_due() periodic 10 s status in main loop
    CMakeLists.txt:
    - gpsdo.c added to sources
    - hardware_uart added to target_link_libraries
    - pico_enable_stdio_uart 1→0 (GP0/GP1 o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
    [gpsdo.c, gpsdo.h, gui.py, main.c]
2026-03-28 Move CW key inputs to GP9 (dit) and GP10 (dah) with internal pull-ups
    Replaces single PIN_PTT_KEY (GP5) with two paddle inputs:
    PIN_KEY_DIT = 9 (dit, active LOW, internal pull-up)
    PIN_KEY_DAH = 10 (dah, active LOW, internal pull-up)
    button_poll() sets g_ptt_key = dit | dah; carrier state machine unchanged.
    Resolves GP5 pin conflict introduced by GPSDO UART1 (GP4/GP5).
    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
    [main.c]
2026-03-28 Relocate ENC_OK GP4→GP10, DAH GP10→GP11; resolve GPSDO UART conflict
    GP4 was shared with GPSDO UART1 TX. GP10 was shared with KEY_DAH.
    New pin assignment:
    PIN_ENC_OK = 10 (was 4, frees GP4 for GPSDO UART1 TX)
    PIN_KEY_DIT = 9 (unchanged)
    PIN_KEY_DAH = 11 (was 10, frees GP10 for ENC_OK)
    All GPIO init and pull-up calls use the constants — no further changes needed.
    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
    [main.c]
2026-03-28 Fix QO-100 transponder LO offset: 8089.5 → 8089.4972 MHz
    Introduces named constant QO100_LO_HZ = 8_089_497_200 Hz
    to replace the hardcoded literal 8089_500_000 in the downlink
    frequency display calculation.
    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
    [gui.py]
2026-03-28 Correct QO-100 LO offset: 8089.4972 → 8089.5002 MHz
    Measured: uplink 2400.0508 MHz observed at 10489551 kHz downlink.
    LO = 10489551000 - 2400050800 = 8089500200 Hz = 8089.5002 MHz.
    Previous value (8089.4972 MHz) caused a 3 kHz display error.
    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
    [gui.py]
2026-03-28 Refine QO-100 LO offset to 8089.5001 MHz (8_089_500_100 Hz)
    Measured via FT2 signal at 400 Hz audio offset:
    uplink carrier: 2400.0475 MHz
    FT2 tone (USB): 2400.0479 MHz (carrier + 400 Hz)
    observed downlink: 10489.548 MHz
    LO = 10489548000 - 2400047900 = 8089500100 Hz
    GUI now shows carrier equivalent 10489.5476 MHz → 400 Hz tone lands
    at 10489.5480 MHz on the downlink, matching the observation.
    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
2026-03-28 Remove CW decoder display; enlarge Text-als-CW-senden section
    - Remove 'Dekodierter Text' LabelFrame and its Text/Scrollbar/Leeren widgets
    - Remove _cw_on_char, _cw_on_word_space, _cw_append_dec, _cw_clear_dec methods
    - Remove keyer.cb_char / keyer.cb_word_sp callback assignments
    - Move 'Text als CW senden' frame into the freed slot (row=3, col=1, sticky=nsew)
    so it occupies the full right column height alongside the Status frame
    - Larger Entry font (13pt) + ipady=6 for more visual height
    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
2026-03-28 Translate CW Keyer tab to English; double entry height, halve font
    All German strings in _build_cw_tab and related runtime methods
    (_cw_stop, _cw_gui_update, _start_cw_text, _cw_toggle_tx) replaced
    with English equivalents. Entry widget font 13→7pt, ipady 6→18.
    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
    [gui.py]
2026-03-28 CW tab: restore entry font, move buttons below, default mode Iambic B
    - Entry font back to 13pt / ipady 6 (original readable size)
    - Send/Stop buttons moved to row below the entry field
    - Default keyer mode changed from Iambic A to Iambic B
    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
2026-03-28 Move OLED init before GPSDO wait loop — display no longer stays dark
    OLED was initialised after gpsdo_is_ready(), so with no GPSDO module
    the screen stayed off indefinitely. Now I2C1 / SSD1306 is brought up
    immediately after SPI, showing "Waiting GPSDO.." while the GPSDO lock
    loop runs.
    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
    [main.c]
2026-03-28 Fix OLED: reduce I2C to 100 kHz, add 20 ms power-on delay
    400 kHz I2C is unreliable with Pico internal pull-ups (~50 kΩ):
    RC rise time (~2.5 µs) is too slow for 400 kHz bit period (2.5 µs),
    causing commands to be lost. Reduce to 100 kHz where rise time is
    within spec. Also add 20 ms delay after power-up before sending the
    SSD1306 init sequence, consistent with display datasheet.
    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
    [main.c]
2026-03-28 Fix iambic keyer: remove raw level check in IEL state
    In the IEL (inter-element gap) state, have_dit/have_dah were computed
    as `_pend_* or raw_level`. If the paddle is released just as the IEL
    timer fires, the raw level is still True for one tick, causing a
    spurious extra element (K = -.- becomes Y = -.--).
    Fix: use only the edge-triggered _pend_* flags in IEL, consistent
    with ICH and IWD states. The Iambic B squeeze latch during elements
    (lines 436-441, 453-455) already captures any held paddle into
    _pend_* before IEL runs, so no squeeze presses are missed.
    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
    [gui.py]
2026-03-28 Fix iambic keyer: add same-paddle capture at element end (WB4VVF style)
    The previous fix (IEL pure _pend_* check) broke hold-to-repeat because
    _pend_dit was cleared at element start and never re-set for the same
    paddle (only rising-edge detection fired it once).
    Fix modelled on WB4VVF/uSDX sticky-latch design:
    - _send_dit/dah: clear the corresponding latch at element START
    - DIT ends: if dit still held → re-set _pend_dit (hold-to-repeat)
    - DAH ends: if dah still held → re-set _pend_dah (hold-to-repeat)
    - IEL still uses only _pend_* (no raw level — that was the K→Y bug)
    Result:
    - Hold paddle → repeat (latch re-set at element end while held)
    - Release before element ends → no rep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
    [gui.py]
2026-03-29 Fix iambic keyer: clear both latches at element start (uSDX KEYED_PREP)
    Mirrors uSDX 'KEYED_PREP: keyerControl &= ~(DIT_L|DAH_L)'.
    Previously _send_dit cleared only _pend_dit and _send_dah cleared only
    _pend_dah. When IEL dispatched with both flags set, the non-dispatched
    flag persisted and triggered a spurious element in the next IEL cycle,
    causing extra dits (e.g. Q sent as extra-dit).
    [gui.py]
2026-03-29 Fix iambic keyer: add contact-bounce debounce (6 ms, 3 ticks)
    Raw GPIO input is now passed through a stable-N-ticks debouncer before
    being used for latch detection. Without this, mechanical paddle bounce
    after _send_*() cleared the latch created new spurious rising edges,
    causing extra elements — more noticeable at higher WPM.
    _prev_dit/_prev_dah replaced by _dit_stable/_dah_stable + counters;
    _iambic() receives the debounced signal on every tick.
    [gui.py]
2026-04-21 RF tab: add downlink frequency slider linked to uplink
    Adds a 'Downlink:' slider and entry field (10489.5–10490.0 MHz) directly
    below the existing uplink controls. Both sliders stay in sync:
    uplink ↔ downlink via QO100_LO_HZ offset (8089.5001 MHz).
    - _on_dl_slider(): downlink drag updates uplink vars + sends freq cmd
    - _send_dl_from_entry(): downlink kHz entry syncs uplink on Return
    - _update_freq_display(): now also syncs dl_mhz_var / dl_khz_var so
    firmware status pushes and scroll-tune keep the downlink slider current
    - Label changed from 'Frequency:' to 'Uplink:' for clarity
    - PPM and TX Power rows shifted down by one (row 4/5)
2026-09-09 Fix GPS UART starvation in CW mode
    When mode=CW is active, carrier_poll() sets g_cw_test_mode=1 and never
    clears it (need_idle = mode_cw is always true). The main loop's
    'if (g_cw_test_mode) { ... continue; }' branch therefore skips
    gpsdo_task() permanently, starving the UART FIFO within seconds:
    UTC timestamp freezes and vis drops to 0.
    Move gpsdo_task() + status push into the CW branch so the GPS UART
    is drained on every iteration regardless of CW/tune state.
    Claude-Session: https://claude.ai/code/session_01DQMHP5TiWccY7DKFq2FYMY
    [main.c]
2026-09-09 Revert "Fix GPS UART starvation in CW mode"
    This reverts commit 23e9bf01fa86a3d6f4493899b3fb806d7c55f46c.
    [main.c]
2026-09-09 Two-stage GPSDO gating: boot on SI5351 lock, block TX until GPS UTC
    The boot loop waited for gpsdo_is_ready(), which requires a GPS UTC
    timestamp. Without a satellite fix the SX1280 stayed in reset forever
    and the device looked dead — even though the SI5351 already delivered a
    usable (merely undisciplined) 52 MHz clock from the NEO-7M's free-running
    TIMEPULSE.
    Split the condition:
    - gpsdo_clock_ok(): SI5351 present, no LOS_XTAL, no LOL_A. This alone
    releases the SX1280 reset. The boot screen shows SI5351 state and
    elapsed time while waiting; SI5351 status is polled every 500 ms
    until locked, then every 30 s as before.
    - gpsdo_is_ready(): clock OK plus GPS UTC. This now only gates TX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
    [gpsdo.c, gpsdo.h, main.c]
2026-09-09 GUI: debug-friendly console, GPS gate status, firmware version display
    Console tab:
    - Every line carries a millisecond timestamp and a direction glyph
    (→ sent, ← received, · GUI info); lines are colour-classified as
    sent / OK / ERR / WARN / GPSDO / !S status / info.
    - Toggles for timestamps, !S status pushes (off by default — the 2 s
    heartbeat would otherwise flush useful history), GPSDO lines and
    autoscroll, plus a live substring filter. The console keeps its own
    5000-line buffer so filters re-render instead of losing data.
    - "Save Log…" writes the complete buffer (filters ignored) with full
    date stamps for offline analysis.
    - Command line with Up/Down history directly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
2026-09-09 Persist config in flash: freq, ppm, power, mode and DSP survive power-off
    Ported from QOkka-DSP v2.1.1 and adapted to this fork's globals.
    - persist_cfg_t (magic, version, CRC32) in the last 4 KB sector, one
    flash page. Carries g_target_freq_hz, g_ppm_correction,
    g_tx_power_max_dbm, g_tx_mode and the complete audio_cfg_t.
    TX enable, TUNE, soft key and the GPS gate stay volatile on purpose.
    - persist_load() runs first thing in main(); values are clamped and
    the DSP block goes through cfg_sanitize() before cfg_commit().
    - Every change path marks dirty: CDC freq/ppm/txpwr/mode/cwkey, all
    set/enable commands via cfg_commit(), and the encoder edits.
    - Autosave 5 s after the last change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
2026-09-09 On-device iambic keyer and click-free CW keying
    The paddles on GP9/GP11 now drive a keyer in firmware, so CW works
    without the PC. The state machine is a direct port of the GUI's Keyer
    class, which was aligned with uSDX/WB4VVF behaviour over several
    iterations: latches set only on rising edges of the debounced inputs,
    both latches cleared at element start (KEYED_PREP), same-paddle
    re-latch at element end for hold-to-repeat, Iambic B opposite-paddle
    latch during an element, Iambic A dropping released paddles at element
    end. Straight mode treats either contact as the key. The keyer is only
    live in CW mode and resets on mode change or 'stop'.
    carrier_poll() now shapes the envelope instead of s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
    [gui.py, main.c]
2026-09-09 GUI: CW tab TX toggle no longer flips the mode; keyer/paddle diagnostics
    The CW Keyer tab's TX button sent "mode usb" when switched off, which
    made sense while the PC keyer owned the mode. With the mode persisted
    in flash and an on-device keyer it silently disabled paddle keying.
    It now only sends "stop"; the mode stays whatever the user set.
    Diagnostics for paddle/keyer problems:
    - diag prints raw and debounced GP9/GP11 levels, keyer mode/state/
    latches/output, soft key, carrier state machine, current ramp power
    and the TX gate result.
    - !S carries key= (keyer|soft) and pdl= (dit|dah<<1); the GUI's
    on-device keyer panel shows "Paddle: [dit dah] Key: DOWN/up" live.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
    [gui.py, main.c]
2026-09-09 Decode on-device keying and show it in the GUI
    To verify jack keying and speed without a receiver, the firmware keyer
    now decodes what it sends: every element emits "!K e=." / "!K e=-",
    each character "!K c=<char>" after a 3-dit gap, and "!K w" after a
    further 4-dit gap (same timing as the GUI keyer used). Straight mode
    classifies elements by hold time (< 2 dits = dit). ICH/IWD states are
    decoder-only; keying is unaffected.
    GUI: the device keyer panel shows the elements of the character being
    keyed and a scrolling decoded-text box with a Clear button. !K lines
    are treated like status pushes in the console (hidden unless enabled).
    Cla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
2026-09-09 Sidetone: PWM audio on GP12 for headphones
    First audio output in the firmware. GP12 runs 10-bit PWM at sysclk/1024
    (244 kHz); a 16 kHz repeating timer writes one sample per tick from a
    256-entry sine table with a phase accumulator. Each key edge applies a
    5 ms linear envelope — the same rise time as the RF power ramp — so the
    sidetone envelope matches the transmitted signal. Idle level is
    mid-scale; the output cap in the RC network blocks the DC.
    The tone follows the on-device keyer output and the TUNE carrier, not
    the PC keyer's soft key (the PC has its own sidetone). It also sounds
    while TX is GPS-gated, which doubles as a practice mode.
    - keyer tone <300..1200>, keyer vol <0..100> (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
2026-09-09 OLED: sidetone volume in the encoder menu (replaces PPM slot)
    The 2x3 OLED menu has no free slot, and PPM correction is moot with a
    GPS-disciplined 52 MHz clock, so its slot now edits the sidetone volume
    in 5 % steps. PPM remains available via CDC and the GUI. While VOL is
    being edited the sidetone sounds continuously so the level can be heard.
    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
    [main.c]
2026-09-09 Sidetone: DMA-driven 48 kHz output, raised-cosine envelope, noise shaping
    The timer-ISR version sounded rough and hissy: USB interrupts jittered
    the sample timing, and at 16 kHz the image of a 700 Hz tone sits at
    15.4 kHz, right at the RC corner. Now a spare PWM slice (7, GP14/15 are
    plain GPIO) wraps at 48 kHz and its DREQ paces two chained DMA channels
    that write the CC register of the audio slice from 2.7 ms ping-pong
    buffers. The DMA completion IRQ refills the finished half — no
    per-sample interrupt, no jitter, images at 47 kHz.
    Envelope is a 5 ms raised cosine instead of a linear ramp (no clicks at
    the knees), and a first-order error feedback carries the 10-bit
    rounding error into th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
    [main.c]
2026-09-09 Microphone input on GP26, PC/MIC source switch, standalone boot
    Adapted from QOkka-DSP's mic feature, but with a DMA path instead of
    the upstream spin-wait inside the sample loop:
    - The ADC free-runs at exactly 8 kHz (48 MHz / 6000) and DMA writes
    the 12-bit samples into a 4 KB ring with address wrap; Core0 reads
    behind the DMA write pointer. ADC and Core1 pacing share the crystal,
    so no resampler is needed. When src=mic the producer waits for a full
    block of mic samples while keeping USB/UI/keyer serviced, and bails
    out cleanly if mode or source change meanwhile.
    - Mic DSP: one-pole DC removal, gain (1..50), noise gate with
    hysteresis, 300 ms hold and a smoothed gate gain so it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
    [gui.py, main.c]
2026-09-09 diag: show raw encoder A/B/SW levels and UI state
    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
2026-09-10 Scrollable encoder menu replaces the 2x3 tile UI
    Every runtime parameter is now reachable on the device. Modelled on
    QOkka-DSP's menu, adapted to this fork's parameters and kept in the
    existing IDLE/BROWSE/EDITING state machine.
    Tune screen (IDLE): turn = frequency by the selected step, short click
    = cycle step 100 Hz / 1 kHz / 10 kHz (underline marks the digit),
    hold 500 ms = menu. Below the frequencies three status rows replace
    the tiles: mode/source + TX state + power, WPM/volume/GPS, step and
    unsaved marker.
    Menu (BROWSE/EDITING): 16 rows, 6 visible, scrolls with the cursor.
    Mode, TX, Tune, Power, Step, Keyer, WPM, Dah ratio, Sidetone, Volume,
    Mic gain, Mic gate, PPM, GPS gate, Save, E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
    [main.c]
2026-09-10 Revert "Scrollable encoder menu replaces the 2x3 tile UI"
    This reverts commit 830ae62b41c73dbd9a9934a352302e26c982cf71.
    [main.c]
2026-09-10 OLED: three pages below the frequency — operating, CW/audio, GPS/time
    The frequency rows stay on every page; a long press (500 ms) cycles
    the lower half. Pages 0 and 1 keep the proven 2x3 tile interaction
    (short click = browse, click = edit), page 2 is display only.
    - Page 0: Mode, Tune, WPM | TX, Volume, Power (unchanged)
    - Page 1: Keyer mode, Dah ratio, WPM | Sidetone pitch, Mic gain,
    Mic gate. Pitch sounds while being edited, like Volume.
    - Page 2: date, locator, UTC as HH:MM in 2x font, sats used/visible,
    fix, altitude. Short click returns to page 0.
    gpsdo: parse the RMC date field and add gpsdo_get_info() so main.c
    gets formatted time/date/locator/fix values without going throug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
    [gpsdo.c, gpsdo.h, main.c]
2026-09-10 Service the GPS UART in every wait loop
    With the mode persisted, the device can boot straight into CW mode.
    The CW branch of the main loop never reached gpsdo_task(), so the
    32-byte UART FIFO overflowed within milliseconds and no NMEA sentence
    was ever parsed: 0 satellites, no fix, TX gate never released.
    gpsdo_task() (drain + parse, cheap) now runs in the CW branch, the
    mic wait loop, the boot USB wait loop and the free-block wait loop, so
    the FIFO is drained in every operating state. The periodic status
    line is pushed from the CW branch as well.
    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
    [main.c]
2026-09-10 Sidetone survives flash writes; readable GPS page
    Autosave produced a loud click/whine: flash_safe_execute() blocks IRQs
    for ~20 ms, the sidetone DMA chain kept running, and without the
    refill IRQ the re-triggered channel continued from the END of its
    buffer into whatever RAM followed. The read address now wraps in
    hardware (512-byte ring per half, buffers 512-aligned), so a late IRQ
    only replays the last 5 ms of audio — silence when idle. The manual
    read-address reset in the IRQ is gone (it could also jump the pointer
    mid-transfer when the IRQ ran late). Autosave additionally waits while
    the test tone is on.
    Page 2 layout: the date row touched the 2x clock. Clock now sits at
    y 32..47 on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
    [main.c]
2026-09-10 Fix extra elements above ~23 WPM, smoother sidetone, 10 Hz pitch steps
    Paddle debounce was a lockout filter: any edge arriving 5 ms after the
    last accepted one was taken. A bounce train therefore delivered a
    second rising edge, which the keyer latched as an extra pending
    element — increasingly audible above ~23 WPM, where one dit is only
    ~50 ms. Replaced by a stability filter: a level is adopted only after
    it has been unchanged for 4 ms, and any bounce restarts the timer.
    Kept symmetric and short on purpose — a longer release filter (as
    upstream uses for its raw PTT) would still read "pressed" at element
    end and fire a spurious hold-to-repeat, making the symptom worse.
    tx_mode_guard_act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
    [gui.py, main.c]
2026-09-11 Keyer: decide hold-to-repeat at the end of the space, not the element
    Double dits persisted after the debounce fix because the same-paddle
    level was sampled at element END. At 23 WPM an element is 52 ms, a
    normal tap 60-100 ms — so the paddle was still down at element end and
    a second dit was queued even when it was released during the following
    space. Standard keyers (Curtis, K1EL) sample at the end of the
    inter-element space, giving dit + space (~100 ms) to let go.
    Firmware and the GUI keyer changed the same way. Edge-latching during
    the element/space (memory for squeezes and quick taps) and the Mode A
    release rule are unchanged. Verified with a tick-level simulation of
    the GUI class: 7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
    [gui.py, main.c]
2026-09-12 Blink on lost GPS fix, keep autosave off the air, rotatable display
    GPS: gpsdo_is_ready() latches on purpose — the SX1280 keeps running on
    the then free-wheeling TIMEPULSE — so a lock lost later was invisible.
    gpsdo_signal_lost() reports "had a fix, none for 10 s". The separator
    line flashes as a bar on the tile pages, the TX tile alternates to
    "GPS LOST", and the GPS page swaps its bottom row for a warning.
    Frequency accuracy degrades to the NEO-7M's own oscillator in that
    state, so it is worth noticing.
    Autosave: previously only TUNE, key and test tone blocked it, so a
    flash write could land between two CW elements or during an SSB block
    and freeze the SX1280 for ~20 ms mid-transmissi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
    [gpsdo.c, gpsdo.h, main.c]
2026-09-13 Report a lost GPS fix over CDC, not just on the OLED
    The GUI kept showing "GPS signal stable" next to "No position fix":
    the sig field only asked whether GGA sentences were still arriving,
    and the NEO-7M keeps sending those without a fix. The lost state added
    in the previous commit existed only in the OLED path.
    gpsdo_format_status() now folds gpsdo_signal_lost() into sig (new
    value "lost", checked before "stable") and appends an explicit
    lost=0|1 field. The stale case is reworded to what it means — no data
    from the receiver at all.
    GUI: parses lost=, shows "GPS SIGNAL LOST — reference drifting" in red
    in the GPSDO tab, turns the fix row red, and puts a matching banner in
    the connectio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
    [gpsdo.c, gui.py]
2026-09-13 README for v2.2.0; release version string
    The README still described SP8ESA's v2.0 base: no GPSDO, OLED, encoder,
    keyer, microphone or sidetone, and it claimed an automatic carrier mode
    that no longer exists. Rewritten around what the firmware actually does,
    with the GPIO map, the headphone network, the full CDC command set,
    standalone operation and a changelog entry for this fork's work.
    Attribution to SP8ESA for the SSB/DSP core and CT2GQV for the GPSDO
    principle is kept and made explicit.
    FW_VERSION 2.2.0-dev -> 2.2.0.
    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
    [main.c]
2026-10-03 Keep the display alive in microphone mode
    Selecting USB MIC made the device look frozen: the OLED stopped updating
    and the GUI stopped receiving !S status lines, although the encoder and
    keyer kept working.
    Both calls lived only inside the "wait for a free block" loop. In PC mode
    the producer runs ahead of Core1, so that loop spins constantly and the
    display refreshes. In MIC mode the producer is paced by the ADC at
    exactly the 8 kHz rate Core1 consumes, so it never gets ahead, the loop
    almost never executes, and the refresh starved.
    Extracted ui_service() (OLED + status push, internally limited to 5 fps
    and skipped while the previous DMA transfer runs) and call it from every
    wait loop: th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
    [main.c]
2026-10-03 SSB push-to-talk on GP13; switching to MIC no longer keys the radio
    SSB has no PTT: the carrier follows the audio amplitude, with g_tx_enabled
    defaulting to on. With a microphone wired that is permanent VOX — selecting
    USB MIC started transmitting immediately on room noise.
    - PIN_PTT on GP13, active LOW with pull-up, debounced by the same stability
    filter as the paddles.
    - ssb_ptt_blocks() gates the producer's tx_on while the source is MIC and
    the switch is not held. PC audio is never gated, so WSJT-X and similar
    keep working without a hardware switch.
    - "ptt 0|1" turns the requirement off/on, default on. Persisted in a spare
    byte of the reserved block, encoded as value+1 so an ol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
    [gui.py, main.c]
2026-10-03 Use the CW paddle as the SSB push-to-talk instead of a separate pin
    The dedicated switch on GP13 is gone. In SSB the keyer is inactive —
    keyer_poll() returns early unless g_tx_mode == 1 — so the paddle has no
    other job there and can serve as the press-to-talk lever. Either contact
    counts (dit, dah or both), which is already what g_ptt_key holds, and a
    straight key on the tip works too.
    That removes a pin, a debounce block and a piece of wiring: the jack is
    already there for CW. GP13 is free again.
    Behaviour is otherwise unchanged: the requirement applies to MIC only, PC
    audio is never gated, "ptt 0" restores VOX, and the OLED TX field shows
    "PTT" while transmission is held back.
    Co-Au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
2026-10-03 Stop truncating long CDC output
    The 'get' output arrived mangled: lines cut mid-word and the next
    command's text spliced onto them, e.g.
    src=pc mic_gain=10.0 enable bp=1 eq=1 comp=1
    comp_thr=... makeup=0.0CFG:
    amp_gain=2.900 a!S mode=0 ...
    tud_cdc_write() only accepts what currently fits in the 512-byte TX
    FIFO and reports how much it took; the remainder was dropped. Nothing
    retried it, so anything past the FIFO was simply lost — cfg_print()
    emits roughly 600 bytes, and mic_gate and ptt fell off the end.
    cdc_write_str() now pushes the remainder as the host drains it,
    flushing and pumping tud_task() between attempts, bounded to 50 ms so a
    stalled host cannot hold up the radio (a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
    [main.c]
2026-10-03 Split cfg_print so 'get' stops losing its tail
    The FIFO retry in #17 fixed diag, but 'get' still arrived cut at
    "mic_gain=1" and "amp_gain=2.900 a" — both exactly 255 characters in.
    Different cause: cdc_printf formats into a 256-byte stack buffer and
    vsnprintf truncates at the limit. cfg_print emitted its output as two
    calls of roughly 260 and 275 characters, so each lost its tail — and
    mic_gate and ptt sat in the part that fell off.
    cfg_print now emits one line per call, none of which comes close to the
    buffer. cdc_printf also checks vsnprintf's return and appends
    "[line truncated]" when a caller overruns, so this fails loudly instead
    of silently dropping text.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
    [main.c]
2026-10-03 Report what is actually in the config sector
    A user sees "Config: compile-time defaults (nothing valid in flash)"
    on every boot, although an earlier build had restored settings and the
    record layout did not change in between. There was no way to tell a
    failing write from a mismatching record, so diag now prints the sector
    contents and the save history:
    Config: offset=0x003ff000 size=116 flash_size=4194304
    Config: magic=.../... ver=.../... crc=.../... VALID|INVALID
    Config: loaded=.. dirty=.. saves=.. last_rc=.. (0=ok)
    That separates the candidates: a wrong offset for the board, a record
    that was never written, a layout or CRC mismatch, or flash_safe_execute
    failing (last_rc != 0, e.g.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
    [main.c]
2026-10-03 Document that flashing clears the saved settings
    Chasing a reported "settings are not persisted" turned up no fault: a
    power cycle keeps the record (same CRC, values restored, saves=0), but
    every .uf2 update erases the config sector along with the rest of flash,
    so the device comes up on defaults. Worth stating, since it looks exactly
    like broken persistence.
    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
2026-10-04 Live microphone level meter
    Setting the mic gain was guesswork: diag only shows a snapshot of the
    gate envelope, which decays in about 0.2 s, so hitting it while talking
    is near impossible.
    The firmware now tracks the peak of the gained signal and emits
    "!M pk= env= thr= gate=" every 100 ms, but only while the microphone is
    the source, so it costs nothing in PC or CW mode.
    The GUI draws it in the Audio source panel: a bar with peak hold, a
    marker for the noise-gate threshold, the level in percent and whether
    the gate is open. The bar turns orange past 80 % and red at full scale,
    which is what the gain should be set below. !M is classified like the
    other machine lines, so the console hides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
    [gui.py, main.c]
2026-10-21 Add the Si4732 receive driver (stage R1)
    First stage of the QO-100 receive path: the demodulator and its control
    interface. No audio into the Pico yet — you listen on the Si4732's own
    output, which keeps "does the receive hardware work" separate from "does
    the audio path work".
    The chip shares I2C0 with the SI5351 and needs only two new pins, RST on
    GP13 and later ADC1 on GP27. Nothing existing moves.
    Three things a bare 16-pin chip needs that a module hides:
    - The control-bus mode is latched from GPO1/GPO2 on the rising edge of
    RST, and SCLK must be high across that edge. Since the SI5351 shares
    the bus, si_hw_reset() takes GP1 away from the I2C block and drives it
    high by hand;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
2026-11-02 Generate the receive mixer LO on SI5351 CLK0
    144 MHz from PLL B, whose 5th harmonic at 720 MHz is the downconverter's
    local oscillator. PLL B and CLK0 were both unused — PLL B was never
    written at all and CLK0 was actively powered down — so this costs no
    hardware and no pins.
    PLL B: 24 MHz x 36 = 864 MHz, p1=4096
    MS0: 864 / 6 = 144 MHz, p1=256
    Both integer, and the divider is even. That matters here more than it
    does for CLK1: taking the 5th harmonic also multiplies the phase noise
    by 20*log10(5) = 14 dB, which leaves no room for a fractional divider.
    144 MHz is in fact the only frequency near the target that PLL B reaches
    integrally, since 720/144 = 5 is not a legal MultiSynth v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
2026-11-02 Calibrate out the LNB oscillator error, and tune in hertz
    The Bullseye LNB cannot be GPS-disciplined: the 25 MHz on its red
    connector is an output, and the manufacturer confirms the frequency is
    fixed. So the receive side has no reference to lock to, and the LNB's
    TCXO — ±2 ppm, about ±10 kHz at room temperature and ±30 kHz over the
    full range — sets the frequency error for the whole chain. That error
    lands directly in the IF.
    "rx cal <Hz>" stands in for the discipline. It is defined as the amount
    by which everything arrives HIGH of where it should, which is what you
    read straight off the beacon: the lower QO-100 beacon at 10489.500 MHz
    should appear at 739.500 MHz behind a 9750 MHz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
2026-11-02 Mark the receive branch as 2.3.0-rx
    The console reported 2.2.0 for both the released transmitter firmware and
    this branch, which has already caused one round of confusion about which
    build was actually on the device. 'version' now distinguishes them.
    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
2026-11-02 Move the mixer LO from CLK0 to CLK2
    The filter is wired to CLK2 on the board, so the firmware follows the
    hardware rather than the other way round. Electrically the two outputs
    are interchangeable: both sit next to CLK1 on the package and either can
    be driven from PLL B, so this is MS2 instead of MS0 and register 18
    instead of 16. CLK0 is now the one left powered down.
    Output enable needed care. The bits are active low, bit 0 = CLK0,
    1 = CLK1, 2 = CLK2, so enabling CLK1 and CLK2 is 0xF9 and not the 0xFC
    that enabled CLK1 and CLK0. All three constants were decoded back from
    their hex values before committing, together with the three control
    registers: CLK1 at 4 mA from PLL A, CLK2 at 8 mA fr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
2026-11-03 Keep the mixer LO off until asked for
    CLK2 came up enabled in gpsdo_init(), which runs before the boot gate
    that waits for a locked 52 MHz. Anything wrong on that line could
    therefore stop the transmitter from starting: stray DC from an amplifier
    module into the output pin, a supply droop from the extra 8 mA, or
    144 MHz coupling into the 24 MHz reference on XA. The receive side must
    never be able to prevent the radio from booting, so CLK2 now starts off
    and "lo 1" turns it on.
    This costs nothing. MS2 and CLK2_CTRL are still configured during init,
    so enabling the output only flips the output-enable bit and PLL B is
    already locked by then.
    Reported as the transmitter suddenly showing "waiti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
2026-11-03 Document the IF low-pass, which the design was missing
    A double balanced mixer leaks its local oscillator into the IF port, and
    the wiring notes never accounted for it. With -5 dBm at the LO port and
    the 20 to 30 dB of LO-to-IF isolation these mixers have, 720 MHz arrives
    on the IF line at -25 to -35 dBm. The beacon is around -84 dBm, so the
    unwanted signal is 49 to 59 dB stronger than the wanted one.
    That is fatal twice over: any AGC locks onto the leak, and an 8-bit SDR
    spans only about 48 dB, so the beacon falls into quantisation noise. On
    the bench nothing below roughly -55 dBm at the IF was audible, with the
    AGC switched off — a dynamic-range limit, not a sensitivity limit, which
    is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
2026-11-03 Add a handover document for the receive branch
    Written for someone picking this up cold: the frequency plan with its
    reasoning, the clock distribution, the wiring, the measurement log, and
    the build steps.
    Three sections matter more than the rest. What we are currently stuck
    on, with the diagnosis and the fix that is designed but not yet built.
    The mistakes already made, ten of them, so they are not repeated -
    several cost an evening each. And the unverified assumptions, separating
    what was measured from what was assumed, since mixing those up is what
    produced most of the mistakes.
    Claude-Session: https://claude.ai/code/session_01DQMHP5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
2026-11-06 Add an I2C bus scan for first contact with the Si4732
    "i2c" walks 0x08 to 0x77 on both buses and names what it recognises.
    Written for the moment the Si4732 is wired up for the first time, where
    the useful question is not whether that chip answers but whether the bus
    works at all: the SI5351 showing up at 0x60 while nothing appears at
    0x11 or 0x63 says the wiring is good and the fault is at the Si4732
    itself — reset, the GPO1/GPO2 bus-mode latch, or its supply. Nothing
    answering at all points at pull-ups or pins instead.
    It also resolves the open question about SENB polarity by observation
    rather than from the contradictory datasheets, and 0x63 is labelled as
    ambiguous because the SI5351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
2026-11-06 Generate the Si4732 reference clock on CLK0 too
    The 25 MHz for the Si4732's RCLK pin was going to come from the second
    GPSDO on the Pro Micro, which is purely historical: that board was built
    to feed the LNB a 25 MHz reference, and the Bullseye turned out to be
    unable to accept one. Taking it from the Pico's SI5351 instead drops the
    second board out of the receive chain entirely — no second GPS needing
    a fix, no second antenna, and both receive-side clocks documented and
    switched in one place.
    CLK0 was unused and powered down. PLL B is already running at 864 MHz
    for the mixer LO, and 864 / (34 + 14/25) = 25.000000 MHz exactly, so
    this needs no new PLL. The MultiSynth is fractional, which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
2026-11-06 Swap the two receive-side clocks: LO to CLK0, reference to CLK2
    Which signal sits on which output follows the board. CLK0 now carries
    the 144 MHz mixer LO at 8 mA through the integer divider 6, and CLK2 the
    25 MHz Si4732 reference at 2 mA through the fractional 34+14/25. Both
    still from PLL B, both still off at boot, and "lo" and "rclk" keep
    meaning what they did.
    Swapped in one pass: the two control registers (0x6F and 0x2C trade
    places), the two MultiSynth register sets, the two output-enable bits,
    and the names in gpsdo.h, the help text, the console replies and
    WIRING.txt.
    Decoded back from the register bytes afterwards: PLL B 864 MHz / 6 =
    144.000000 MHz on CLK0 in integer mode at 8 mA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
2026-11-06 Stop treating a silent bus as a ready chip
    A one-byte read from an I2C bus nothing is driving returns 0xFF, because
    the pull-up holds SDA high. Bit 7 of that is set, and the CTS check was
    "bit 7 of the status byte", so every wait succeeded against a device that
    was not answering at all. That is how a patch upload reported 1979
    successful 8-byte blocks into a chip whose GET_REV came back as
    part number 0 — the writes were never acknowledged in any meaningful
    sense, and the first failure surfaced much later as "I2C write failed"
    from a property write, with nothing pointing at the real cause.
    si_wait_cts() now rejects 0xFF: no genuine status has CTS, ERR and every
    other bit set at once.
    si4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
2026-11-06 Replay the boot log when the console connects
    si4732_init() runs during boot, long before anyone opens a terminal, and
    cdc_printf discards what it cannot deliver. So the receiver's whole init
    report — which address answered, what GET_REV returned, why it refused —
    went nowhere, and a boot log that showed the GPSDO and the SX1280 coming
    up carried no sign the Si4732 had even been probed.
    Lines now go into a 16-entry buffer until the console is there, and the
    greeting replays them between the config banner and cfg_print, counting
    anything that overflowed. Nothing changes once a terminal is attached.
2026-11-06 Read GET_REV after power-up, not before
    The revision check ran straight after reset, while the chip was still
    powered down. In that state it answers with a valid status byte and an
    empty payload — observed on the bench as
    "80 00 00 00 00 00 00 00 10": CTS set, ERR clear, a chip revision in the
    last byte, and nothing in between, because its internal controller is
    not running yet. The previous commit turned that into a hard failure and
    so declared a working chip dead.
    GET_REV now happens in si_read_rev(), called after POWER_UP and after
    the patch upload, where the part number means something. init() only
    probes the address and says plainly that the revision read is deferred.
    Reading it aft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
2026-11-06 Report the whole RSQ response, not just the two levels
    The byte offsets were right — RSSI is RESP4 and SNR RESP5, checked
    against the library's response struct, so rssi=0 on the bench is an
    honest answer and not a decoding mistake. But the read stopped at six
    bytes and threw away the three most useful fields while hunting for a
    signal: VALID says whether the chip considers itself on a real channel,
    AFCRL whether the AFC has railed, and RESP7 carries a signed frequency
    offset in kilohertz. Soft mute comes along from the same byte.
    "rx diag" now shows all of them. With a beacon up to 30 kHz away from
    where the LNB puts it, an offset the chip measures itself is worth more
    than sweeping by ha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
2026-11-06 Wait for the tune to complete before believing the level readings
    The tune command is acknowledged as soon as the chip has taken it, which
    is long before the tuner has settled. Until then RSSI and SNR read zero
    — indistinguishable from "no signal", and that sent us looking at the
    antenna, the mixer and the input network for something that was a
    missing wait. A fixed 30 ms sleep stood in for it and was not enough.
    si_tune() now polls GET_INT_STATUS for the seek/tune-complete flag with
    a 250 ms budget, then reads AM_TUNE_STATUS, which hands back the
    frequency the tuner actually went to along with VALID and AFCRL. A
    mismatch between what was asked for and what came back is reported, and
    so i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
2026-11-06 Make the reference clock drive strength settable at runtime
    The chip answers on I2C, reports part 32 and firmware 1.0, takes
    commands — and will not tune: "tune did not complete" and 0 kHz read
    back. That is a reference-clock symptom, not a signal one.
    The register side is now verified rather than assumed: AN332's SSB
    amendment supports RCLK from 31130 Hz to 40 MHz, so 25 MHz is in range,
    and 25 MHz / 800 = 31250 Hz sits inside the 31130-34406 Hz REFCLK
    window. Prescaler 800 with RCLKSEL = 0 selects the RCLK pin. Nothing
    there is wrong, which leaves the level at pin 13.
    "rclk drive 2|4|6|8" sets the IDRV field of CLK2_CTRL without a reflash,
    so the level can be found on the bench instead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
2026-11-06 Default the reference clock to 8 mA; the divider was wrong
    Settled on the bench. At 2 mA the Si4732 answered on I2C, reported part
    32 and firmware 1.0, accepted commands, and would not tune: "tune did
    not complete" with 0 kHz read back from AM_TUNE_STATUS. Raising CLK2 to
    8 mA fixed it at once — tune complete, the requested frequency read
    back, and real RSSI readings around 43 dBuV.
    So CLK2_CTRL starts at 0x2F instead of 0x2C, and WIRING.txt no longer
    asks for the 1 kOhm / 220 Ohm divider: coupling capacitor only, 1 nF for
    margin. That divider came from a "0.3 to 1.5 V" input range I recalled
    from AN332 and never checked, which turns out to describe a crystal-style
    input fed with a sine w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
2026-11-06 Follow the reference library's SSB sequence
    In AM the receiver tunes and reports real levels. Switch to USB and the
    patch uploads, GET_REV confirms patch id 0x9D29, and then everything
    after that fails: no seek/tune-complete, the read-back frequency zero,
    and the RSQ read refused. The patch lands; what follows it was wrong.
    Four changes, each taken from the reference library or the data sheet
    rather than chosen:
    The FAST bit is gone from the SSB tune. The data sheet says of it
    "executes fast and invalidated tune. The tune status will not be
    accurate" — which is exactly the symptom. A tune a few milliseconds
    slower that reports honestly is worth more.
    SSB_MODE now matches setSSBConfig(bw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
2026-11-06 Make the POWER_UP crystal-oscillator bit switchable
    The fault is now isolated: in AM the receiver tunes, reports 9600 kHz
    back and reads rssi 43. Switch to USB and the patch uploads, its id is
    confirmed, every command is acknowledged, last error stays none — and
    the tuner reports 0 kHz with no seek/tune-complete. Bus and reference
    clock are therefore not at fault; the SSB path itself does not tune.
    One documented difference remains between this sequence and the known
    working one: the reference library powers up with XOSCEN = 1 and calls
    it "a condition for loading the patch", while this driver uses 0, which
    is what an external clock on RCLK calls for and what AM tunes with
    quite happily.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
2026-11-06 Make the antenna tuning capacitor settable
    Every tune sent ANTCAP = 0, which lets the chip tune its own varactor.
    Silicon Labs recommends that, and it is right for a medium-wave
    loopstick, where there is an inductance to resonate against. A 20 cm
    wire at 9.6 MHz has none, and neither does a 50 ohm feed from a mixer,
    so the auto-tuner has nothing to work with.
    "rx antcap 0..6143" sets it; the capacitance is 95 fF x ANTCAP + 7 pF,
    so 1 is about 7.1 pF. It travels with the tune command, so setting it
    retunes. Default stays 0.
    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
2026-11-06 Warn when the crystal-oscillator bit is left on
    Setting xoscen=1 switches on the chip's crystal amplifier between pins
    13 and 2. This board has no crystal there and feeds RCLK externally, so
    the amplifier works against that clock and the reference collapses —
    after which nothing tunes, AM included.
    That cost a round of "AM has stopped working too" and a bisect against
    the last known-good build, which found gpsdo.c byte-identical and no
    change in the driver capable of touching AM. The switch had simply been
    left on from the experiment.
    It stays switchable, since it is the one documented difference from the
    reference library's sequence, but now says plainly what it does and how
    to undo it.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
2026-11-06 Say "not powered up" instead of printing an empty revision
    With the receiver probed but not started, diag printed part=0, chiprev
    0x00, "GET_REV raw (READ FAILED)" and a tuner reporting 0 kHz. All of
    that is correct for a chip that has not been powered up — and all of it
    reads as a dead chip. It sent us down a wrong path twice in one evening,
    once right after a reflash.
    That state now says so in one line and names the command to fix it,
    followed by the clock configuration and the stored settings, which are
    the only things that mean anything before power-up.
    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
2026-11-09 Build PLL B only when the receive side is asked for
    The transmitter started hanging at "SI5351: PLL unlocked" — sporadically
    at first, then on every boot. PLL A is the SX1280's only clock, and the
    timing matches when PLL B was added: gpsdo_init() had grown from
    configuring one PLL and one MultiSynth to two PLLs and three, all before
    the boot gate that waits for a locked 52 MHz. That costs supply current
    on a 3V3 rail already carrying the OLED, the GPS, the microphone
    amplifier and now the Si4732, and PLL A is fractional, which does not
    help.
    The boot path is now byte-for-byte what it was before any of the receive
    work: outputs off, CLK0 and CLK2 powered down, CLK1 control, crystal
    load, P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
2026-11-09 Report why a tune failed instead of blaming the calibration
    "rx freq 19450" answered "19450.000 kHz is outside the band once the
    +0 Hz calibration is applied". With the offset at zero and the band
    running from 2300 to 26100 kHz, nothing about that is true: the range
    check had already passed and the failure came from the tune itself. The
    message was hard-coded to one of the several reasons si4732_tune_hz can
    return false, and wrong for all the others — twice now it has pointed
    away from the real fault.
    It now prints the driver's last error, and mentions the calibration
    offset only when there is one. si4732_last_error() exposes it.
2026-11-09 Say when a setting was stored into a powered-down receiver
    Every rx setting command answers through rx_status_print, and each one
    said "OK" while the chip was off. Freshly flashed, the receiver starts
    powered down, so a session could set the antenna capacitor, the
    frequency and the bandwidth, get an acknowledgement for each, and hear
    nothing — with on=0 sitting in the status line the whole time, easy to
    read straight past.
    It now adds a line naming the command that starts the receiver.
    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
2026-11-09 Add "rx scan" so the transponder can be found at all
    Searching by hand does not work. Two reads of the same frequency, taken
    seconds apart, gave rssi 64 and then 0: with no carrier the AGC chases
    noise, and a single reading carries no information. Thirteen frequencies
    typed in one at a time, one reading each, is a measurement that cannot
    succeed, and that is what the last two sessions were spent on.
    "rx scan [from] [to] [step]" sweeps and prints a table, every point the
    mean of eight reads with the peak beside it and a bar to compare by eye.
    Defaults are 19400 to 20100 in 50 kHz steps, which covers the planned IF
    plus the ±30 kHz the Bullseye's TCXO can be off by. It restores the
    previous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
2026-11-09 Read the front-end AGC, and allow a 36 MHz reference
    Two measurements on the bench narrowed the receive problem to one of two
    causes, and nothing in the firmware could tell them apart.
    Switching the mixer LO off left all three candidate signals standing
    (19484, 19760 and 20000 kHz, unchanged within a decibel), so none of
    them comes through the mixer and none is a transponder beacon. Their
    spacings are 276 and 240 kHz where the beacons are exactly 250 apart.
    With the LO on, the noise floor at 19.8 MHz is 19 dBuV; with it off, 15.
    The converted LNB noise is therefore about equal to the receiver's own,
    where it should be fifteen to twenty decibels above it. Either the front
    end has been turne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
2026-11-09 Say when the receiver has no clock instead of reporting zeros
    A bench session was spent concluding the Si4732 was deaf. It was not:
    SI5351 CLK2 was off.
    The part has no crystal. With no reference on pin 13 it still answers on
    I2C, still reports its part number and firmware revision, still accepts
    POWER_UP and the SSB patch, and still acknowledges a tune — it simply
    never completes one. The tuner then reads back 0 kHz and every level
    reads 0, which from the outside is indistinguishable from a dead
    antenna. "rx diag" printed "last error: none" over the top of it.
    So:
    - A tune that never raises the seek/tune-complete flag now sets an
    error naming the reference clock, rather than leav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
2026-11-09 Put the receiver in the headphones, with an audio AGC
    Stage R2a. Until now the Si4732's audio pin drove nothing: you listened on
    it directly with an amplified speaker, while the device's own jack carried
    only the transmit sidetone.
    rx mon [0|1] receiver into the headphones
    rx mon vol <0..100> level
    rx mon agc [0|1] audio AGC, on by default
    Signal path: LOUT -> GP27 (ADC1) -> levelled on core 0 -> a 256-sample ring
    -> the sidetone's DMA interrupt interpolates 8 kHz up to 48 kHz and adds it
    to the PWM. So the headphone wiring does not change at all; the single new
    connection is the one WIRING.txt already specified for ADC1.
    The AGC turns down fast (50 ms) and comes bac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
2026-11-09 Pump the monitor's producer during "rx scan"
    Each probe point parks in si4732_probe_khz for tens of milliseconds, so
    none of the main loop's service points are reached and the monitor's ring
    runs dry. An 18-second sweep took the underrun counter from 72 to 151769 —
    every single fetch, for the whole sweep.
    The audio still breaks up while a sweep runs, because the tuner is hopping
    and there is nothing coherent to hear anyway. But the ring no longer empties
    completely, the counter stays meaningful as a health figure, and the monitor
    recovers when the sweep ends without needing a resync.
    Claude-Session: https://claude.ai/code/session_01DQ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
2026-11-09 Tune the receiver from the encoder, on a page of its own
    A fourth page, reached by holding the button. On it the top two rows drop
    the uplink/downlink pair - that belongs to the transmitter - and show where
    the receiver is, in what mode, through which filter, with RSSI and SNR. The
    dial tunes the receiver there, so it always means "the frequency you are
    looking at".
    Tiles: step, mode, bandwidth, monitor level, Si4732 level, audio AGC.
    Steps are 10 Hz, 100 Hz, 1 kHz, 5 kHz, 9 kHz. 10 Hz is what SSB needs and
    9 kHz is the channel spacing of the broadcast bands outside the Americas;
    anything of 1 kHz or more snaps to its own grid, so one stray 10 Hz nudge
    does not leave you permanently betwee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
2026-11-09 Let "rx scan" sweep a whole band, not 64 points
    The cap was chosen when a sweep meant a handful of points around a known
    frequency. Hunting an unknown one wants a band at the resolution of the
    channel filter, and 64 points cannot express that: 19300 to 20200 in 2 kHz
    steps is 451.
    512 now. Each point is eight averaged reads at roughly 0.3 s, so a full one
    runs about two and a half minutes - long, but it is the user who asked for
    it, and splitting the same sweep into seven commands costs more.
    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
2026-11-09 Add "rx ssbtest": walk the SSB bring-up one command at a time
    What is known: after an SSB tune the chip stops answering CTS. AM on the
    same hardware is fine, and a plain POWER_UP into AM brings it straight back
    with no hardware reset - so it is not a crash and not a latched brownout,
    but a state that one command in this sequence puts it into. It is alive
    after the patch upload, because GET_REV reads the patch id back. Everything
    between that point and the end of the tune is unexamined.
    So examine it. Reset, power up, patch, revision, each property, the tune by
    hand, then the status byte after every single step.
    The status byte carries more than CTS: bit 6 is ERR, which the part sets
    when i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
2026-11-09 SSB works; the read-back added to diagnose it was breaking it
    "rx ssbtest" walked the whole bring-up one command at a time:
    after POWER_UP status=0x80 ok
    after patch status=0x80 ok
    after GET_REV status=0x80 ok
    after PRESCALE status=0x80 ok
    after REFCLK_FREQ status=0x80 ok
    after SOFT_MUTE status=0x80 ok
    after SSB_MODE status=0x80 ok
    after VOLUME status=0x80 ok
    after BFO status=0x80 ok
    10 ms after tune status=0x80 ok
    100 ms after tune status=0x80 ok
    500 ms after tune status=0x80 ok
    TUNE_STATUS: 0 -> 0 kHz
    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
2026-11-09 Keep AM-only commands off the bus once the SSB patch is running
    The SSB diagnosis is missing its agc line, and the RSQ read right behind it
    is dead with no error of its own. That is the TUNE_STATUS shape again:
    AM_AGC_STATUS (0x47) is an AM command, the patch does not answer it, and
    whatever follows finds a chip that has stopped talking until the next
    power-up.
    So 0x47 is not sent in sideband, "rx diag" says why instead of silently
    dropping the line, and "rx agc" refuses with the reason rather than killing
    the receiver the user is listening to.
    Whether RSQ (0x43) survives in SSB is now testable on its own, which it was
    not while an AM command ran ahead of it in the same report.
    Co-Authore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
2026-11-09 Add "rx raw": ask the chip directly instead of guessing
    Reading the response in one transaction did not fix it either - the status
    byte simply never carries CTS after an SSB tune, however it is read. That is
    five theories tonight (the FAST bit, the patch, XOSCEN, the supply, the
    polling, the transaction shape), each costing a build and a flash, and the
    questions that remain are all of the same shape: does this command want a
    different argument, or a different response length? The reference library
    reads five bytes for AM_RSQ_STATUS where this driver reads eight.
    Those are bench questions, not design questions, and they do not deserve a
    firmware cycle each.
    rx raw <resp_bytes> <hex> [hex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
2026-11-09 SSB needs the FAST bit, and the reference library proves it
    Stopped guessing and read pu2clr's SI4735.cpp. setFrequency():
    if (currentSsbStatus != 0) {
    currentFrequencyParams.arg.USBLSB = currentSsbStatus;
    currentFrequencyParams.arg.FAST = 1; // "Used just on AM and FM"
    currentFrequencyParams.arg.FREEZE = 0;
    }
    FAST is set unconditionally in the sideband branch, under a comment claiming
    the bit only applies to AM and FM. It is not decoration. Without it the part
    starts a validated tune, and the SSB patch never finishes one - which is
    exactly the shape of what we measured: the tune itself answers CTS at 10,
    100 and 500 ms, and then the first command after i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
2026-11-09 ANTCAP must not be 0 in SSB: the patch cannot tune its own varactor
    GET_REV after an SSB tune comes back as nine zero bytes, so it is not
    0x42/0x43/0x47 that are unimplemented - the tune wedges the part for every
    command that answers. 36 MHz from an integer divider changed nothing either,
    so it is not reference jitter.
    What it is, from the reference library's setPowerUp():
    currentFrequencyParams.arg.ANTCAPH = 0;
    currentFrequencyParams.arg.ANTCAPL = 1;
    Every AM and SSB tune there carries ANTCAP = 1, a fixed value, and the
    library never says why. ANTCAP = 0 means "tune the antenna capacitor
    yourself". The ROM firmware can do that, which is why AM has worked
    throughout. The SSB patch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
2026-11-09 Power up a second time after the patch, as the library does
    ANTCAP=1 did not fix it either. What is left is the one structural
    difference from the reference, and it is not a parameter but a step:
    loadPatch(): patchPowerUp() POWER_UP with PATCH=1
    downloadPatch()
    setSSBConfig() SSB_MODE
    setSSB(): radioPowerUp() POWER_UP with PATCH=0 <-- this
    setRefClock() + setRefClockPrescaler()
    setVolume()
    setFrequency()
    A second POWER_UP after a patch upload reads like something that would
    throw the patch away, which is presumably why I never wrote it. It does
    not, and it is what thousands of working receivers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
2026-11-09 Ask whether the chip is wedged or has dropped out
    The full reference sequence is now reproduced - patch power-up, upload,
    SSB_MODE, second power-up with the patch bit clear, reference clock in the
    library's order, FAST, ANTCAP=1 - and the fault is unchanged. That is six
    parameter theories in a row, so the premise is wrong: the trigger is not a
    command at all.
    The trigger is the tune. GET_REV dies after it and GET_REV cannot be
    unimplemented. And the tune is the moment the patched DSP starts doing real
    work, which no AM session ever asks of it.
    Which leaves two explanations needing opposite remedies:
    - a wedged DSP, recoverable only through the reset line
    - a part that has dropped out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
2026-11-09 Hand over the SSB lock-up: what it is, and what it is not
    Everything measured tonight, in one file: the exact failure signature with
    the step-by-step log, the nine theories that were tested and refuted with
    how each was refuted, the current bring-up sequence against the reference
    library's, the two reporting bugs that made earlier measurements
    unreadable, and the measurement traps that cost hours.
    The remaining hypotheses are ranked, with the one experiment that separates
    them already built into "rx ssbtest": a bare POWER_UP with the reset line
    untouched. If the chip comes back from that, it was never wedged - it had
    dropped out, and the answer is the supply rail at pin 14.
    Also records th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
2026-11-10 Stop accepting refusals as success, and diagnose what is actually run
    Three real defects, all of which made last night's measurements say less
    than they appeared to.
    ERR was being read as success. si_wait_cts() returned true on any status
    with bit 7 set, and 0xC0 means "CTS is back AND I refused what you sent".
    Every refusal in this driver has therefore been invisible - including a
    refused patch block, which leaves the DSP holding broken code. That would
    run perfectly until something asked it to work, which is precisely the
    shape of this fault: fine through the whole sequence, dead at the tune. The
    patch id reading back as 0x9D29 never ruled it out. The upload now names
    the failing block, i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
2026-11-10 Offer the 32.768 kHz reference every reference design actually uses
    Two eliminations from the first run with ERR checking, both worth having:
    The patch upload is clean. All 1979 blocks accepted, no ERR anywhere. A
    corrupted patch is not the explanation.
    The second POWER_UP is refused - status=0xC0, exactly as AN332 says for a
    part that is already running. So it has never done anything, here or in the
    reference library, whose waitToSend() only tests bit 7 and swallows the same
    refusal. That step is inert in both.
    And one more, from a comparison that was only possible now: a chip before
    POWER_UP answers 0x80, which this driver's own diagnosis has said all along.
    The dead chip answers 0x00.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
2026-11-10 SSB works: the reference clock was wrong for the whole patch upload
    GET_REV after an SSB tune: 81 20 31 30 9D 29 36 30 41
    The chip answers. It has not done that once in this project.
    REFCLK_FREQ defaults to 32768 and REFCLK_PRESCALE to 1 after POWER_UP, and
    this driver only corrected them after the patch had been uploaded. So the
    part spent the entire 2.9 second upload, and its whole initialisation,
    believing its reference was 32.768 kHz while 25 MHz arrived on the pin. No
    block was refused and the patch id read back correctly every time - and the
    patched DSP wedged on the first tune, every time.
    Feeding it a real 32.768 kHz fixes it. So does XOSCEN=1 during the patch
    power-up alone, wh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
2026-11-10 Report the reference in Hz, and drop a claim that is no longer true
    The enable notice printed "CLK2 (0 MHz)" because 0 is the internal marker
    for 32.768 kHz. And the diagnosis still said the tuner read-back is skipped
    in SSB because asking stops the chip answering - which was the bug, and the
    bug is fixed. The read-back stays off for now because RSSI and SNR answer
    the only question that matters, and because this is not the evening to
    re-introduce the one command that used to kill the receiver.
    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
2026-11-10 Take the half of the SSB fix that does not bury the receiver
    With the mixer LO switched off entirely, the noise floor stayed at 38-43
    dBuV. The LO contributes two decibels; the rest the radio makes itself.
    Yesterday the same band read 2-13 dBuV, and one thing changed between:
    the reference clock went from 25 MHz to 32.768 kHz.
    That had to happen. A 32.768 kHz square wave has harmonics every 32.768 kHz
    across the entire shortwave spectrum - at 19.4 MHz that is the 592nd, with
    its neighbours 32 kHz either side. The gentle humps at 19367, 19565 and
    19594 in the sweep sit on multiples of it. Thirty decibels of self-made
    noise laid over exactly the band being searched.
    But 32.768 kHz was only e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
2026-11-10 Hand over the level problem, and close out the SSB one
    HANDOVER_PEGEL.md: the Si4732 cannot see what an RTL-SDR hears at the same
    point on the same mixer output, and is 15 to 25 dB short of doing so.
    It carries every number measured: the chip's own linearity over 70 dB, its
    noise floor and the 46 dB noise figure that follows from it, what the mixer
    delivers with the LO on and off, and the RTL-SDR's reception at the same
    point which proves the RF chain works.
    Two explanations, both supported. The noise figures are not comparable -
    46 dB against 20 to 30 - and an earlier claim in this project that they were,
    with resolution bandwidth making up the difference, does not survive the
    operator ac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
2026-11-10 The SSB patch ignores REFCLK_FREQ and requires 32.768 kHz
    Sideband stopped hanging this afternoon but never received. With a -60 dBm
    carrier injected straight at pin 8, AM read 52 dBuV and USB read 0 - tuned
    1 kHz below it, inside a 2200 Hz passband, with volume at maximum.
    The patch ignores REFCLK_FREQ. On 36 MHz / 1125 = 32000 Hz every sideband
    tune came out 32768/32000 = 2.4 % high, which is 470 kHz at 19.6 MHz. Far
    outside any filter, which is why no amount of aiming found it, and why this
    looked like a receiver that did not work at all.
    Switching to a real 32.768 kHz, with nothing else changed: rssi 38, snr 9,
    and an audible tone. So 32.768 kHz is not one of two routes to working SSB,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
2026-11-10 Rewrite the level handover around what the evening actually established
    SSB receives now, and that changed the problem rather than solving it.
    The patch ignores REFCLK_FREQ and requires 32.768 kHz - proved by one
    command, with an injected carrier reading 0 in sideband on 32000 Hz and 38
    with snr 9 on 32.768 kHz, nothing else touched. So the earlier idea that
    XOSCEN=1 at the patch power-up was an equivalent route is wrong and is
    written down as wrong: it stops the hang and leaves sideband 470 kHz off
    frequency.
    And 32.768 kHz brings a comb. Harmonics every 32.768 kHz across the whole
    shortwave band lift the noise floor from 2-13 dBuV to 27-45, thirty decibels
    laid over exactly the band bein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
2026-11-11 Add a 32.768 MHz reference, and correct what was claimed about PLL A
    "rclk freq 32m": CLK2 = 32.768 MHz from PLL B at 864 MHz through
    26 + 47/128 (864e6 * 128 / 3375 = 32 768 000 Hz exactly), prescaler 1000,
    REFCLK_FREQ 32768. The chip then holds the 32768 Hz its SSB patch appears to
    assume, without a slow square wave laying harmonics every 32.768 kHz across
    the IF, and with PLL B left where CLK0 needs it. Untested on the bench; the
    default stays on the 32.768 kHz that is known to receive.
    The prescaler search now prefers an exact 32768 Hz whenever the clock allows
    one, instead of the smallest divisor that lands in the legal window.
    Correction. Commits 1b42d8d and a05e1ef say the 32.768 kH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
2026-11-11 32.768 MHz / 1000 does not receive either; add switches for what is left
    "rclk freq 32m" gave rssi 0 in sideband with the internal reference reading
    exactly 32768 Hz, the AGC wide open and no error anywhere. So "the patch
    assumes 32768 Hz internally" is refuted. What stands is narrower: sideband
    has only ever received with 32.768 kHz on the pin itself.
    One reading fits every run so far. The second POWER_UP is refused with 0xC0
    each time, so xoscen(patch)=1 leaves the part in crystal mode for as long as
    sideband runs, and in that mode the prescaler apparently does nothing. A high
    clock with XOSCEN genuinely 0 has never been reached in SSB without the hang.
    Two bench switches to try for it w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
2026-11-11 Roll the receiver's clock bookkeeping back when a switch is refused
    Switching the reference from 32.768 kHz to 32.768 MHz under a running
    sideband receiver stalls the chip - CTS stays low until the old clock is
    back on the pin. That closes the last software route to a high reference
    clock in SSB.
    It also exposed a half-finished rollback. The console command puts the
    SI5351 back when the receiver refuses, but si4732_set_rclk_hz() had already
    adopted the new clock and prescaler and kept them. The pin then carried
    32.768 kHz while the driver believed 32.768 MHz / 1000, and the next
    power-up would have programmed exactly that. Restored on failure now, with
    the old properties re-sent.
    Co-Author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
2026-11-11 Note the operator's ideas for later: 12 V supply, QMX-style USB audio
    Recorded in the resolution note with what already exists: the firmware
    enumerates as a UAC1 speaker (PC to radio, 48 kHz, 16-bit stereo, no
    feedback endpoint), which is the transmit path. The missing half for
    WSJT-X is a UAC1 microphone carrying the receiver audio from ADC1 back to
    the PC.
    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
2026-11-11 Note the LNB offset as a default for the next firmware
    NEXT_FW.md holds what is decided for the next build and, separately, what
    is only proposed. Decided: rx cal -4300, the measured Bullseye LO error,
    with the sign worked out against the driver's convention and the caveats
    that matter - it is persisted already, so a device with a stored value
    keeps it; the figure includes the RTL-SDR's own error; and it drifts with
    the LNB's TCXO until task #4 disciplines it.
    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
2026-11-11 Add "oled off|on" and "oled freeze" to isolate display noise
    A pulsing noise in the receiver is suspected to come from the OLED. The
    display can reach the receiver two ways, and they need different fixes:
    oled freeze 1 stop the 5 Hz frame refresh over I2C1, panel stays lit
    oled off panel and its charge pump off as well, refresh stopped
    oled on back to normal
    A 5 Hz refresh would match a pulsing sound; the charge pump runs
    continuously at a few hundred kHz. Neither setting is persisted.
    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
2026-11-11 Add "smps pwm 0|1" to test the Pico regulator as the headphone pulse
    The pulsing in the headphones survives the Si4732 being powered down,
    causes no ring underruns, and scales with the monitor level. So it enters
    at GP27 and rides the RX monitor path, not the receiver.
    The RX audio ADC is biased by a divider from 3V3, so whatever ripple 3V3
    carries arrives at half amplitude on the ADC. The Pico's SMPS runs in
    power-save at light load and switches in bursts, which is exactly a pulsing
    low-frequency ripple. GPIO23 drives its PS pin; high forces fixed PWM.
    The firmware never set it.
    Switchable for the test, not persisted, default unchanged.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
2026-11-11 Run the Pico SMPS in fixed PWM from boot
    "smps pwm 1" made the headphone pulse clearly quieter on the bench, which
    confirms the regulator's power-save bursts as a source: their ripple on 3V3
    reaches the RX audio ADC through its bias divider. GPIO23 is now driven
    high at the very start of main(). "smps pwm 0" still switches back for
    comparison.
    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
2026-11-11 Stop "rx mon agc" without a value from switching the monitor off
    With no value the command fell through to "rx mon <0|1>", strtol("agc")
    returned 0, and the monitor went off. The headphones went quiet and it read
    as every disturbance having vanished. The on/off and agc arguments are now
    parsed as booleans and anything else is refused.
    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
2026-11-11 GUI: add an RX tab for the Si4732 receiver
    Mode, frequency with step buttons, bandwidth, BFO, calibration and Si4732
    level; the three QO-100 beacons as one-click presets (USB, BFO 500, with
    the BFO sent after the frequency because "rx freq" resets it); headphone
    monitor on/off, level and audio AGC; reference clock and the device's own
    mixer LO; and a scan whose table lands in the console.
    Live RSSI and SNR come from the "!R" lines. While the RX tab is open the
    GUI sends "rx" once a second, unless the receiver last reported itself off
    - the firmware then appends a note to every answer and the console would
    fill with it. Fields the user is typing into are not overwritten by the
    live update.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
2026-11-11 CW audio filter and AGC level for the monitor; mute it while RX is off
    The Si4732's narrowest SSB filter is 500 Hz, too wide for a keyed beacon,
    and at volume 63 - the chip's 6-bit maximum - the beacon was still quiet.
    rx mon cw <width> [<centre>] two cascaded RBJ band-pass sections at
    8 kHz, 0 dB at the centre, ahead of the
    AGC so the AGC levels the tone and not the
    noise around it. 150/600: -3 dB at about
    +-45 Hz, -32 dB 300 Hz away.
    rx mon cw 0 off
    rx mon level <5..90> AGC target in % of full scale, default 25
    The monito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
2026-11-11 Monitor AGC: hold after a signal, slower release, gain ceiling
    The beacon is keyed, and in every gap between elements the AGC climbed back
    towards +36 dB within about 0.2 s, so the noise swelled each time. The AGC
    now holds its gain for 400 ms after the signal last pulled it down, then
    releases with a ~1.5 s time constant - the usual shape for CW.
    rx mon maxgain <0..36> gain ceiling in dB, default 36
    rx mon hang <0..3000> hold time in ms, default 400
    rx mon poll 0|1 the 5 Hz RSSI/SNR poll over I2C for the display,
    switchable to test it as the source of crackle
    GUI: sliders for ceiling and hold, and a checkbox for the poll.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
2026-11-12 Fix RX calibration defaults and report configured tuning
    Apply the provisional -4300 Hz calibration consistently on cold start, restored settings and defaults, preserving valid saved offsets. Expose requested and configured IF, nominal frequency and raw BFO overrides. Include Git build identity, reconcile the receiver handover and wiring notes, and add native driver regression checks.
2026-11-12 Fix GUI reconnect and visible RX console replies
    Close failed serial readers and isolate connections across reconnects. Keep RX command replies visible independently of push-message filtering, parse Git-tagged firmware versions, recover polling after OFF states and expose stale measurements. Add headless regression coverage for transport and GUI status recovery.
